HAND42/Polydog-Robotic_Project_2022-2023/session-reports/reports_younes-bazi/session4/session4.md

# SESSION 4 OUTCOME REPORT
## Date: 15/11/2022
## Main event of the session: Inverse Kinematics.
As i was searching for more informations about the stabilization of the robot, I found that the study of inverse Kinematics are essential for the balance of the Polydog, because Inverse kinematics is the use of kinematic equations to determine the motion of a robot to reach a desired position, it is used to compute an appropriate state in a robot's configuration space, given a target position in task space, in the other hand PID control applies responsive correction signals to a robot's actuators, allowing it to reach its target accurately. A reliable inverse kinematic solution is NECESSARY for programming a robot to perform tasks, this why I decided to do an inverse kinematics study of our robot before we go on with the PID tuning .  
First thing first , our robot has 4 legs and each one has 3 movable parts (3DOF) which makes it a total of 12 joint angles that we should determine. But in order to make things more easier, we are going to implement Kinematics of the PolyDog on Python. And to verify all the calculations happening here, it is helpful to have some kind of visual output ,so we are going to use Matplotlib.   
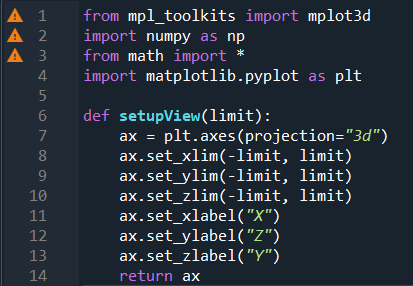
[picture p71: session-reports/reports_younes-bazi/session4/Capture d’écran 2022-11-18 231915.png]
  
We then start with solving the Leg's Inverse Kinematics and calculate (theta1,theta2,theta3) our output angles for a given Foot-Position (x,y,z) in Leg-Space. The Leg's origin (the shoulder) is at (0,0,0). l1,l2,l3 and l4 are the length of the Leg's Segments.  
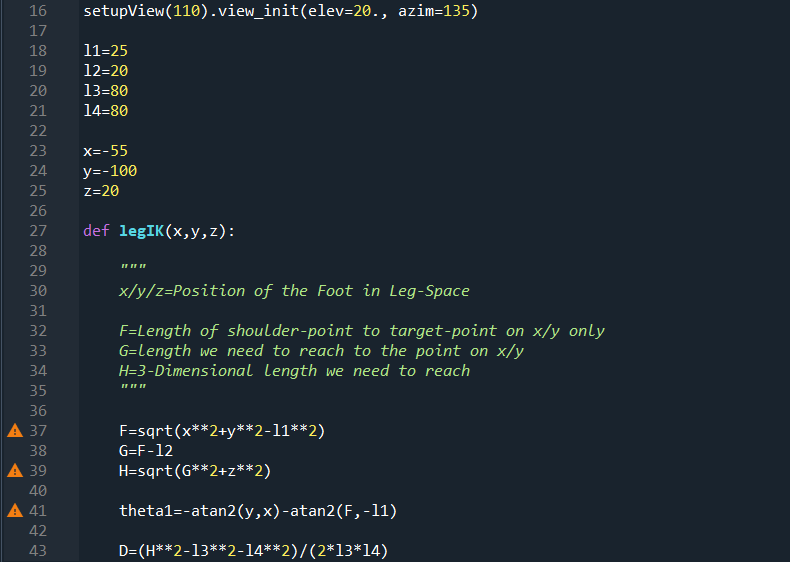
[picture p72: session-reports/reports_younes-bazi/session4/Capture d’écran 2022-11-18 232825.png]
  
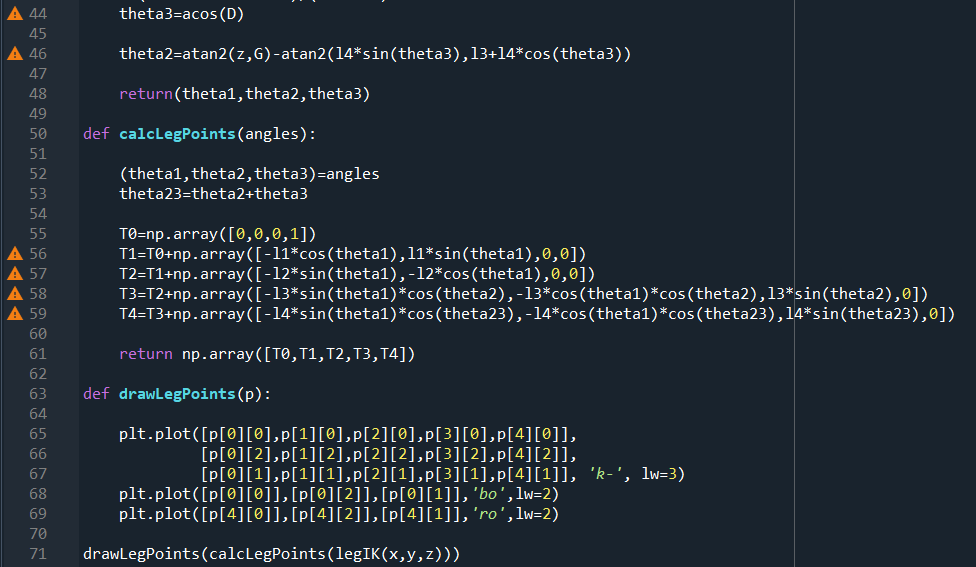
[picture p73: session-reports/reports_younes-bazi/session4/Capture d’écran 2022-11-18 232921.png]
  
Here is the result :  
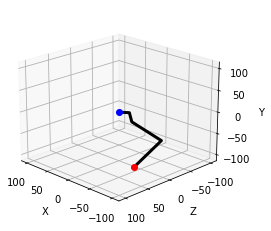
[picture p74: session-reports/reports_younes-bazi/session4/Figure 2022-11-18 233309.png]
  
And now the code works , we can test some different Target-Positions.  
  
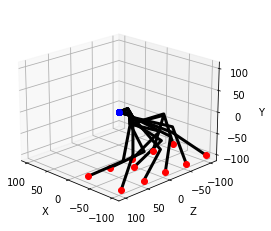
[picture p75: session-reports/reports_younes-bazi/session4/Figure 2022-11-18 234242.png]
  
To be able to calculate a Leg's Pose, we need to know where it starts when the Body has a specific Pose. The Pose is defined by omega,phi and psi (Remember, these are the Euler angles that the 10 DOF sensor will provide us with) and xm,ym and zm are the Center of the Body.  
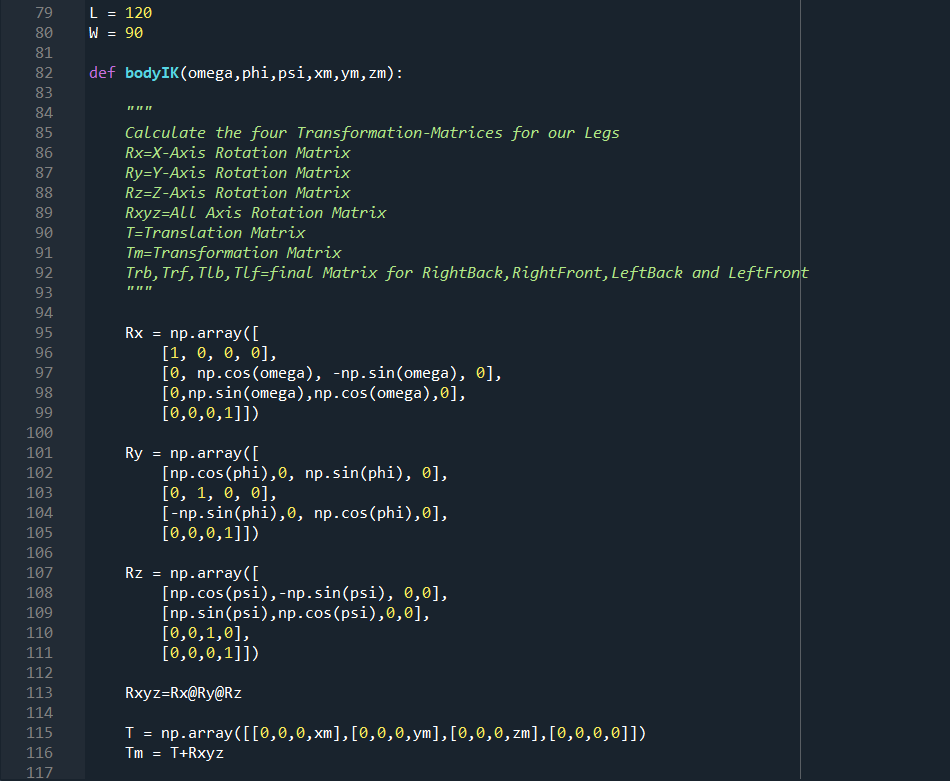
[picture p76: session-reports/reports_younes-bazi/session4/Capture d’écran 2022-11-18 235415.png]
  
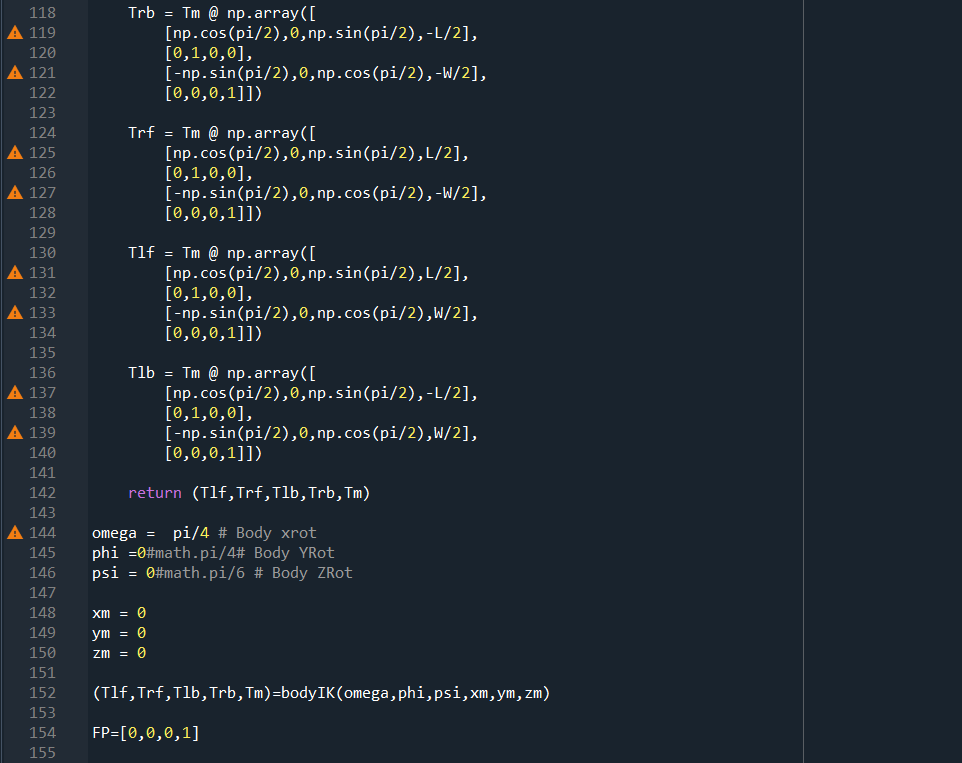
[picture p77: session-reports/reports_younes-bazi/session4/Capture d’écran 2022-11-18 235441.png]
  
  
Here is the result for the body Part :  
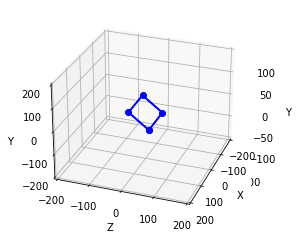
[picture p78: session-reports/reports_younes-bazi/session4/Figure 2022-11-18 235512.png]
  
Now we need to combine the Body's Kinematics with the four Legs. Input will be the Body-Pose (omega,phi,psi,xm,ym,zm) that will be given by the 10 DOF sensor and Positions for all four Legs in World-Space (Lp).  
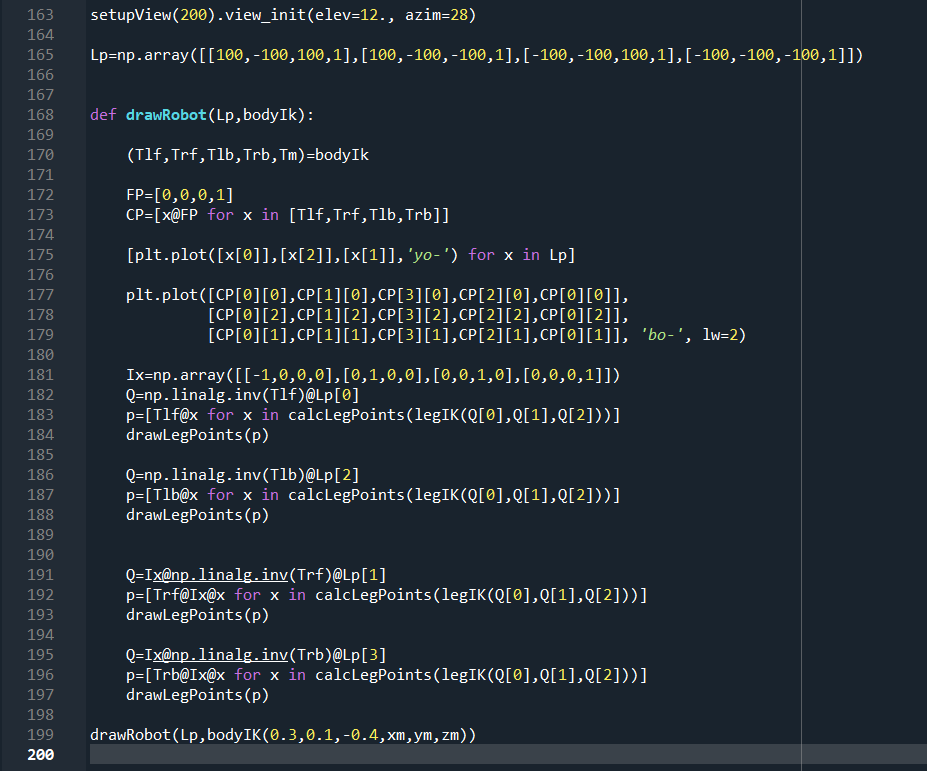
[picture p79: session-reports/reports_younes-bazi/session4/Capture d’écran 2022-11-19 000535.png]
  
  
We can now apply some random poses on the Robot's Body to verify the correctness of all Legs.  
  
  
Now the calculations work, i will try next week to implement kinemactis on the arduino board , and try to do some poses on the real Polydog to see if it really works in real life.
