HAND42/Polydog-Robotic_Project_2022-2023/session-reports/reports_hugo-durand/session16/Equation.docx

According to the Al Kashi's theorem

CH^2 =CD^2 +DH^2 -2×DH×CD×cos(Ω)

So Ω=cos^(-1) ((DE^2 +CD^2 -CE²)/(2×CD×DE))

γ=π-(π/2-θ)-Ω=(π/2+θ)-Ω

(Valid for both configurations)

α=π/2+γ

( γ is negative or positive)

AH=√(DA^2 +DH^2 -2×DA×DH×cos(α))

Փ=cos^(-1) ((-DH^2 +DA^2 +AH²)/(2×DA×AH))

EG=sin⁡(abs(β-Փ))×AH

{, AG=cos⁡(abs(β-Փ))×AH+HE, EG=sin(abs(β-Փ))×AH

Finally, the Cartesian coordinates of the foot are:

OE=(OA×sin(φ)+AG)*z+EG*y+OA×cos⁡(φ)*x

We define hip_angle = Ħ and knee_angle = ĸ

Knowing the position of the leg AE, we have:

HA=√(EG^2 +(AG-HE)²)

We can define ε=cos^(-1) (((AG-HE))/(AH))

Փ=cos^(-1) ((-DH^2 +DA^2 +AH²)/(2×DA×AH))

α= cos^(-1) ((DH^2 +DA^2 -AH²)/(2×DA×DH))

Ħ =π/2-Փ-ε or Ħ =π/2-Փ+ε

Depends on if the leg is in front or behind the hip

ĸ=θ-Ħ

ĸ=Ω-π/2-Ħ+γ or ĸ=Ω-π/2-Ħ -γ

ĸ=Ω+α-π-Ħ or ĸ=Ω-α-Ħ

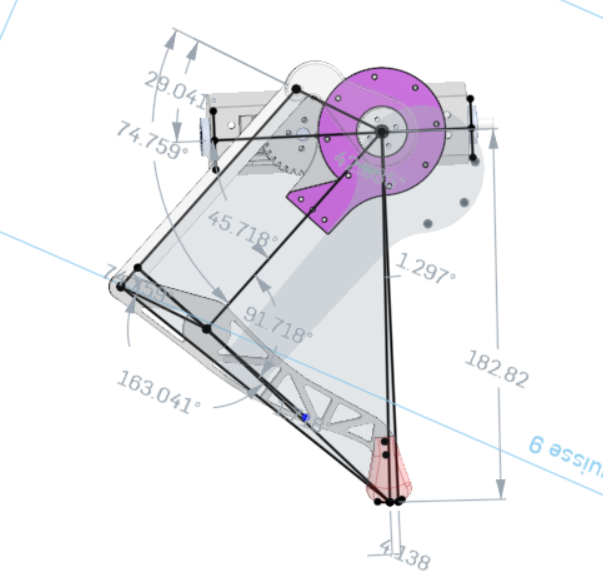
[picture p112: figure]
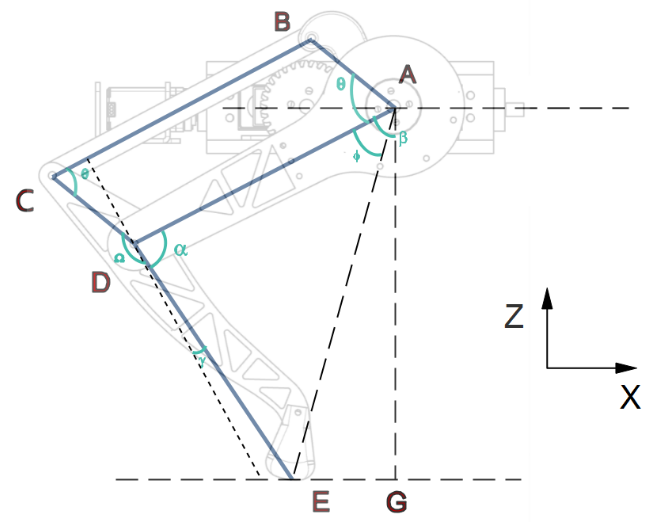
[picture p113: figure]
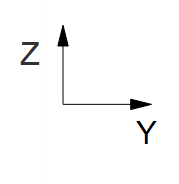
[picture p114: figure]
