HAND42/Polydog-Robotic_Project_2022-2023/CODE/NVIDIA/TD-9-11-22/younes-bazi-linux-project/Linux_project/younes-bazi-linux-project/td linux/Capture d’écran 2022-11-23 160426.png

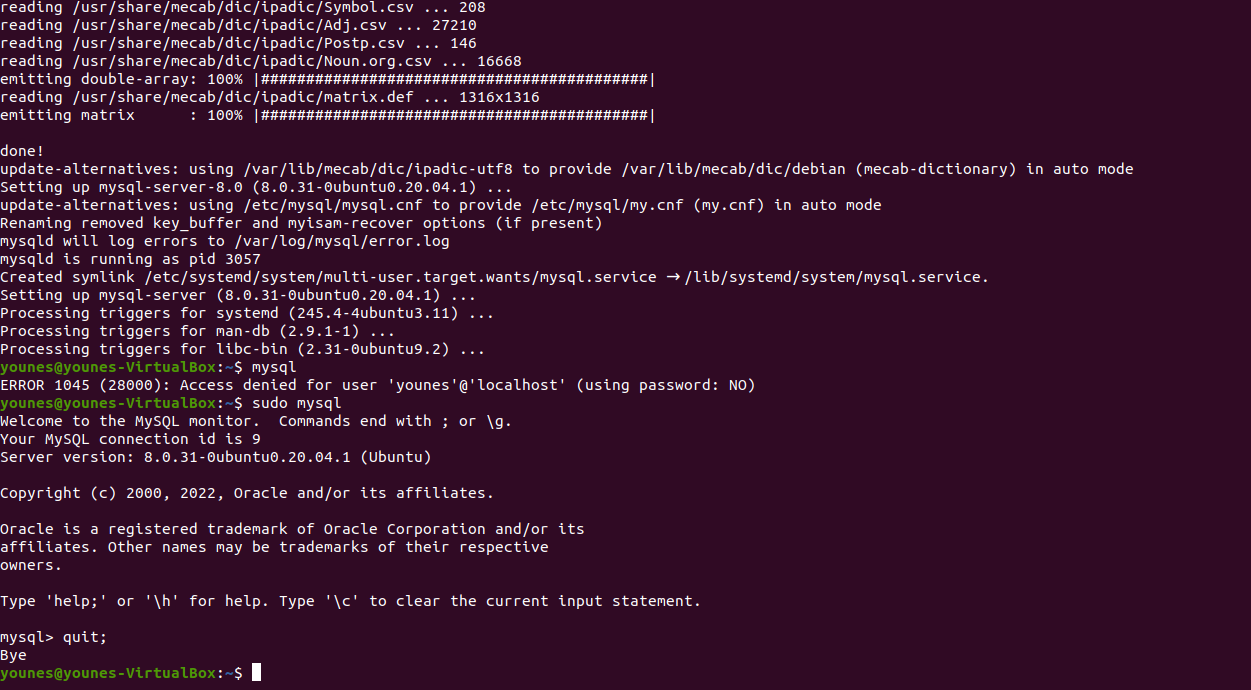
CODE/NVIDIA/TD-9-11-22/younes-bazi-linux-project/Linux_project/younes-bazi-linux-project/td linux/Capture d’écran 2022-11-23 160426.png
