HAND42/Polydog-Robotic_Project_2022-2023/Drone Interception/Unreal engine/simulation/Saved/AutoScreenshot.png

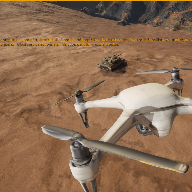
Drone Interception/Unreal engine/simulation/Saved/AutoScreenshot.png
