HAND42/Polydog-Robotic_Project_2022-2023/Multimedia/WhatsApp Image 2022-07-30 at 16.42.59.jpeg

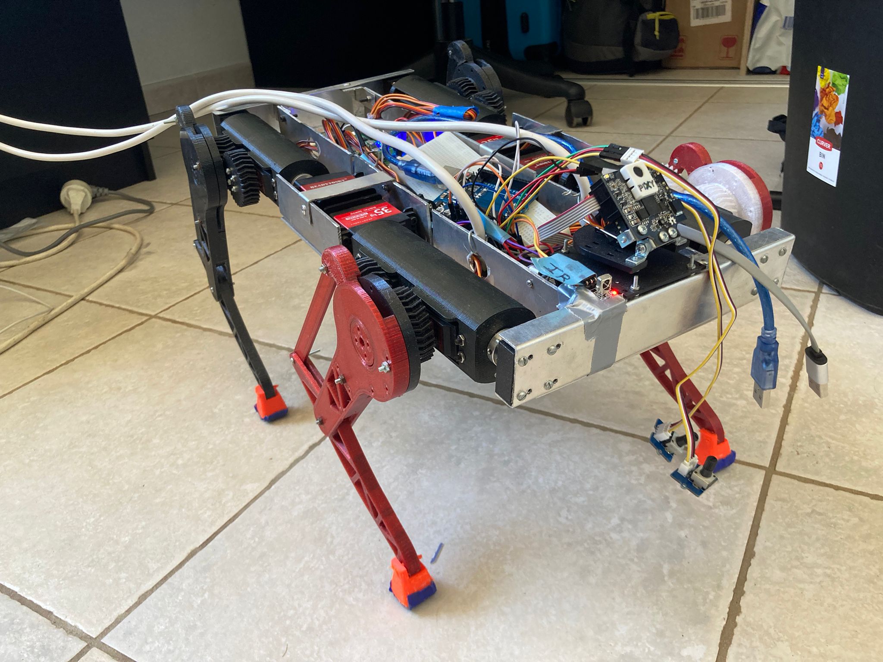
Multimedia/WhatsApp Image 2022-07-30 at 16.42.59.jpeg
