HAND42/Polydog-Robotic_Project_2022-2023/session-reports/reports_hugo-durand/session1/gear_pla.jpeg

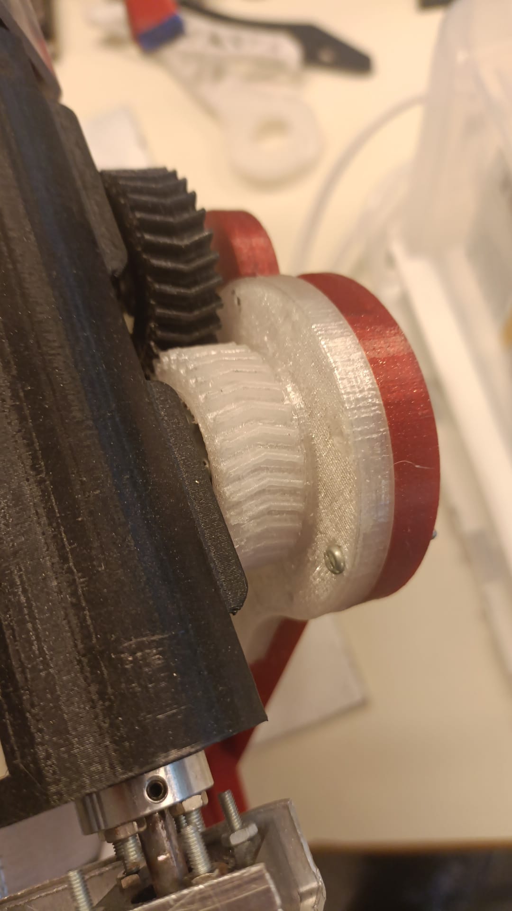
session-reports/reports_hugo-durand/session1/gear_pla.jpeg
