HAND42/Polydog-Robotic_Project_2022-2023/session-reports/reports_hugo-durand/session1/image_robot_session1.jpeg

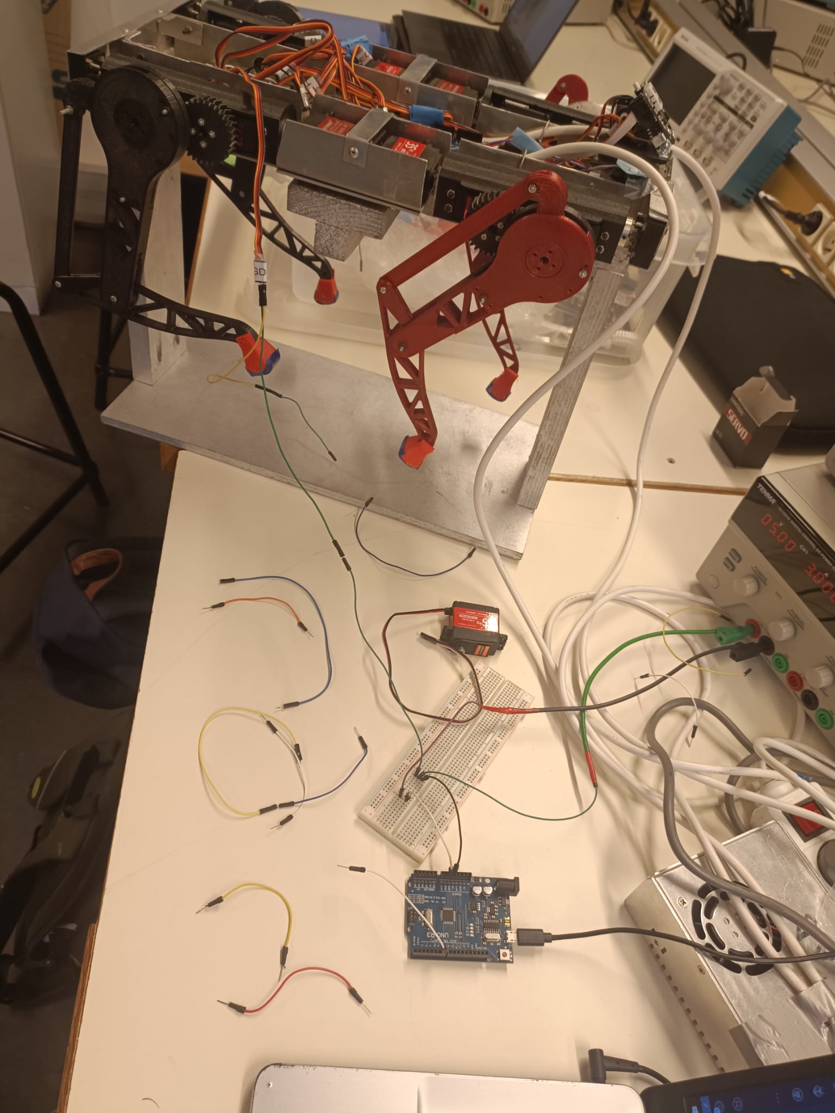
session-reports/reports_hugo-durand/session1/image_robot_session1.jpeg
