HAND42/Polydog-Robotic_Project_2022-2023/session-reports/reports_hugo-durand/session2/robots_standing_up_again.jpeg

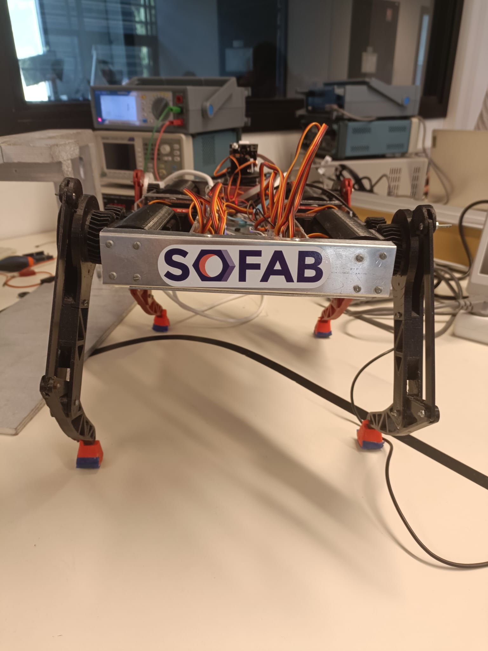
session-reports/reports_hugo-durand/session2/robots_standing_up_again.jpeg
