HAND42/Polydog-Robotic_Project_2022-2023/session-reports/reports_hugo-durand/session3/female_conector.jpeg

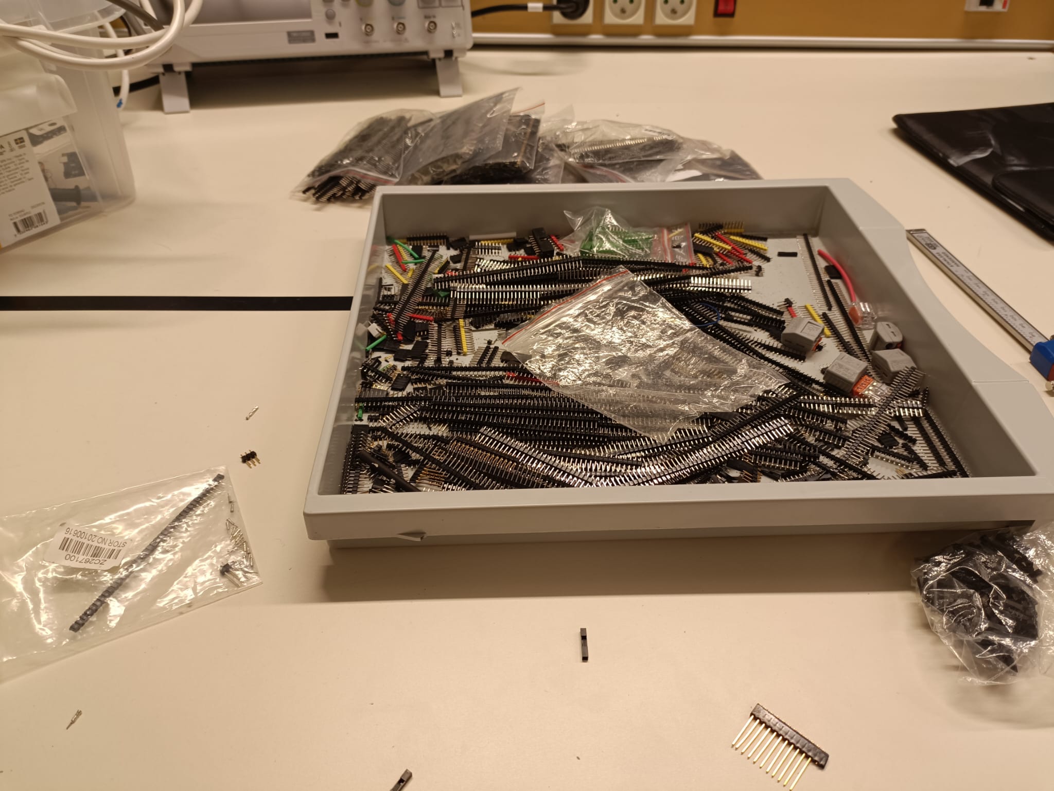
session-reports/reports_hugo-durand/session3/female_conector.jpeg
