HAND42/Polydog-Robotic_Project_2022-2023/session-reports/reports_hugo-durand/session4/errors.PNG

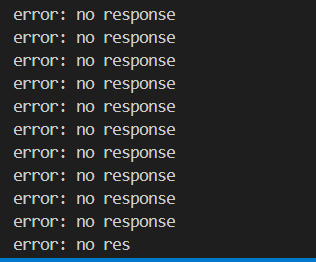
session-reports/reports_hugo-durand/session4/errors.PNG
