HAND42/Polydog-Robotic_Project_2022-2023/session-reports/reports_hugo-durand/session5/WhatsApp Image 2022-12-02 at 09.24.47.jpeg

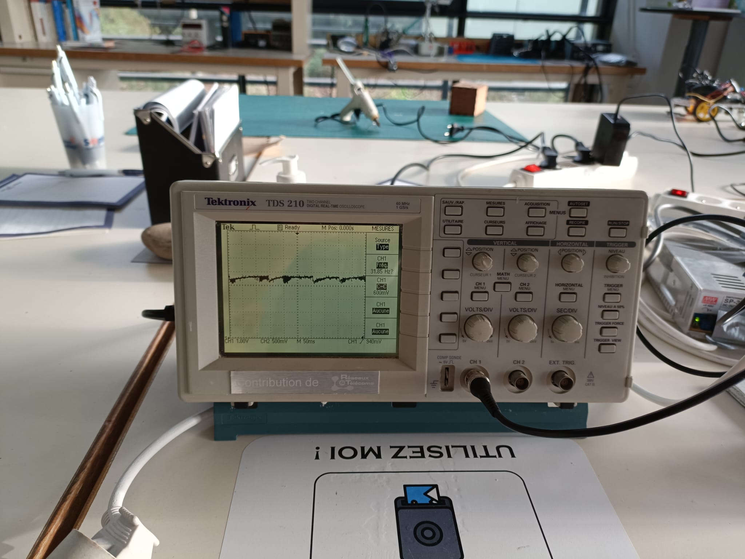
session-reports/reports_hugo-durand/session5/WhatsApp Image 2022-12-02 at 09.24.47.jpeg
