HAND42/Polydog-Robotic_Project_2022-2023/session-reports/reports_hugo-durand/session16/Equation_angle_of_the_foot.png

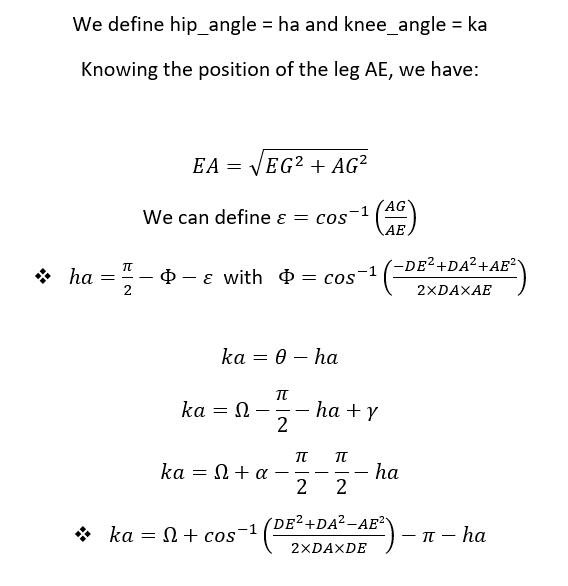
session-reports/reports_hugo-durand/session16/Equation_angle_of_the_foot.png
