HAND42/Polydog-Robotic_Project_2022-2023/session-reports/reports_younes-bazi/session5/Session05/20221126_153211.jpg

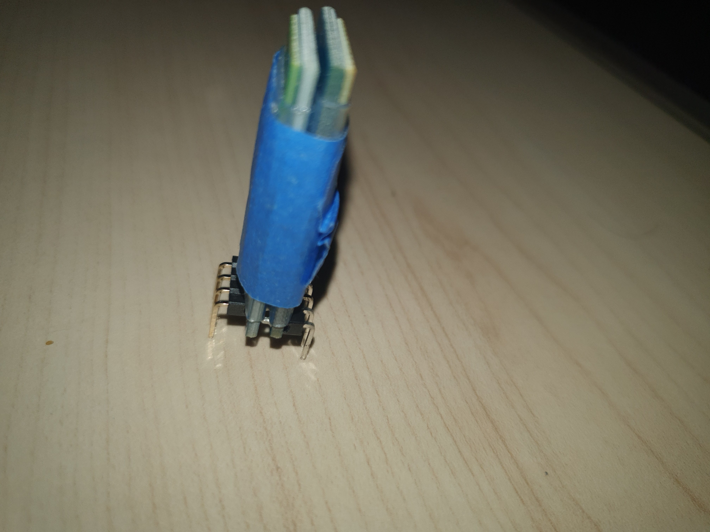
session-reports/reports_younes-bazi/session5/Session05/20221126_153211.jpg
