HAND42/Polydog-Robotic_Project_2022-2023/session-reports/reports_younes-bazi/session6/S6/20221209_115030.jpg

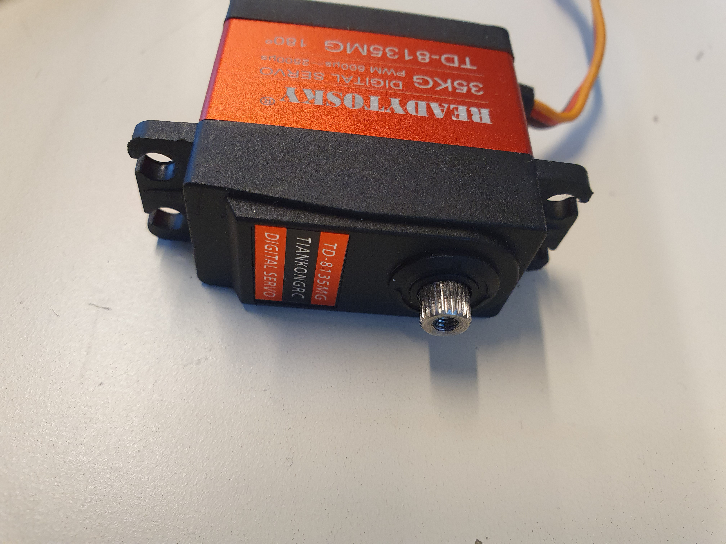
session-reports/reports_younes-bazi/session6/S6/20221209_115030.jpg
