HAND42/Polydog-Robotic_Project_2022-2023/material and engineer cost.xlsx

Material name | Type of material | Price (in €)
Arduino UNO | Electronic Component | 20 | Material | Price (in €)
Ssc-32 Servo controller | Electronic Component | 22.33 | Electronic Component | 212.45
Servo motors | Electronic Component | 106.08 | 3D Printing | 14.32
10 DOF Accelerometer | Electronic Component | 6.49 | Aluminium | 13.2
HC-O5 Bluetooth module | Electronic Component | 3.87 | Accessories | 14.8
Arduino Esplora Remote | Electronic Component | 53.68 | SOUS-TOTAL | 254.77
Printed parts (legs, boards and bearings support,..) | 3D printing | 14.32
Aluminum plate | Aluminium | 7.2 | Cost engineer | Hoorly rate (23.75 €/h)
Aluminium square | Aluminium | 3.6 | Sessions in robotics class | 172
Aluminium square for bearings | Aluminium | 2.4 | Sessions at home | 160
Servo horns (hip and knee) | Accesorries | 6.8 | SOUS-TOTAL | 7885
Squash balls | Accesorries | 8 | TOTAL | 8139.77
 |  |  | S
