HAND42/Polydog-Robotic_Project_2022-2023/Boitier_Arduino/Durand Hugo/Plastic_component.3mf

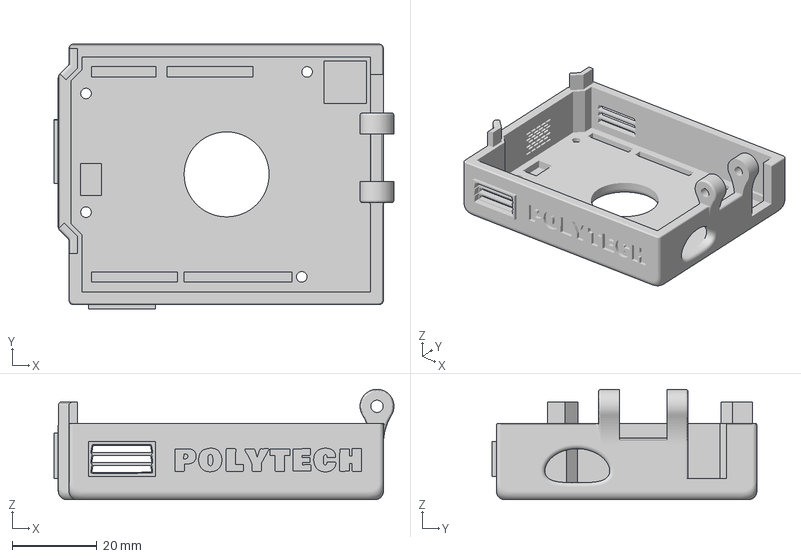
[picture p151: CAD file, 2023-01-20]
Boitier_Arduino/Durand Hugo/Plastic_component.3mf
80.1 x 62.3 x 26.0 mm
