HAND42/Polydog-Robotic_Project_2022-2023/new-3D-printed-part/boitier v2 - boitier.stl

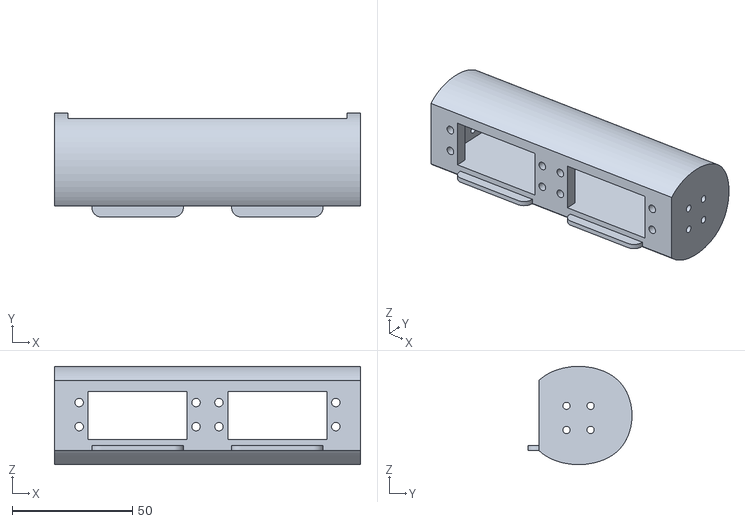
[picture p152: CAD file, 2022-10-14]
new-3D-printed-part/boitier v2 - boitier.stl
127.0 x 43.2 x 40.8
