HAND42/Polydog-Robotic_Project_2022-2023/polydog_ws_ROS/polydog_ws/polydog_ws/src/polydog_description/meshes/case_collision.obj

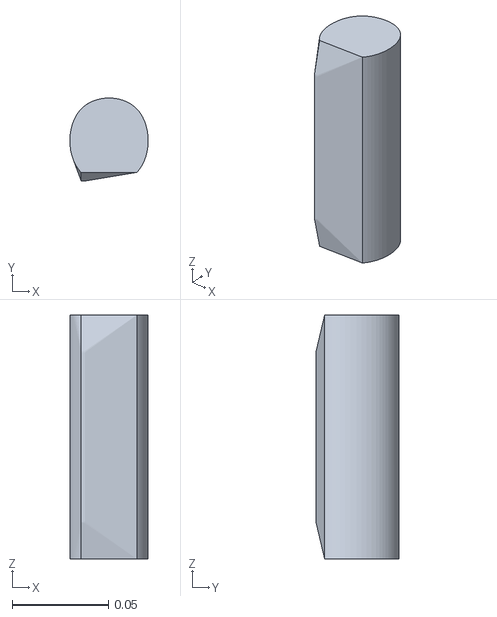
[picture p153: CAD file, 2025-01-26]
polydog_ws_ROS/polydog_ws/polydog_ws/src/polydog_description/meshes/case_collision.obj
0.0408 x 0.0432 x 0.127
