HAND42/Polydog-Robotic_Project_2022-2023/Boitier_Arduino/Durand Hugo/Plastic_link_component.3mf

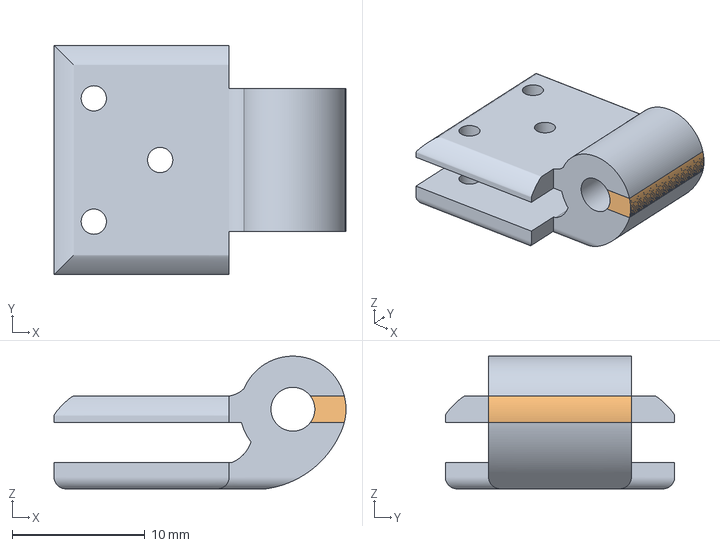
[picture p154: CAD file, 2023-01-20]
Boitier_Arduino/Durand Hugo/Plastic_link_component.3mf
22.0 x 17.3 x 10.00 mm
Corps1
Corps2
