HAND42/Polydog-Robotic_Project_2022-2023/polydog_ws_ROS/polydog_ws/polydog_ws/src/polydog_description/meshes/femur.obj

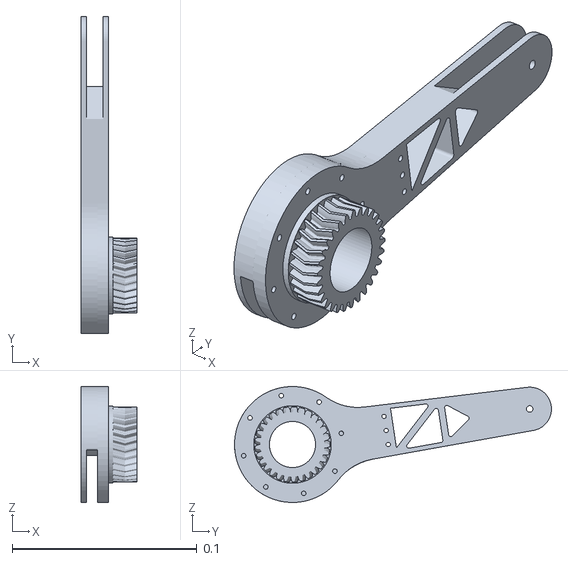
[picture p156: CAD file, 2025-01-26]
polydog_ws_ROS/polydog_ws/polydog_ws/src/polydog_description/meshes/femur.obj
0.0303 x 0.172 x 0.0629
