HAND42/Polydog-Robotic_Project_2022-2023/polydog_ws_ROS/polydog_ws/polydog_ws/src/polydog_description/meshes/body_collision.obj

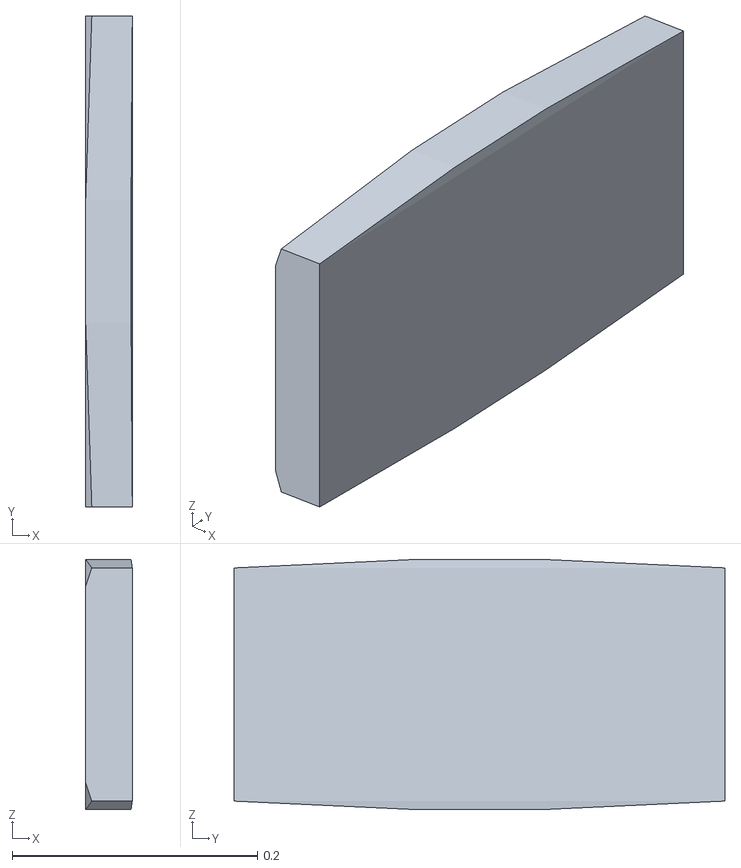
[picture p157: CAD file, 2025-01-26]
polydog_ws_ROS/polydog_ws/polydog_ws/src/polydog_description/meshes/body_collision.obj
0.038 x 0.4 x 0.204
