HAND42/Polydog-Robotic_Project_2022-2023/polydog_ws_ROS/polydog_ws/polydog_ws/src/polydog_description/meshes/tibia.obj

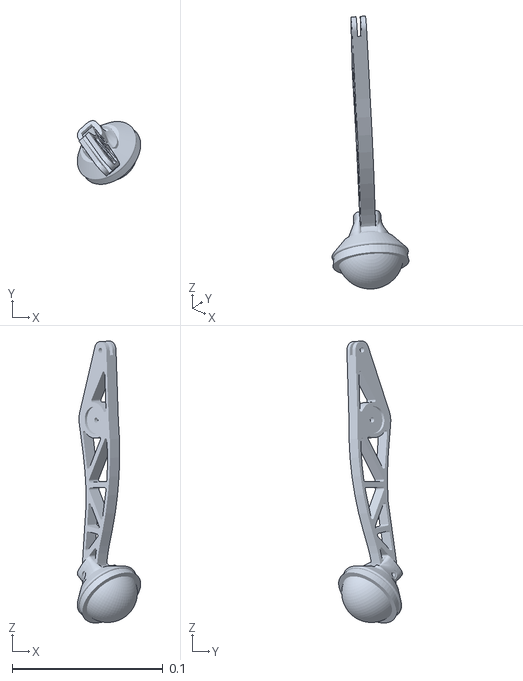
[picture p158: CAD file, 2025-01-26]
polydog_ws_ROS/polydog_ws/polydog_ws/src/polydog_description/meshes/tibia.obj
0.0421 x 0.0423 x 0.187
