HAND42/Polydog-Robotic_Project_2022-2023/(list of files, cad)

Other CAD files:
Boitier_Arduino/Durand Hugo/ArduinoUNO-Housing.f3d
Boitier_Arduino/Younes-Bazi/Boitier Arduino v1.f3d
