HAND42/Polydog-Robotic_Project_2022-2023/NVIDIA/TD-9-11-22/younes-bazi-linux-project/Linux_project/younes-bazi-linux-project/setup-dump-database-logs-cleanup.md

In order to modify the size of the logfile of the script we use this command :  
truncate -s 500 MB /var/log/yourlogfile  
if we assume that we delete the data from the file when it reaches 500 MB with this command :  
if [ "$logfile" -gt 500 MB ]   
then   
    truncate -s 0 $logfile  
    
fi  
Then we can choose a size limit that only dumps the logs when the file has done a number of repetitions we determined.
