HAND42/Polydog-Robotic_Project_2022-2023/NVIDIA/TD-9-11-22/younes-bazi-linux-project/Linux_project/younes-bazi-linux-project/setup-dump-database-service.md

we create the service "dump-database.service" using this command :  
sudo touch /etc/systemd/system/dump-database.service  
with this command :  
sudo systemctl daemon-reload  
we can reload the system , return all generators, reload all unit files, and recreate the entire dependency tree.
we Then start the service with this command :  
sudo systemctl start dump-database.service  
to see the status of the service we type this command :  
sudo systemctl status dump-database.service
