HAND42/Polydog-Robotic_Project_2022-2023/NVIDIA/TD-9-11-22/younes-bazi-linux-project/Linux_project/younes-bazi-linux-project/Setup-Mysql.md

 In order to insatll Mysql on our VM, we need to update first the packages with this command:  
sudo apt update  
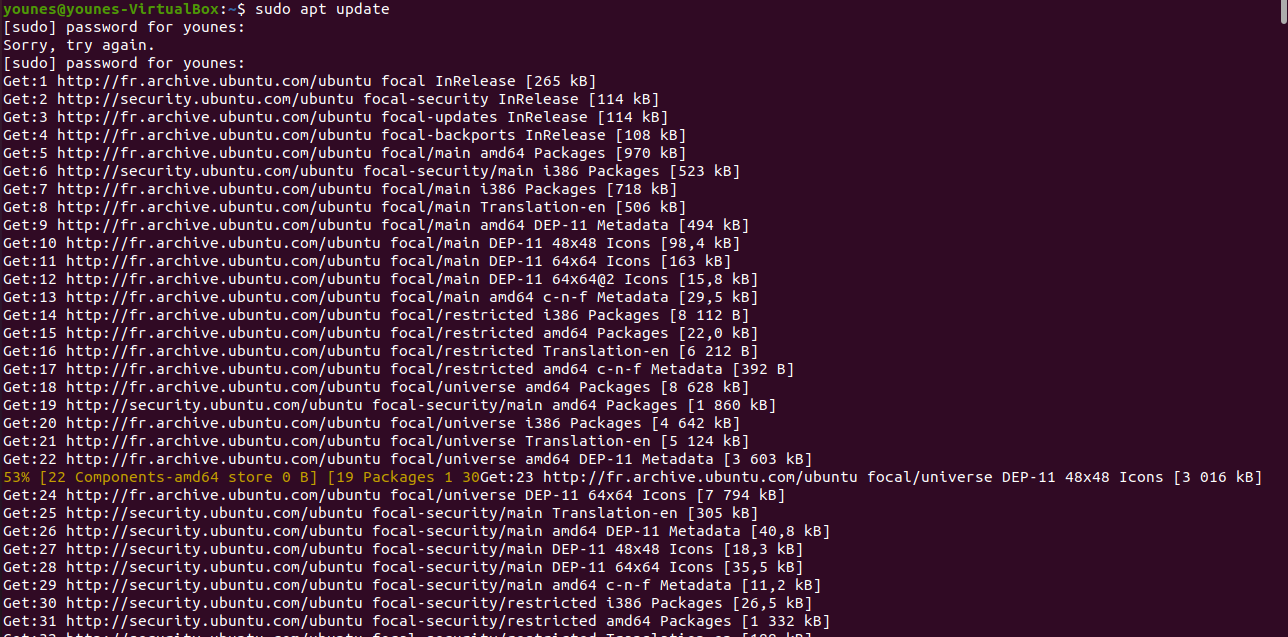
[picture p190: NVIDIA/TD-9-11-22/younes-bazi-linux-project/Linux_project/younes-bazi-linux-project/td linux/Capture d’écran 2022-11-23 160326.png]
  
Then we can start the installation of Mysql with this command :    
sudo apt install mysql-server    
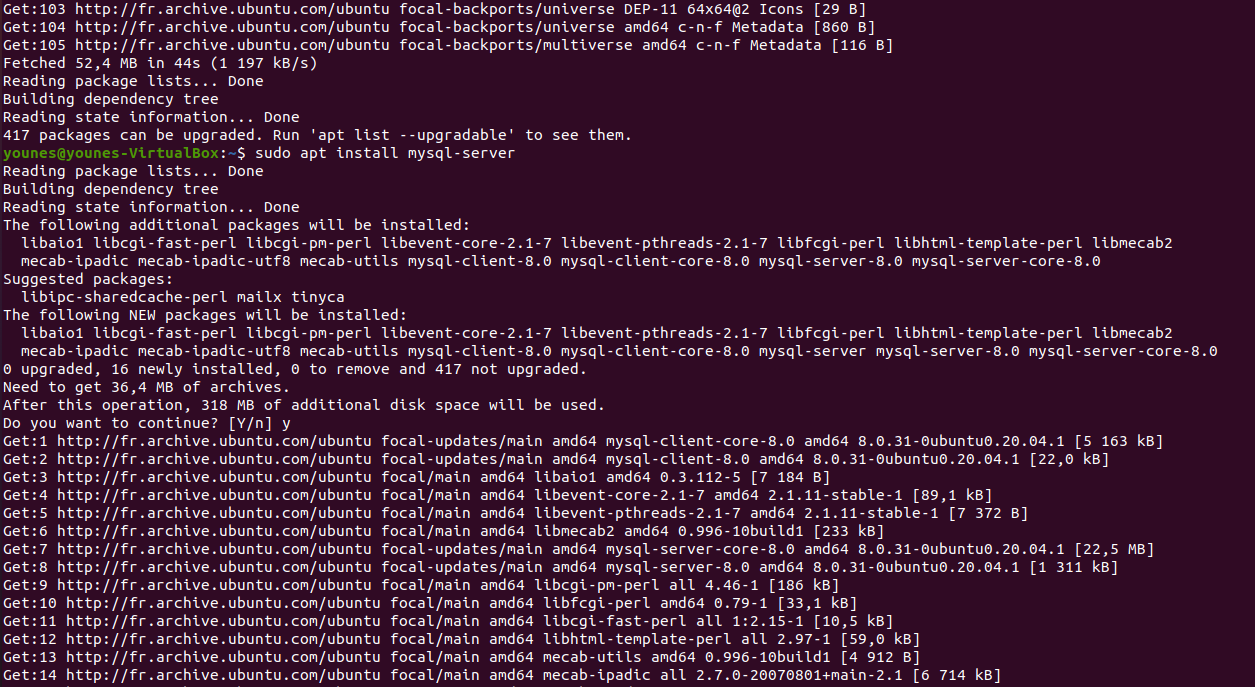
[picture p191: NVIDIA/TD-9-11-22/younes-bazi-linux-project/Linux_project/younes-bazi-linux-project/td linux/Capture d’écran 2022-11-23 160406.png]

To creat a database from the following backup file: https://www.mysqltutorial.org/wp-content/uploads/2018/03/mysqlsampledatabase.zip, we download it first, and then we unzip it using the following command :  
cd ~/Downloads  
unzip mysqlsampledatabase.zip   
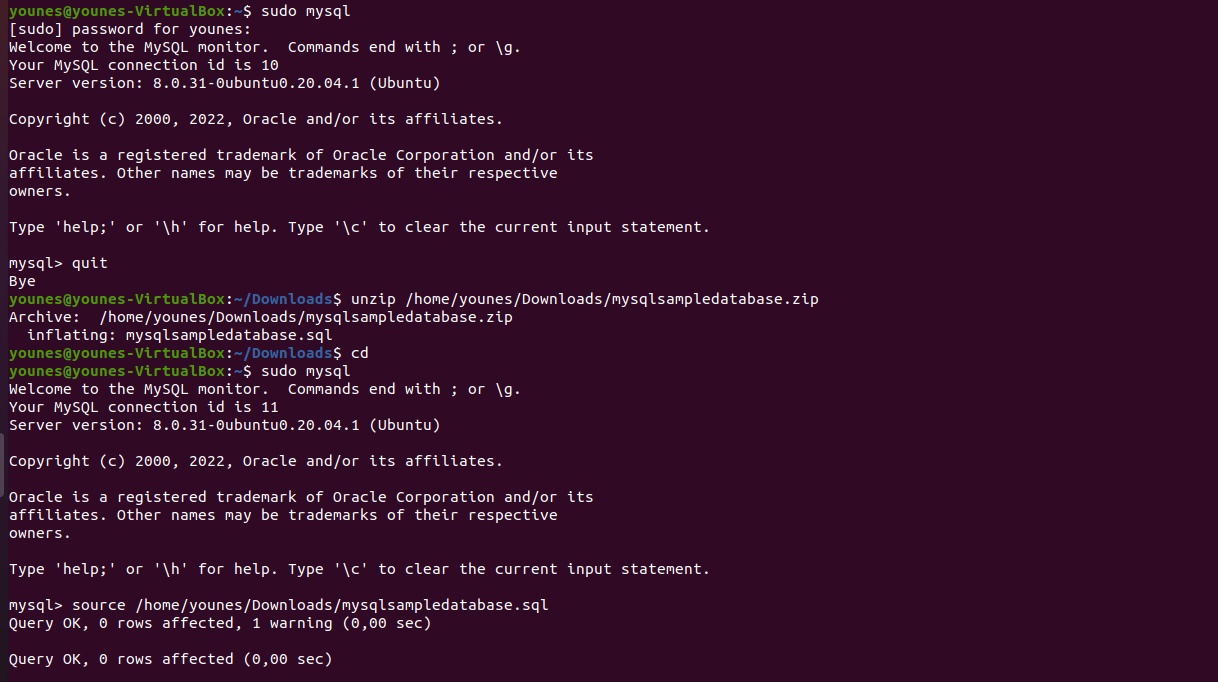
[picture p192: NVIDIA/TD-9-11-22/younes-bazi-linux-project/Linux_project/younes-bazi-linux-project/td linux/Capture d’écran 2022-11-23 160825.png]

and then we enter to mysql using :  
sudo mysql  
And then we declare the new database using this command :  
source /home/younes/Downloads/mysqlsampledatabase.sql  
And finally we can show the database by using this command :  
show databases;
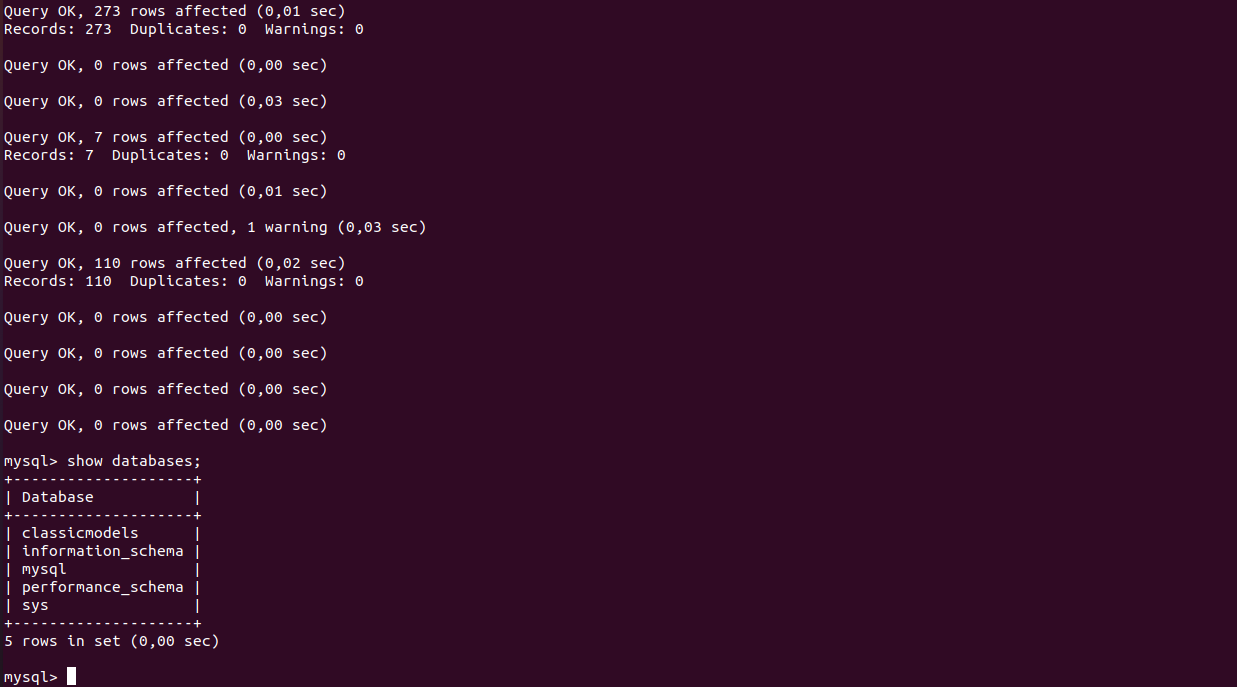
[picture p193: NVIDIA/TD-9-11-22/younes-bazi-linux-project/Linux_project/younes-bazi-linux-project/td linux/Capture d’écran 2022-11-23 160843.png]
