HAND42/Polydog-Robotic_Project_2022-2023/CODE/NVIDIA/Robotic_project/Getting_started-images/disk.jpeg

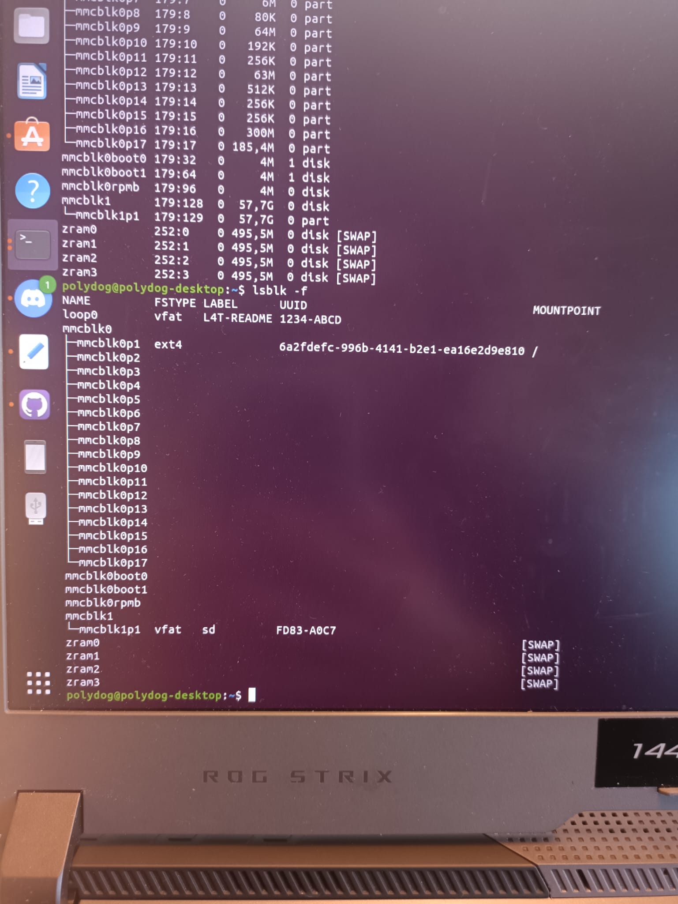
CODE/NVIDIA/Robotic_project/Getting_started-images/disk.jpeg
