HAND42/Polydog-Robotic_Project_2022-2023/session-reports/reports_hugo-durand/session1/movement_alimented_acpowersupply_test1.gif

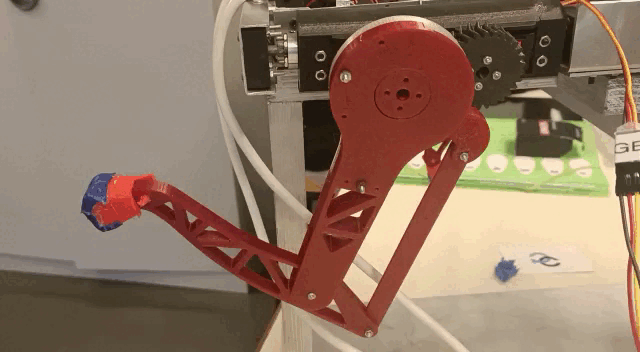
session-reports/reports_hugo-durand/session1/movement_alimented_acpowersupply_test1.gif
