HAND42/Polydog-Robotic_Project_2022-2023/session-reports/reports_younes-bazi/poly/polydog.urdf

<?xml version="1.0"?>
<robot name="Body">
    <link name="robot_base">
        <inertial>
            <origin rpy="-0.000000 -1.570796 0.000000" xyz="3.085511 -5.252829 0.187957" />
            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
            <mass value="2.4" />
        </inertial>
        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
    </link>
    <joint type="revolute" name="Shoulder4">
        <axis xyz="0 0 1" />
        <limit velocity="6.2831854820251" lower="-3.1415927410126" effort="2.5" upper="3.1415927410126" />
        <parent link="robot_base" />
        <child link="Case4" />
        <origin rpy="3.078568 1.588567 -0.083163" xyz="2.955599 -5.173379 0.196405" />
    </joint>
    <link name="Case4">
        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
    </link>
    <joint type="revolute" name="Hip4">
        <axis xyz="0 0 1" />
        <limit velocity="6.2831854820251" lower="-3.1415927410126" effort="2.5" upper="3.1415927410126" />
        <parent link="Case4" />
        <child link="Femur4" />
        <origin rpy="1.570796 -1.570796 0.000000" xyz="-0.000000 0.005000 0.021000" />
    </joint>
    <link name="Femur4">
        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
    </link>
    <joint type="revolute" name="Knee4">
        <axis xyz="0 0 1" />
        <limit velocity="6.2831854820251" lower="-3.1415927410126" effort="2.5" upper="3.1415927410126" />
        <parent link="Femur4" />
        <child link="Tibia4" />
        <origin rpy="-3.141593 3.141593 -3.141593" xyz="0.078146 -0.104211 0.032297" />
    </joint>
    <link name="Tibia4">
        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
    </link>
    <joint type="revolute" name="Shoulder1">
        <axis xyz="0 0 1" />
        <limit velocity="6.2831854820251" lower="-3.1415927410126" effort="2.5" upper="3.1415927410126" />
        <parent link="robot_base" />
        <child link="Case1" />
        <origin rpy="3.078568 1.588567 -0.083163" xyz="3.193513 -5.178169 0.192184" />
    </joint>
    <link name="Case1">
        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
    </link>
    <joint type="revolute" name="Hip1">
        <axis xyz="0 0 1" />
        <limit velocity="6.2831854820251" lower="-3.1415927410126" effort="2.5" upper="3.1415927410126" />
        <parent link="Case1" />
        <child link="Femur1" />
        <origin rpy="1.570796 -1.570796 0.000000" xyz="-0.000000 0.005000 -0.041000" />
    </joint>
    <link name="Femur1">
        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
    </link>
    <joint type="revolute" name="Knee1">
        <axis xyz="0 0 1" />
        <limit velocity="6.2831854820251" lower="-3.1415927410126" effort="2.5" upper="3.1415927410126" />
        <parent link="Femur1" />
        <child link="Tibia1" />
        <origin rpy="-3.141593 3.141593 -3.141593" xyz="0.078146 -0.104211 0.032297" />
    </joint>
    <link name="Tibia1">
        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
    </link>
    <joint type="revolute" name="Shoulder3">
        <axis xyz="0 0 1" />
        <limit velocity="6.2831854820251" lower="-3.1415927410126" effort="2.5" upper="3.1415927410126" />
        <parent link="robot_base" />
        <child link="Case3" />
        <origin rpy="3.078568 1.588567 -0.083163" xyz="2.950617 -5.321309 0.196275" />
    </joint>
    <link name="Case3">
        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
    </link>
    <joint type="revolute" name="Hip3">
        <axis xyz="0 0 1" />
        <limit velocity="6.2831854820251" lower="-3.1415927410126" effort="2.5" upper="3.1415927410126" />
        <parent link="Case3" />
        <child link="Femur3" />
        <origin rpy="1.570796 -1.570796 0.000000" xyz="-0.000000 0.005000 0.021000" />
    </joint>
    <link name="Femur3">
        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
    </link>
    <joint type="revolute" name="Knee3">
        <axis xyz="0 0 1" />
        <limit velocity="6.2831854820251" lower="-3.1415927410126" effort="2.5" upper="3.1415927410126" />
        <parent link="Femur3" />
        <child link="Tibia3" />
        <origin rpy="-3.141593 3.141593 -3.141593" xyz="0.076146 -0.104211 -0.023703" />
    </joint>
    <link name="Tibia3">
        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
    </link>
    <joint type="revolute" name="Shoulder2">
        <axis xyz="0 0 1" />
        <limit velocity="6.2831854820251" lower="-3.1415927410126" effort="2.5" upper="3.1415927410126" />
        <parent link="robot_base" />
        <child link="Case2" />
        <origin rpy="3.078568 1.588567 -0.083163" xyz="3.190531 -5.326139 0.192018" />
    </joint>
    <link name="Case2">
        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
    </link>
    <joint type="revolute" name="Hip2">
        <axis xyz="0 0 1" />
        <limit velocity="6.2831854820251" lower="-3.1415927410126" effort="2.5" upper="3.1415927410126" />
        <parent link="Case2" />
        <child link="Femur2" />
        <origin rpy="1.570796 -1.570796 0.000000" xyz="-0.000000 0.005000 -0.041000" />
    </joint>
    <link name="Femur2">
        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
    </link>
    <joint type="revolute" name="Knee2">
        <axis xyz="0 0 1" />
        <limit velocity="6.2831854820251" lower="-3.1415927410126" effort="2.5" upper="3.1415927410126" />
        <parent link="Femur2" />
        <child link="Tibia2" />
        <origin rpy="-3.141593 3.141593 -3.141593" xyz="0.076146 -0.104211 -0.023703" />
    </joint>
    <link name="Tibia2">
        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
    </link>
</robot>
