HAND42/Polydog-Robotic_Project_2022-2023/Code_plateformio/src/Leg/Leg.h

// Copyright (c) 2022-2022. ANJOU Raphaël & DURAND Hugo
//
// Licensed under the Apache License, Version 2.0 (the "License");
// you may not use this file except in compliance with the License.
// You may obtain a copy of the License at
//
// http://www.apache.org/licenses/LICENSE-2.0
//
// Unless required by applicable law or agreed to in writing, software
// distributed under the License is distributed on an "AS IS" BASIS,
// WITHOUT WARRANTIES OR CONDITIONS OF ANY KIND, either express or implied.
// See the License for the specific language governing permissions and
// limitations under the License.

/**
 * @file Leg.h
 *
 * @brief Leg object used to control one leg of the robot
 *
 * @author ANJOU Raphael
 * <p>
 * Contact: anjou.raphael\@gmail.com
 *
 */

#ifndef LEG_H
#define LEG_H

#include <Arduino.h>
#include "CustomServo/CustomServo.h"

/**
 * A {@code Leg} object allows you to control one of the robot leg.
 *
 * The leg that is controlled can be chosen when initializing with the parameter {@code leg_number}
 *
 * There are many constants and they are all specific to a certain leg.
 * Some are used to calculate correctly the angle to go to for the servos.
 * Some are used to assign which servos are used by the leg.
 *
 * @author ANJOU Raphael
 */
class Leg
{
public:
    /**
     * This method is the {@code Leg} initializer
     * @param leg_number The leg chosen, this value will affects which servos and constants are used
     */
    Leg(int leg_number);
    Leg();
    /**
     * This method will move the knee servo to the correct angle by considering the offsets constants
     * @param angle The desired angle to move the servo to
     */

    void move_knee(int angle);
    void move_knee_ms(int angle);

    /**
     * This method will move the hip servo to the correct angle by considering the offsets constants
     * @param angle The desired angle to move the servo to
     */

    void move_hip(int angle);
    void move_hip_ms(int angle);

    /**
     * This method will move the shoulder servo to the correct angle by considering the min and max constants
     * @param angle The desired angle to move the servo to
     */
    void move_shoulder(int angle);
    void move_shoulder_ms(int angle);

    /*
     *size of the square formed by the feet when the robot is in neutral position:
     * 26.5*28.5 (24.5)
     */

    // Constants for LEG A
    int OFFSET_KNEE_A = 0; // 10
    int OFFSET_HIP_A = -4;
    int ANGLE_MIN_SHOULDER_A = 190; // 160
    int ANGLE_MAX_SHOULDER_A = 10;  // -15
    CustomServo SERVO_SHOULDER_A = CustomServo(19);
    CustomServo SERVO_HIP_A = CustomServo(18);
    CustomServo SERVO_KNEE_A = CustomServo(17);

    // Constants for LEG B
    int OFFSET_KNEE_B = 175;
    int OFFSET_HIP_B = 190;
    int ANGLE_MIN_SHOULDER_B = 0;
    int ANGLE_MAX_SHOULDER_B = 180;
    CustomServo SERVO_SHOULDER_B = CustomServo(3);
    CustomServo SERVO_HIP_B = CustomServo(2);
    CustomServo SERVO_KNEE_B = CustomServo(1);

    // Constants for LEG C
    int OFFSET_KNEE_C = 193;
    int OFFSET_HIP_C = 160;
    int ANGLE_MIN_SHOULDER_C = 170;
    int ANGLE_MAX_SHOULDER_C = -10;
    CustomServo SERVO_SHOULDER_C = CustomServo(13);
    CustomServo SERVO_HIP_C = CustomServo(14);
    CustomServo SERVO_KNEE_C = CustomServo(15);

    // Constants for LEG D
    int OFFSET_KNEE_D = 3;
    int OFFSET_HIP_D = 0;
    int ANGLE_MIN_SHOULDER_D = 70;
    int ANGLE_MAX_SHOULDER_D = 250;
    CustomServo SERVO_SHOULDER_D = CustomServo(29);
    CustomServo SERVO_HIP_D = CustomServo(30);
    CustomServo SERVO_KNEE_D = CustomServo(31);

private:
    int _leg_number;
    int _knee_offset;
    int _hip_offset;
    int _ANGLE_MIN_SHOULDER;
    int _ANGLE_MAX_SHOULDER;
    CustomServo _knee_servo;
    CustomServo _hip_servo;
    CustomServo _shoulder_servo;
};
#endif
