HAND42/Polydog-Robotic_Project_2022-2023/Drone Interception/Unreal engine/simulation/Saved/Config/WindowsEditor/EditorPerProjectUserSettings.ini

;METADATA=(Diff=true, UseCommands=true)
[/Script/UnrealEd.EditorPerProjectUserSettings]
bDisplayDocumentationLink=False
bDisplayActionListItemRefIds=False
bAlwaysGatherBehaviorTreeDebuggerData=False
bDisplayBlackboardKeysInAlphabeticalOrder=False
bUseSimplygonSwarm=False
SimplygonServerIP=127.0.0.1
bEnableSwarmDebugging=False
SimplygonSwarmDelay=5000
SwarmNumOfConcurrentJobs=16
SwarmMaxUploadChunkSizeInMB=100
SwarmIntermediateFolder=C:/Users/hp/Documents/Unreal Projects/simulation/Intermediate/Simplygon/
bShowCompilerLogOnCompileError=False
DataSourceFolder=(Path="")
bAnimationReimportWarnings=False
bConfirmEditorClose=False
bSCSEditorShowFloor=False
bAlwaysBuildUAT=True
SCSViewportCameraSpeed=4
bShowSelectionSubcomponents=True
AssetViewerProfileName=
PreviewFeatureLevel=4
PreviewPlatformName=None
PreviewShaderFormatName=None
PreviewShaderPlatformName=None
bPreviewFeatureLevelActive=False
bPreviewFeatureLevelWasDefault=True
PreviewDeviceProfileName=None

[/Script/UnrealEd.EditorStyleSettings]
ApplicationScale=1.000000
bColorVisionDeficiencyCorrection=False
bColorVisionDeficiencyCorrectionPreviewWithDeficiency=False
SelectionColor=(R=0.828000,G=0.364000,B=0.003000,A=1.000000)
AdditionalSelectionColors[0]=(R=0.019382,G=0.496933,B=1.000000,A=1.000000)
AdditionalSelectionColors[1]=(R=0.356400,G=0.040915,B=0.520996,A=1.000000)
AdditionalSelectionColors[2]=(R=1.000000,G=0.168269,B=0.332452,A=1.000000)
AdditionalSelectionColors[3]=(R=1.000000,G=0.051269,B=0.051269,A=1.000000)
AdditionalSelectionColors[4]=(R=1.000000,G=0.715693,B=0.010330,A=1.000000)
AdditionalSelectionColors[5]=(R=0.258183,G=0.539479,B=0.068478,A=1.000000)
ViewportToolOverlayColor=(R=1.000000,G=1.000000,B=1.000000,A=1.000000)
bEnableEditorWindowBackgroundColor=False
EditorWindowBackgroundColor=(R=1.000000,G=1.000000,B=1.000000,A=1.000000)
MenuSearchFieldVisibilityThreshold=10
bUseGrid=True
RegularColor=(R=0.024000,G=0.024000,B=0.024000,A=1.000000)
RuleColor=(R=0.010000,G=0.010000,B=0.010000,A=1.000000)
CenterColor=(R=0.005000,G=0.005000,B=0.005000,A=1.000000)
GridSnapSize=16
GraphBackgroundBrush=(TintColor=(SpecifiedColor=(R=1.000000,G=1.000000,B=1.000000,A=1.000000),ColorUseRule=UseColor_Specified),DrawAs=Image,Tiling=NoTile,Mirroring=NoMirror,ImageType=NoImage,ImageSize=(X=32.000000,Y=32.000000),Margin=(Left=0.000000,Top=0.000000,Right=0.000000,Bottom=0.000000),ResourceObject=None,OutlineSettings=(CornerRadii=(X=0.000000,Y=0.000000,Z=0.000000,W=0.000000),Color=(SpecifiedColor=(R=0.000000,G=0.000000,B=0.000000,A=0.000000),ColorUseRule=UseColor_Specified),Width=0.000000,RoundingType=HalfHeightRadius,bUseBrushTransparency=False),UVRegion=(Min=(X=0.000000,Y=0.000000),Max=(X=0.000000,Y=0.000000),bIsValid=False),bIsDynamicallyLoaded=False,ResourceName="")
bShowNativeComponentNames=True
AssetEditorOpenLocation=Default
bEnableColorizedEditorTabs=True
CurrentAppliedTheme=134380265FBB4A9CA00A1DC9770217B8

[/Script/UnrealEd.LevelEditorPlaySettings]
LaptopScreenResolutions=(Description="Apple MacBook Air 11",Width=1366,Height=768,AspectRatio="16:9",bCanSwapAspectRatio=True,ProfileName="")
LaptopScreenResolutions=(Description="Apple MacBook Air 13\"",Width=1440,Height=900,AspectRatio="16:10",bCanSwapAspectRatio=True,ProfileName="")
LaptopScreenResolutions=(Description="Apple MacBook Pro 13\"",Width=1280,Height=800,AspectRatio="16:10",bCanSwapAspectRatio=True,ProfileName="")
LaptopScreenResolutions=(Description="Apple MacBook Pro 13\" (Retina)",Width=2560,Height=1600,AspectRatio="16:10",bCanSwapAspectRatio=True,ProfileName="")
LaptopScreenResolutions=(Description="Apple MacBook Pro 15\"",Width=1440,Height=900,AspectRatio="16:10",bCanSwapAspectRatio=True,ProfileName="")
LaptopScreenResolutions=(Description="Apple MacBook Pro 15\" (Retina)",Width=2880,Height=1800,AspectRatio="16:10",bCanSwapAspectRatio=True,ProfileName="")
LaptopScreenResolutions=(Description="Generic 14-15.6\" Notebook",Width=1366,Height=768,AspectRatio="16:9",bCanSwapAspectRatio=True,ProfileName="")
MonitorScreenResolutions=(Description="19\" monitor",Width=1440,Height=900,AspectRatio="16:10",bCanSwapAspectRatio=True,ProfileName="")
MonitorScreenResolutions=(Description="20\" monitor",Width=1600,Height=900,AspectRatio="16:9",bCanSwapAspectRatio=True,ProfileName="")
MonitorScreenResolutions=(Description="22\" monitor",Width=1680,Height=1050,AspectRatio="16:10",bCanSwapAspectRatio=True,ProfileName="")
MonitorScreenResolutions=(Description="21.5-24\" monitor",Width=1920,Height=1080,AspectRatio="16:9",bCanSwapAspectRatio=True,ProfileName="")
MonitorScreenResolutions=(Description="27\" monitor",Width=2560,Height=1440,AspectRatio="16:9",bCanSwapAspectRatio=True,ProfileName="")
TabletScreenResolutions=(Description="iPad Pro 12.9-inch (3rd gen.)",Width=1024,Height=1366,AspectRatio="~3:4",bCanSwapAspectRatio=True,ProfileName="iPadPro3_129")
TabletScreenResolutions=(Description="iPad Pro 12.9-inch (2nd gen.)",Width=1024,Height=1366,AspectRatio="~3:4",bCanSwapAspectRatio=True,ProfileName="iPadPro2_129")
TabletScreenResolutions=(Description="iPad Pro 11-inch",Width=834,Height=1194,AspectRatio="5:7",bCanSwapAspectRatio=True,ProfileName="iPadPro11")
TabletScreenResolutions=(Description="iPad Pro 10.5-inch",Width=834,Height=1112,AspectRatio="3:4",bCanSwapAspectRatio=True,ProfileName="iPadPro105")
TabletScreenResolutions=(Description="iPad Pro 12.9-inch",Width=1024,Height=1366,AspectRatio="3:4",bCanSwapAspectRatio=True,ProfileName="iPadPro129")
TabletScreenResolutions=(Description="iPad Pro 9.7-inch",Width=768,Height=1024,AspectRatio="3:4",bCanSwapAspectRatio=True,ProfileName="iPadPro97")
TabletScreenResolutions=(Description="iPad (6th gen.)",Width=768,Height=1024,AspectRatio="3:4",bCanSwapAspectRatio=True,ProfileName="iPad6")
TabletScreenResolutions=(Description="iPad (5th gen.)",Width=768,Height=1024,AspectRatio="3:4",bCanSwapAspectRatio=True,ProfileName="iPad5")
TabletScreenResolutions=(Description="iPad Air 3",Width=768,Height=1024,AspectRatio="3:4",bCanSwapAspectRatio=True,ProfileName="iPadAir3")
TabletScreenResolutions=(Description="iPad Air 2",Width=768,Height=1024,AspectRatio="3:4",bCanSwapAspectRatio=True,ProfileName="iPadAir2")
TabletScreenResolutions=(Description="iPad Mini 5",Width=768,Height=1024,AspectRatio="3:4",bCanSwapAspectRatio=True,ProfileName="iPadMini5")
TabletScreenResolutions=(Description="iPad Mini 4",Width=768,Height=1024,AspectRatio="3:4",bCanSwapAspectRatio=True,ProfileName="iPadMini4")
TabletScreenResolutions=(Description="LG G Pad X 8.0",Width=768,Height=1366,AspectRatio="9:16",bCanSwapAspectRatio=True,ProfileName="")
TabletScreenResolutions=(Description="Asus Zenpad 3s 10",Width=768,Height=1366,AspectRatio="9:16",bCanSwapAspectRatio=True,ProfileName="")
TabletScreenResolutions=(Description="Huawei MediaPad M3",Width=768,Height=1366,AspectRatio="9:16",bCanSwapAspectRatio=True,ProfileName="")
TabletScreenResolutions=(Description="Microsoft Surface RT",Width=768,Height=1366,AspectRatio="9:16",bCanSwapAspectRatio=True,ProfileName="")
TabletScreenResolutions=(Description="Microsoft Surface Pro",Width=1080,Height=1920,AspectRatio="9:16",bCanSwapAspectRatio=True,ProfileName="")
TelevisionScreenResolutions=(Description="720p (HDTV, Blu-ray)",Width=1280,Height=720,AspectRatio="16:9",bCanSwapAspectRatio=True,ProfileName="")
TelevisionScreenResolutions=(Description="1080i, 1080p (HDTV, Blu-ray)",Width=1920,Height=1080,AspectRatio="16:9",bCanSwapAspectRatio=True,ProfileName="")
TelevisionScreenResolutions=(Description="4K Ultra HD",Width=3840,Height=2160,AspectRatio="16:9",bCanSwapAspectRatio=True,ProfileName="")
TelevisionScreenResolutions=(Description="4K Digital Cinema",Width=4096,Height=2160,AspectRatio="1.90:1",bCanSwapAspectRatio=True,ProfileName="")
GameGetsMouseControl=False
UseMouseForTouch=False
MouseControlLabelPosition=LabelAnchorMode_TopLeft
ViewportGetsHMDControl=False
bShouldMinimizeEditorOnNonVRPIE=False
bEmulateStereo=False
SoloAudioInFirstPIEClient=False
EnablePIEEnterAndExitSounds=False
PlayInEditorSoundQualityLevel=0
bUseNonRealtimeAudioDevice=False
bPreferToStreamLevelsInPIE=False
bPromoteOutputLogWarningsDuringPIE=False
NewWindowPosition=(X=-1,Y=-1)
PIEAlwaysOnTop=False
DisableStandaloneSound=False
AdditionalLaunchParameters=
BuildGameBeforeLaunch=PlayOnBuild_Default
LaunchConfiguration=LaunchConfig_Default
PackFilesForLaunch=NoPak
bAutoCompileBlueprintsOnLaunch=True
bLaunchSeparateServer=False
PlayNetMode=PIE_Standalone
RunUnderOneProcess=True
PlayNumberOfClients=1
PrimaryPIEClientIndex=0
ServerPort=17777
ClientWindowWidth=640
RouteGamepadToSecondWindow=False
CreateAudioDeviceForEveryPlayer=False
ClientWindowHeight=480
ServerMapNameOverride=
AdditionalServerGameOptions=
bShowServerDebugDrawingByDefault=True
ServerDebugDrawingColorTintStrength=0.000000
ServerDebugDrawingColorTint=(R=0.000000,G=0.000000,B=0.000000,A=1.000000)
bHMDForPrimaryProcessOnly=True
AdditionalServerLaunchParameters=
ServerFixedFPS=0
NetworkEmulationSettings=(bIsNetworkEmulationEnabled=False,EmulationTarget=Server,CurrentProfile="Custom",OutPackets=(MinLatency=0,MaxLatency=0,PacketLossPercentage=0),InPackets=(MinLatency=0,MaxLatency=0,PacketLossPercentage=0))
LastSize=(X=0,Y=0)
LastExecutedLaunchDevice=Windows@YOUNES-BAZI
LastExecutedLaunchName=YOUNES-BAZI
LastExecutedPIEPreviewDevice=
DeviceToEmulate=
PIESafeZoneOverride=(Left=0.000000,Top=0.000000,Right=0.000000,Bottom=0.000000)

[/Script/UnrealEd.LevelEditorViewportSettings]
FlightCameraControlExperimentalNavigation=False
MinimumOrthographicZoom=250.000000
bAllowArcballRotate=False
bAllowScreenRotate=False
bShowActorEditorContext=True
bAllowEditWidgetAxisDisplay=True
bUseLegacyCameraMovementNotifications=False
SnapToSurface=(bEnabled=False,SnapOffsetExtent=0.000000,bSnapRotation=True)
bEnableLayerSnap=False
ActiveSnapLayerIndex=0
PreserveNonUniformScale=True
PreviewMeshes=/Engine/EditorMeshes/ColorCalibrator/SM_ColorCalibrator.SM_ColorCalibrator
BillboardScale=1.000000
TransformWidgetSizeAdjustment=0
bSaveEngineStats=False
MeasuringToolUnits=MeasureUnits_Centimeters
SelectedSplinePointSizeAdjustment=0.000000
SplineLineThicknessAdjustment=0.000000
SplineTangentHandleSizeAdjustment=0.000000
SplineTangentScale=0.500000
LastInViewportMenuLocation=(X=0.000000,Y=0.000000)
MaterialForDroppedTextures=None
MaterialParamsForDroppedTextures=()
EditorViews=(("/Game/Simulation.Simulation", (LevelViewportsInfo=((CamPosition=(X=542.473882,Y=1.910855,Z=318.369810)),(CamPosition=(X=542.473882,Y=1.910855,Z=318.369810)),(CamPosition=(X=542.473882,Y=1.910855,Z=318.369810)),(CamPosition=(X=-51687.918258,Y=9853.160882,Z=-3849.697896),CamRotation=(Pitch=-31.799900,Yaw=1027.591278,Roll=0.000000)),(CamUpdated=True),(CamUpdated=True),(CamUpdated=True),(CamPosition=(X=542.473882,Y=1.910855,Z=318.369810),CamUpdated=True)))))
PropertyColorationColorForMatchingObjects=(B=0,G=0,R=255,A=255)
PerInstanceSettings=(ConfigName="FourPanes2x2.Viewport 1.Viewport0",ConfigSettings=(ViewportType=LVT_OrthoYZ,PerspViewModeIndex=VMI_Lit,OrthoViewModeIndex=VMI_BrushWireframe,EditorShowFlagsString="PostProcessing=0,Bloom=1,LocalExposure=1,Tonemapper=1,AntiAliasing=1,TemporalAA=1,AmbientCubemap=1,EyeAdaptation=1,VisualizeHDR=0,VisualizeSkyLightIlluminance=0,VisualizeLocalExposure=0,LensFlares=1,LensDistortion=1,GlobalIllumination=1,Vignette=1,Grain=1,AmbientOcclusion=1,Decals=1,CameraImperfections=1,OnScreenDebug=1,OverrideDiffuseAndSpecular=0,LightingOnlyOverride=0,ReflectionOverride=0,VisualizeBuffer=0,VisualizeNanite=0,VisualizeLumen=0,VisualizeSubstrate=0,VisualizeGroom=0,VisualizeVirtualShadowMap=0,DirectLighting=1,DirectionalLights=1,PointLights=1,SpotLights=1,RectLights=1,ColorGrading=1,VectorFields=0,DepthOfField=1,GBufferHints=0,MotionBlur=0,CompositeEditorPrimitives=1,OpaqueCompositeEditorPrimitives=0,TestImage=0,VisualizeDOF=0,VertexColors=0,PhysicalMaterialMasks=0,Refraction=1,CameraInterpolation=1,SceneColorFringe=1,ToneCurve=1,SeparateTranslucency=1,ScreenPercentage=0,VisualizeMotionBlur=0,VisualizeMotionVectors=0,VisualizeReprojection=0,VisualizeTemporalUpscaler=0,VisualizeTSR=0,MegaLights=1,ReflectionEnvironment=1,VisualizeOutOfBoundsPixels=0,Diffuse=1,Specular=1,SelectionOutline=1,ScreenSpaceReflections=1,LumenReflections=1,ContactShadows=1,RayTracedDistanceFieldShadows=1,CapsuleShadows=1,SubsurfaceScattering=1,VisualizeSSS=0,VolumetricLightmap=1,IndirectLightingCache=1,DebugAI=0,VisLog=1,Navigation=0,GameplayDebug=1,TexturedLightProfiles=1,LightFunctions=1,InstancedStaticMeshes=1,InstancedFoliage=1,HISMCOcclusionBounds=0,HISMCClusterTree=0,VisualizeInstanceUpdates=0,InstancedGrass=1,DynamicShadows=1,Particles=1,Niagara=1,HeterogeneousVolumes=1,SkeletalMeshes=1,BuilderBrush=1,Translucency=1,BillboardSprites=1,LOD=1,LightComplexity=0,ShaderComplexity=0,StationaryLightOverlap=0,LightMapDensity=0,StreamingBounds=0,Constraints=0,MassProperties=0,CameraFrustums=0,AudioRadius=1,ForceFeedbackRadius=1,BSPSplit=0,Brushes=1,Lighting=1,DeferredLighting=1,Editor=1,BSPTriangles=0,LargeVertices=0,Grid=1,Snap=0,MeshEdges=0,Cover=0,Splines=1,Selection=1,VisualizeLevelInstanceEditing=1,ModeWidgets=1,Bounds=0,HitProxies=0,LightInfluences=0,Pivot=1,ShadowFrustums=0,Wireframe=1,Materials=1,StaticMeshes=1,Landscape=1,LightRadius=1,Fog=1,Volumes=1,Game=0,BSP=1,Collision=0,CollisionVisibility=0,CollisionPawn=0,LightShafts=1,PostProcessMaterial=1,Atmosphere=1,Cloud=1,CameraAspectRatioBars=0,CameraSafeFrames=0,TextRender=1,Rendering=1,HMDDistortion=0,StereoRendering=0,DistanceCulledPrimitives=1,VisualizeLightCulling=0,PrecomputedVisibility=1,SkyLighting=1,PreviewShadowsIndicator=1,PrecomputedVisibilityCells=0,VisualizeVolumetricLightmap=0,VolumeLightingSamples=0,Paper2DSprites=1,VisualizeDistanceFieldAO=0,VisualizeMeshDistanceFields=0,PhysicsField=0,VisualizeGlobalDistanceField=0,VisualizeLightingOnProbes=0,ScreenSpaceAO=1,DistanceFieldAO=1,LumenGlobalIllumination=1,VolumetricFog=1,VisualizeSSR=0,VisualizeShadingModels=0,VisualizeSenses=1,LODColoration=0,HLODColoration=0,QuadOverdraw=0,ShaderComplexityWithQuadOverdraw=0,PrimitiveDistanceAccuracy=0,MeshUVDensityAccuracy=0,MaterialTextureScaleAccuracy=0,OutputMaterialTextureScales=0,RequiredTextureResolution=0,VirtualTexturePendingMips=0,WidgetComponents=1,Bones=0,ServerDrawDebug=0,MediaPlanes=1,VREditing=0,OcclusionMeshes=0,VisualizeInstanceOcclusionQueries=0,DisableOcclusionQueries=0,PathTracing=0,RayTracingDebug=0,VisualizeSkyAtmosphere=0,VisualizeLightFunctionAtlas=0,VisualizeCalibrationColor=0,VisualizeCalibrationGrayscale=0,VisualizeCalibrationCustom=0,VisualizePostProcessStack=0,VirtualTexturePrimitives=0,VisualizeVolumetricCloudConservativeDensity=0,VisualizeVolumetricCloudEmptySpaceSkipping=0,VirtualShadowMapPersistentData=1,DebugDrawDistantVirtualSMLights=0,VirtualTextureResidency=1,InputDebugVisualizer=1,LumenScreenTraces=1,LumenDetailTraces=1,LumenGlobalTraces=1,LumenFarFieldTraces=1,LumenSecondaryBounces=1,LumenShortRangeAmbientOcclusion=1,NaniteMeshes=1,NaniteStreamingGeometry=1,VisualizeGPUSkinCache=0,VisualizeLWCComplexity=0,ShaderPrint=1,SceneCaptureCopySceneDepth=1,Cameras=1,Hair=1",GameShowFlagsString="PostProcessing=0,Bloom=1,LocalExposure=1,Tonemapper=1,AntiAliasing=1,TemporalAA=1,AmbientCubemap=1,EyeAdaptation=1,VisualizeHDR=0,VisualizeSkyLightIlluminance=0,VisualizeLocalExposure=0,LensFlares=1,LensDistortion=1,GlobalIllumination=1,Vignette=1,Grain=1,AmbientOcclusion=1,Decals=1,CameraImperfections=1,OnScreenDebug=1,OverrideDiffuseAndSpecular=0,LightingOnlyOverride=0,ReflectionOverride=0,VisualizeBuffer=0,VisualizeNanite=0,VisualizeLumen=0,VisualizeSubstrate=0,VisualizeGroom=0,VisualizeVirtualShadowMap=0,DirectLighting=1,DirectionalLights=1,PointLights=1,SpotLights=1,RectLights=1,ColorGrading=1,VectorFields=0,DepthOfField=1,GBufferHints=0,MotionBlur=1,CompositeEditorPrimitives=0,OpaqueCompositeEditorPrimitives=0,TestImage=0,VisualizeDOF=0,VertexColors=0,PhysicalMaterialMasks=0,Refraction=1,CameraInterpolation=1,SceneColorFringe=1,ToneCurve=1,SeparateTranslucency=1,ScreenPercentage=1,VisualizeMotionBlur=0,VisualizeMotionVectors=0,VisualizeReprojection=0,VisualizeTemporalUpscaler=0,VisualizeTSR=0,MegaLights=1,ReflectionEnvironment=1,VisualizeOutOfBoundsPixels=0,Diffuse=1,Specular=1,SelectionOutline=0,ScreenSpaceReflections=1,LumenReflections=1,ContactShadows=1,RayTracedDistanceFieldShadows=1,CapsuleShadows=1,SubsurfaceScattering=1,VisualizeSSS=0,VolumetricLightmap=1,IndirectLightingCache=1,DebugAI=0,VisLog=1,Navigation=0,GameplayDebug=1,TexturedLightProfiles=1,LightFunctions=1,InstancedStaticMeshes=1,InstancedFoliage=1,HISMCOcclusionBounds=0,HISMCClusterTree=0,VisualizeInstanceUpdates=0,InstancedGrass=1,DynamicShadows=1,Particles=1,Niagara=1,HeterogeneousVolumes=1,SkeletalMeshes=1,BuilderBrush=1,Translucency=1,BillboardSprites=1,LOD=1,LightComplexity=0,ShaderComplexity=0,StationaryLightOverlap=0,LightMapDensity=0,StreamingBounds=0,Constraints=0,MassProperties=0,CameraFrustums=0,AudioRadius=0,ForceFeedbackRadius=1,BSPSplit=0,Brushes=1,Lighting=1,DeferredLighting=1,Editor=0,BSPTriangles=0,LargeVertices=0,Grid=0,Snap=0,MeshEdges=0,Cover=0,Splines=0,Selection=0,VisualizeLevelInstanceEditing=1,ModeWidgets=0,Bounds=0,HitProxies=0,LightInfluences=0,Pivot=0,ShadowFrustums=0,Wireframe=1,Materials=1,StaticMeshes=1,Landscape=1,LightRadius=0,Fog=1,Volumes=0,Game=1,BSP=1,Collision=0,CollisionVisibility=0,CollisionPawn=0,LightShafts=1,PostProcessMaterial=1,Atmosphere=1,Cloud=1,CameraAspectRatioBars=0,CameraSafeFrames=0,TextRender=1,Rendering=1,HMDDistortion=0,StereoRendering=0,DistanceCulledPrimitives=0,VisualizeLightCulling=0,PrecomputedVisibility=1,SkyLighting=1,PreviewShadowsIndicator=1,PrecomputedVisibilityCells=0,VisualizeVolumetricLightmap=0,VolumeLightingSamples=0,Paper2DSprites=1,VisualizeDistanceFieldAO=0,VisualizeMeshDistanceFields=0,PhysicsField=0,VisualizeGlobalDistanceField=0,VisualizeLightingOnProbes=0,ScreenSpaceAO=1,DistanceFieldAO=1,LumenGlobalIllumination=1,VolumetricFog=1,VisualizeSSR=0,VisualizeShadingModels=0,VisualizeSenses=1,LODColoration=0,HLODColoration=0,QuadOverdraw=0,ShaderComplexityWithQuadOverdraw=0,PrimitiveDistanceAccuracy=0,MeshUVDensityAccuracy=0,MaterialTextureScaleAccuracy=0,OutputMaterialTextureScales=0,RequiredTextureResolution=0,VirtualTexturePendingMips=0,WidgetComponents=1,Bones=0,ServerDrawDebug=0,MediaPlanes=1,VREditing=0,OcclusionMeshes=0,VisualizeInstanceOcclusionQueries=0,DisableOcclusionQueries=0,PathTracing=0,RayTracingDebug=0,VisualizeSkyAtmosphere=0,VisualizeLightFunctionAtlas=0,VisualizeCalibrationColor=0,VisualizeCalibrationGrayscale=0,VisualizeCalibrationCustom=0,VisualizePostProcessStack=0,VirtualTexturePrimitives=0,VisualizeVolumetricCloudConservativeDensity=0,VisualizeVolumetricCloudEmptySpaceSkipping=0,VirtualShadowMapPersistentData=1,DebugDrawDistantVirtualSMLights=0,VirtualTextureResidency=1,InputDebugVisualizer=1,LumenScreenTraces=1,LumenDetailTraces=1,LumenGlobalTraces=1,LumenFarFieldTraces=1,LumenSecondaryBounces=1,LumenShortRangeAmbientOcclusion=1,NaniteMeshes=1,NaniteStreamingGeometry=1,VisualizeGPUSkinCache=0,VisualizeLWCComplexity=0,ShaderPrint=1,SceneCaptureCopySceneDepth=1,Cameras=1,Hair=1",BufferVisualizationMode="",NaniteVisualizationMode="",LumenVisualizationMode="",SubstrateVisualizationMode="",GroomVisualizationMode="",VirtualShadowMapVisualizationMode="",RayTracingDebugVisualizationMode="",GPUSkinCacheVisualizationMode="",ExposureSettings=(FixedEV100=1.000000,bFixed=False),FOVAngle=90.000000,FarViewPlane=0.000000,bIsRealtime=False,bShowOnScreenStats=True,EnabledStats=,bShowFullToolbar=True,bAllowCinematicControl=True))
PerInstanceSettings=(ConfigName="FourPanes2x2.Viewport 1.Viewport1",ConfigSettings=(ViewportType=LVT_Perspective,PerspViewModeIndex=VMI_Lit,OrthoViewModeIndex=VMI_BrushWireframe,EditorShowFlagsString="PostProcessing=1,Bloom=1,LocalExposure=1,Tonemapper=1,AntiAliasing=1,TemporalAA=1,AmbientCubemap=1,EyeAdaptation=1,VisualizeHDR=0,VisualizeSkyLightIlluminance=0,VisualizeLocalExposure=0,LensFlares=1,LensDistortion=1,GlobalIllumination=1,Vignette=1,Grain=1,AmbientOcclusion=1,Decals=1,CameraImperfections=1,OnScreenDebug=1,OverrideDiffuseAndSpecular=0,LightingOnlyOverride=0,ReflectionOverride=0,VisualizeBuffer=0,VisualizeNanite=0,VisualizeLumen=0,VisualizeSubstrate=0,VisualizeGroom=0,VisualizeVirtualShadowMap=0,DirectLighting=1,DirectionalLights=1,PointLights=1,SpotLights=1,RectLights=1,ColorGrading=1,VectorFields=0,DepthOfField=1,GBufferHints=0,MotionBlur=0,CompositeEditorPrimitives=1,OpaqueCompositeEditorPrimitives=0,TestImage=0,VisualizeDOF=0,VertexColors=0,PhysicalMaterialMasks=0,Refraction=1,CameraInterpolation=1,SceneColorFringe=1,ToneCurve=1,SeparateTranslucency=1,ScreenPercentage=0,VisualizeMotionBlur=0,VisualizeMotionVectors=0,VisualizeReprojection=0,VisualizeTemporalUpscaler=0,VisualizeTSR=0,MegaLights=1,ReflectionEnvironment=1,VisualizeOutOfBoundsPixels=0,Diffuse=1,Specular=1,SelectionOutline=1,ScreenSpaceReflections=1,LumenReflections=1,ContactShadows=1,RayTracedDistanceFieldShadows=1,CapsuleShadows=1,SubsurfaceScattering=1,VisualizeSSS=0,VolumetricLightmap=1,IndirectLightingCache=1,DebugAI=0,VisLog=1,Navigation=0,GameplayDebug=1,TexturedLightProfiles=1,LightFunctions=1,InstancedStaticMeshes=1,InstancedFoliage=1,HISMCOcclusionBounds=0,HISMCClusterTree=0,VisualizeInstanceUpdates=0,InstancedGrass=1,DynamicShadows=1,Particles=1,Niagara=1,HeterogeneousVolumes=1,SkeletalMeshes=1,BuilderBrush=1,Translucency=1,BillboardSprites=1,LOD=1,LightComplexity=0,ShaderComplexity=0,StationaryLightOverlap=0,LightMapDensity=0,StreamingBounds=0,Constraints=0,MassProperties=0,CameraFrustums=0,AudioRadius=1,ForceFeedbackRadius=1,BSPSplit=0,Brushes=0,Lighting=1,DeferredLighting=1,Editor=1,BSPTriangles=1,LargeVertices=0,Grid=1,Snap=0,MeshEdges=0,Cover=0,Splines=1,Selection=1,VisualizeLevelInstanceEditing=1,ModeWidgets=1,Bounds=0,HitProxies=0,LightInfluences=0,Pivot=1,ShadowFrustums=0,Wireframe=0,Materials=1,StaticMeshes=1,Landscape=1,LightRadius=1,Fog=1,Volumes=1,Game=0,BSP=1,Collision=0,CollisionVisibility=0,CollisionPawn=0,LightShafts=1,PostProcessMaterial=1,Atmosphere=1,Cloud=1,CameraAspectRatioBars=0,CameraSafeFrames=0,TextRender=1,Rendering=1,HMDDistortion=0,StereoRendering=0,DistanceCulledPrimitives=1,VisualizeLightCulling=0,PrecomputedVisibility=1,SkyLighting=1,PreviewShadowsIndicator=1,PrecomputedVisibilityCells=0,VisualizeVolumetricLightmap=0,VolumeLightingSamples=0,Paper2DSprites=1,VisualizeDistanceFieldAO=0,VisualizeMeshDistanceFields=0,PhysicsField=0,VisualizeGlobalDistanceField=0,VisualizeLightingOnProbes=0,ScreenSpaceAO=1,DistanceFieldAO=1,LumenGlobalIllumination=1,VolumetricFog=1,VisualizeSSR=0,VisualizeShadingModels=0,VisualizeSenses=1,LODColoration=0,HLODColoration=0,QuadOverdraw=0,ShaderComplexityWithQuadOverdraw=0,PrimitiveDistanceAccuracy=0,MeshUVDensityAccuracy=0,MaterialTextureScaleAccuracy=0,OutputMaterialTextureScales=0,RequiredTextureResolution=0,VirtualTexturePendingMips=0,WidgetComponents=1,Bones=0,ServerDrawDebug=0,MediaPlanes=1,VREditing=0,OcclusionMeshes=0,VisualizeInstanceOcclusionQueries=0,DisableOcclusionQueries=0,PathTracing=0,RayTracingDebug=0,VisualizeSkyAtmosphere=0,VisualizeLightFunctionAtlas=0,VisualizeCalibrationColor=0,VisualizeCalibrationGrayscale=0,VisualizeCalibrationCustom=0,VisualizePostProcessStack=0,VirtualTexturePrimitives=0,VisualizeVolumetricCloudConservativeDensity=0,VisualizeVolumetricCloudEmptySpaceSkipping=0,VirtualShadowMapPersistentData=1,DebugDrawDistantVirtualSMLights=0,VirtualTextureResidency=1,InputDebugVisualizer=1,LumenScreenTraces=1,LumenDetailTraces=1,LumenGlobalTraces=1,LumenFarFieldTraces=1,LumenSecondaryBounces=1,LumenShortRangeAmbientOcclusion=1,NaniteMeshes=1,NaniteStreamingGeometry=1,VisualizeGPUSkinCache=0,VisualizeLWCComplexity=0,ShaderPrint=1,SceneCaptureCopySceneDepth=1,Cameras=1,Hair=1",GameShowFlagsString="PostProcessing=1,Bloom=1,LocalExposure=1,Tonemapper=1,AntiAliasing=1,TemporalAA=1,AmbientCubemap=1,EyeAdaptation=1,VisualizeHDR=0,VisualizeSkyLightIlluminance=0,VisualizeLocalExposure=0,LensFlares=1,LensDistortion=1,GlobalIllumination=1,Vignette=1,Grain=1,AmbientOcclusion=1,Decals=1,CameraImperfections=1,OnScreenDebug=1,OverrideDiffuseAndSpecular=0,LightingOnlyOverride=0,ReflectionOverride=0,VisualizeBuffer=0,VisualizeNanite=0,VisualizeLumen=0,VisualizeSubstrate=0,VisualizeGroom=0,VisualizeVirtualShadowMap=0,DirectLighting=1,DirectionalLights=1,PointLights=1,SpotLights=1,RectLights=1,ColorGrading=1,VectorFields=0,DepthOfField=1,GBufferHints=0,MotionBlur=1,CompositeEditorPrimitives=0,OpaqueCompositeEditorPrimitives=0,TestImage=0,VisualizeDOF=0,VertexColors=0,PhysicalMaterialMasks=0,Refraction=1,CameraInterpolation=1,SceneColorFringe=1,ToneCurve=1,SeparateTranslucency=1,ScreenPercentage=1,VisualizeMotionBlur=0,VisualizeMotionVectors=0,VisualizeReprojection=0,VisualizeTemporalUpscaler=0,VisualizeTSR=0,MegaLights=1,ReflectionEnvironment=1,VisualizeOutOfBoundsPixels=0,Diffuse=1,Specular=1,SelectionOutline=0,ScreenSpaceReflections=1,LumenReflections=1,ContactShadows=1,RayTracedDistanceFieldShadows=1,CapsuleShadows=1,SubsurfaceScattering=1,VisualizeSSS=0,VolumetricLightmap=1,IndirectLightingCache=1,DebugAI=0,VisLog=1,Navigation=0,GameplayDebug=1,TexturedLightProfiles=1,LightFunctions=1,InstancedStaticMeshes=1,InstancedFoliage=1,HISMCOcclusionBounds=0,HISMCClusterTree=0,VisualizeInstanceUpdates=0,InstancedGrass=1,DynamicShadows=1,Particles=1,Niagara=1,HeterogeneousVolumes=1,SkeletalMeshes=1,BuilderBrush=1,Translucency=1,BillboardSprites=1,LOD=1,LightComplexity=0,ShaderComplexity=0,StationaryLightOverlap=0,LightMapDensity=0,StreamingBounds=0,Constraints=0,MassProperties=0,CameraFrustums=0,AudioRadius=0,ForceFeedbackRadius=1,BSPSplit=0,Brushes=0,Lighting=1,DeferredLighting=1,Editor=0,BSPTriangles=1,LargeVertices=0,Grid=0,Snap=0,MeshEdges=0,Cover=0,Splines=0,Selection=0,VisualizeLevelInstanceEditing=1,ModeWidgets=0,Bounds=0,HitProxies=0,LightInfluences=0,Pivot=0,ShadowFrustums=0,Wireframe=0,Materials=1,StaticMeshes=1,Landscape=1,LightRadius=0,Fog=1,Volumes=0,Game=1,BSP=1,Collision=0,CollisionVisibility=0,CollisionPawn=0,LightShafts=1,PostProcessMaterial=1,Atmosphere=1,Cloud=1,CameraAspectRatioBars=0,CameraSafeFrames=0,TextRender=1,Rendering=1,HMDDistortion=0,StereoRendering=0,DistanceCulledPrimitives=0,VisualizeLightCulling=0,PrecomputedVisibility=1,SkyLighting=1,PreviewShadowsIndicator=1,PrecomputedVisibilityCells=0,VisualizeVolumetricLightmap=0,VolumeLightingSamples=0,Paper2DSprites=1,VisualizeDistanceFieldAO=0,VisualizeMeshDistanceFields=0,PhysicsField=0,VisualizeGlobalDistanceField=0,VisualizeLightingOnProbes=0,ScreenSpaceAO=1,DistanceFieldAO=1,LumenGlobalIllumination=1,VolumetricFog=1,VisualizeSSR=0,VisualizeShadingModels=0,VisualizeSenses=1,LODColoration=0,HLODColoration=0,QuadOverdraw=0,ShaderComplexityWithQuadOverdraw=0,PrimitiveDistanceAccuracy=0,MeshUVDensityAccuracy=0,MaterialTextureScaleAccuracy=0,OutputMaterialTextureScales=0,RequiredTextureResolution=0,VirtualTexturePendingMips=0,WidgetComponents=1,Bones=0,ServerDrawDebug=0,MediaPlanes=1,VREditing=0,OcclusionMeshes=0,VisualizeInstanceOcclusionQueries=0,DisableOcclusionQueries=0,PathTracing=0,RayTracingDebug=0,VisualizeSkyAtmosphere=0,VisualizeLightFunctionAtlas=0,VisualizeCalibrationColor=0,VisualizeCalibrationGrayscale=0,VisualizeCalibrationCustom=0,VisualizePostProcessStack=0,VirtualTexturePrimitives=0,VisualizeVolumetricCloudConservativeDensity=0,VisualizeVolumetricCloudEmptySpaceSkipping=0,VirtualShadowMapPersistentData=1,DebugDrawDistantVirtualSMLights=0,VirtualTextureResidency=1,InputDebugVisualizer=1,LumenScreenTraces=1,LumenDetailTraces=1,LumenGlobalTraces=1,LumenFarFieldTraces=1,LumenSecondaryBounces=1,LumenShortRangeAmbientOcclusion=1,NaniteMeshes=1,NaniteStreamingGeometry=1,VisualizeGPUSkinCache=0,VisualizeLWCComplexity=0,ShaderPrint=1,SceneCaptureCopySceneDepth=1,Cameras=1,Hair=1",BufferVisualizationMode="",NaniteVisualizationMode="",LumenVisualizationMode="",SubstrateVisualizationMode="",GroomVisualizationMode="",VirtualShadowMapVisualizationMode="",RayTracingDebugVisualizationMode="",GPUSkinCacheVisualizationMode="",ExposureSettings=(FixedEV100=1.000000,bFixed=False),FOVAngle=90.000000,FarViewPlane=0.000000,bIsRealtime=True,bShowOnScreenStats=False,EnabledStats=,bShowFullToolbar=True,bAllowCinematicControl=True))
PerInstanceSettings=(ConfigName="FourPanes2x2.Viewport 1.Viewport2",ConfigSettings=(ViewportType=LVT_OrthoXZ,PerspViewModeIndex=VMI_Lit,OrthoViewModeIndex=VMI_BrushWireframe,EditorShowFlagsString="PostProcessing=0,Bloom=1,LocalExposure=1,Tonemapper=1,AntiAliasing=1,TemporalAA=1,AmbientCubemap=1,EyeAdaptation=1,VisualizeHDR=0,VisualizeSkyLightIlluminance=0,VisualizeLocalExposure=0,LensFlares=1,LensDistortion=1,GlobalIllumination=1,Vignette=1,Grain=1,AmbientOcclusion=1,Decals=1,CameraImperfections=1,OnScreenDebug=1,OverrideDiffuseAndSpecular=0,LightingOnlyOverride=0,ReflectionOverride=0,VisualizeBuffer=0,VisualizeNanite=0,VisualizeLumen=0,VisualizeSubstrate=0,VisualizeGroom=0,VisualizeVirtualShadowMap=0,DirectLighting=1,DirectionalLights=1,PointLights=1,SpotLights=1,RectLights=1,ColorGrading=1,VectorFields=0,DepthOfField=1,GBufferHints=0,MotionBlur=0,CompositeEditorPrimitives=1,OpaqueCompositeEditorPrimitives=0,TestImage=0,VisualizeDOF=0,VertexColors=0,PhysicalMaterialMasks=0,Refraction=1,CameraInterpolation=1,SceneColorFringe=1,ToneCurve=1,SeparateTranslucency=1,ScreenPercentage=0,VisualizeMotionBlur=0,VisualizeMotionVectors=0,VisualizeReprojection=0,VisualizeTemporalUpscaler=0,VisualizeTSR=0,MegaLights=1,ReflectionEnvironment=1,VisualizeOutOfBoundsPixels=0,Diffuse=1,Specular=1,SelectionOutline=1,ScreenSpaceReflections=1,LumenReflections=1,ContactShadows=1,RayTracedDistanceFieldShadows=1,CapsuleShadows=1,SubsurfaceScattering=1,VisualizeSSS=0,VolumetricLightmap=1,IndirectLightingCache=1,DebugAI=0,VisLog=1,Navigation=0,GameplayDebug=1,TexturedLightProfiles=1,LightFunctions=1,InstancedStaticMeshes=1,InstancedFoliage=1,HISMCOcclusionBounds=0,HISMCClusterTree=0,VisualizeInstanceUpdates=0,InstancedGrass=1,DynamicShadows=1,Particles=1,Niagara=1,HeterogeneousVolumes=1,SkeletalMeshes=1,BuilderBrush=1,Translucency=1,BillboardSprites=1,LOD=1,LightComplexity=0,ShaderComplexity=0,StationaryLightOverlap=0,LightMapDensity=0,StreamingBounds=0,Constraints=0,MassProperties=0,CameraFrustums=0,AudioRadius=1,ForceFeedbackRadius=1,BSPSplit=0,Brushes=1,Lighting=1,DeferredLighting=1,Editor=1,BSPTriangles=0,LargeVertices=0,Grid=1,Snap=0,MeshEdges=0,Cover=0,Splines=1,Selection=1,VisualizeLevelInstanceEditing=1,ModeWidgets=1,Bounds=0,HitProxies=0,LightInfluences=0,Pivot=1,ShadowFrustums=0,Wireframe=1,Materials=1,StaticMeshes=1,Landscape=1,LightRadius=1,Fog=1,Volumes=1,Game=0,BSP=1,Collision=0,CollisionVisibility=0,CollisionPawn=0,LightShafts=1,PostProcessMaterial=1,Atmosphere=1,Cloud=1,CameraAspectRatioBars=0,CameraSafeFrames=0,TextRender=1,Rendering=1,HMDDistortion=0,StereoRendering=0,DistanceCulledPrimitives=1,VisualizeLightCulling=0,PrecomputedVisibility=1,SkyLighting=1,PreviewShadowsIndicator=1,PrecomputedVisibilityCells=0,VisualizeVolumetricLightmap=0,VolumeLightingSamples=0,Paper2DSprites=1,VisualizeDistanceFieldAO=0,VisualizeMeshDistanceFields=0,PhysicsField=0,VisualizeGlobalDistanceField=0,VisualizeLightingOnProbes=0,ScreenSpaceAO=1,DistanceFieldAO=1,LumenGlobalIllumination=1,VolumetricFog=1,VisualizeSSR=0,VisualizeShadingModels=0,VisualizeSenses=1,LODColoration=0,HLODColoration=0,QuadOverdraw=0,ShaderComplexityWithQuadOverdraw=0,PrimitiveDistanceAccuracy=0,MeshUVDensityAccuracy=0,MaterialTextureScaleAccuracy=0,OutputMaterialTextureScales=0,RequiredTextureResolution=0,VirtualTexturePendingMips=0,WidgetComponents=1,Bones=0,ServerDrawDebug=0,MediaPlanes=1,VREditing=0,OcclusionMeshes=0,VisualizeInstanceOcclusionQueries=0,DisableOcclusionQueries=0,PathTracing=0,RayTracingDebug=0,VisualizeSkyAtmosphere=0,VisualizeLightFunctionAtlas=0,VisualizeCalibrationColor=0,VisualizeCalibrationGrayscale=0,VisualizeCalibrationCustom=0,VisualizePostProcessStack=0,VirtualTexturePrimitives=0,VisualizeVolumetricCloudConservativeDensity=0,VisualizeVolumetricCloudEmptySpaceSkipping=0,VirtualShadowMapPersistentData=1,DebugDrawDistantVirtualSMLights=0,VirtualTextureResidency=1,InputDebugVisualizer=1,LumenScreenTraces=1,LumenDetailTraces=1,LumenGlobalTraces=1,LumenFarFieldTraces=1,LumenSecondaryBounces=1,LumenShortRangeAmbientOcclusion=1,NaniteMeshes=1,NaniteStreamingGeometry=1,VisualizeGPUSkinCache=0,VisualizeLWCComplexity=0,ShaderPrint=1,SceneCaptureCopySceneDepth=1,Cameras=1,Hair=1",GameShowFlagsString="PostProcessing=0,Bloom=1,LocalExposure=1,Tonemapper=1,AntiAliasing=1,TemporalAA=1,AmbientCubemap=1,EyeAdaptation=1,VisualizeHDR=0,VisualizeSkyLightIlluminance=0,VisualizeLocalExposure=0,LensFlares=1,LensDistortion=1,GlobalIllumination=1,Vignette=1,Grain=1,AmbientOcclusion=1,Decals=1,CameraImperfections=1,OnScreenDebug=1,OverrideDiffuseAndSpecular=0,LightingOnlyOverride=0,ReflectionOverride=0,VisualizeBuffer=0,VisualizeNanite=0,VisualizeLumen=0,VisualizeSubstrate=0,VisualizeGroom=0,VisualizeVirtualShadowMap=0,DirectLighting=1,DirectionalLights=1,PointLights=1,SpotLights=1,RectLights=1,ColorGrading=1,VectorFields=0,DepthOfField=1,GBufferHints=0,MotionBlur=1,CompositeEditorPrimitives=0,OpaqueCompositeEditorPrimitives=0,TestImage=0,VisualizeDOF=0,VertexColors=0,PhysicalMaterialMasks=0,Refraction=1,CameraInterpolation=1,SceneColorFringe=1,ToneCurve=1,SeparateTranslucency=1,ScreenPercentage=1,VisualizeMotionBlur=0,VisualizeMotionVectors=0,VisualizeReprojection=0,VisualizeTemporalUpscaler=0,VisualizeTSR=0,MegaLights=1,ReflectionEnvironment=1,VisualizeOutOfBoundsPixels=0,Diffuse=1,Specular=1,SelectionOutline=0,ScreenSpaceReflections=1,LumenReflections=1,ContactShadows=1,RayTracedDistanceFieldShadows=1,CapsuleShadows=1,SubsurfaceScattering=1,VisualizeSSS=0,VolumetricLightmap=1,IndirectLightingCache=1,DebugAI=0,VisLog=1,Navigation=0,GameplayDebug=1,TexturedLightProfiles=1,LightFunctions=1,InstancedStaticMeshes=1,InstancedFoliage=1,HISMCOcclusionBounds=0,HISMCClusterTree=0,VisualizeInstanceUpdates=0,InstancedGrass=1,DynamicShadows=1,Particles=1,Niagara=1,HeterogeneousVolumes=1,SkeletalMeshes=1,BuilderBrush=1,Translucency=1,BillboardSprites=1,LOD=1,LightComplexity=0,ShaderComplexity=0,StationaryLightOverlap=0,LightMapDensity=0,StreamingBounds=0,Constraints=0,MassProperties=0,CameraFrustums=0,AudioRadius=0,ForceFeedbackRadius=1,BSPSplit=0,Brushes=1,Lighting=1,DeferredLighting=1,Editor=0,BSPTriangles=0,LargeVertices=0,Grid=0,Snap=0,MeshEdges=0,Cover=0,Splines=0,Selection=0,VisualizeLevelInstanceEditing=1,ModeWidgets=0,Bounds=0,HitProxies=0,LightInfluences=0,Pivot=0,ShadowFrustums=0,Wireframe=1,Materials=1,StaticMeshes=1,Landscape=1,LightRadius=0,Fog=1,Volumes=0,Game=1,BSP=1,Collision=0,CollisionVisibility=0,CollisionPawn=0,LightShafts=1,PostProcessMaterial=1,Atmosphere=1,Cloud=1,CameraAspectRatioBars=0,CameraSafeFrames=0,TextRender=1,Rendering=1,HMDDistortion=0,StereoRendering=0,DistanceCulledPrimitives=0,VisualizeLightCulling=0,PrecomputedVisibility=1,SkyLighting=1,PreviewShadowsIndicator=1,PrecomputedVisibilityCells=0,VisualizeVolumetricLightmap=0,VolumeLightingSamples=0,Paper2DSprites=1,VisualizeDistanceFieldAO=0,VisualizeMeshDistanceFields=0,PhysicsField=0,VisualizeGlobalDistanceField=0,VisualizeLightingOnProbes=0,ScreenSpaceAO=1,DistanceFieldAO=1,LumenGlobalIllumination=1,VolumetricFog=1,VisualizeSSR=0,VisualizeShadingModels=0,VisualizeSenses=1,LODColoration=0,HLODColoration=0,QuadOverdraw=0,ShaderComplexityWithQuadOverdraw=0,PrimitiveDistanceAccuracy=0,MeshUVDensityAccuracy=0,MaterialTextureScaleAccuracy=0,OutputMaterialTextureScales=0,RequiredTextureResolution=0,VirtualTexturePendingMips=0,WidgetComponents=1,Bones=0,ServerDrawDebug=0,MediaPlanes=1,VREditing=0,OcclusionMeshes=0,VisualizeInstanceOcclusionQueries=0,DisableOcclusionQueries=0,PathTracing=0,RayTracingDebug=0,VisualizeSkyAtmosphere=0,VisualizeLightFunctionAtlas=0,VisualizeCalibrationColor=0,VisualizeCalibrationGrayscale=0,VisualizeCalibrationCustom=0,VisualizePostProcessStack=0,VirtualTexturePrimitives=0,VisualizeVolumetricCloudConservativeDensity=0,VisualizeVolumetricCloudEmptySpaceSkipping=0,VirtualShadowMapPersistentData=1,DebugDrawDistantVirtualSMLights=0,VirtualTextureResidency=1,InputDebugVisualizer=1,LumenScreenTraces=1,LumenDetailTraces=1,LumenGlobalTraces=1,LumenFarFieldTraces=1,LumenSecondaryBounces=1,LumenShortRangeAmbientOcclusion=1,NaniteMeshes=1,NaniteStreamingGeometry=1,VisualizeGPUSkinCache=0,VisualizeLWCComplexity=0,ShaderPrint=1,SceneCaptureCopySceneDepth=1,Cameras=1,Hair=1",BufferVisualizationMode="",NaniteVisualizationMode="",LumenVisualizationMode="",SubstrateVisualizationMode="",GroomVisualizationMode="",VirtualShadowMapVisualizationMode="",RayTracingDebugVisualizationMode="",GPUSkinCacheVisualizationMode="",ExposureSettings=(FixedEV100=1.000000,bFixed=False),FOVAngle=90.000000,FarViewPlane=0.000000,bIsRealtime=False,bShowOnScreenStats=True,EnabledStats=,bShowFullToolbar=True,bAllowCinematicControl=True))
PerInstanceSettings=(ConfigName="FourPanes2x2.Viewport 1.Viewport3",ConfigSettings=(ViewportType=LVT_OrthoXY,PerspViewModeIndex=VMI_Lit,OrthoViewModeIndex=VMI_BrushWireframe,EditorShowFlagsString="PostProcessing=0,Bloom=1,LocalExposure=1,Tonemapper=1,AntiAliasing=1,TemporalAA=1,AmbientCubemap=1,EyeAdaptation=1,VisualizeHDR=0,VisualizeSkyLightIlluminance=0,VisualizeLocalExposure=0,LensFlares=1,LensDistortion=1,GlobalIllumination=1,Vignette=1,Grain=1,AmbientOcclusion=1,Decals=1,CameraImperfections=1,OnScreenDebug=1,OverrideDiffuseAndSpecular=0,LightingOnlyOverride=0,ReflectionOverride=0,VisualizeBuffer=0,VisualizeNanite=0,VisualizeLumen=0,VisualizeSubstrate=0,VisualizeGroom=0,VisualizeVirtualShadowMap=0,DirectLighting=1,DirectionalLights=1,PointLights=1,SpotLights=1,RectLights=1,ColorGrading=1,VectorFields=0,DepthOfField=1,GBufferHints=0,MotionBlur=0,CompositeEditorPrimitives=1,OpaqueCompositeEditorPrimitives=0,TestImage=0,VisualizeDOF=0,VertexColors=0,PhysicalMaterialMasks=0,Refraction=1,CameraInterpolation=1,SceneColorFringe=1,ToneCurve=1,SeparateTranslucency=1,ScreenPercentage=0,VisualizeMotionBlur=0,VisualizeMotionVectors=0,VisualizeReprojection=0,VisualizeTemporalUpscaler=0,VisualizeTSR=0,MegaLights=1,ReflectionEnvironment=1,VisualizeOutOfBoundsPixels=0,Diffuse=1,Specular=1,SelectionOutline=1,ScreenSpaceReflections=1,LumenReflections=1,ContactShadows=1,RayTracedDistanceFieldShadows=1,CapsuleShadows=1,SubsurfaceScattering=1,VisualizeSSS=0,VolumetricLightmap=1,IndirectLightingCache=1,DebugAI=0,VisLog=1,Navigation=0,GameplayDebug=1,TexturedLightProfiles=1,LightFunctions=1,InstancedStaticMeshes=1,InstancedFoliage=1,HISMCOcclusionBounds=0,HISMCClusterTree=0,VisualizeInstanceUpdates=0,InstancedGrass=1,DynamicShadows=1,Particles=1,Niagara=1,HeterogeneousVolumes=1,SkeletalMeshes=1,BuilderBrush=1,Translucency=1,BillboardSprites=1,LOD=1,LightComplexity=0,ShaderComplexity=0,StationaryLightOverlap=0,LightMapDensity=0,StreamingBounds=0,Constraints=0,MassProperties=0,CameraFrustums=0,AudioRadius=1,ForceFeedbackRadius=1,BSPSplit=0,Brushes=1,Lighting=1,DeferredLighting=1,Editor=1,BSPTriangles=0,LargeVertices=0,Grid=1,Snap=0,MeshEdges=0,Cover=0,Splines=1,Selection=1,VisualizeLevelInstanceEditing=1,ModeWidgets=1,Bounds=0,HitProxies=0,LightInfluences=0,Pivot=1,ShadowFrustums=0,Wireframe=1,Materials=1,StaticMeshes=1,Landscape=1,LightRadius=1,Fog=1,Volumes=1,Game=0,BSP=1,Collision=0,CollisionVisibility=0,CollisionPawn=0,LightShafts=1,PostProcessMaterial=1,Atmosphere=1,Cloud=1,CameraAspectRatioBars=0,CameraSafeFrames=0,TextRender=1,Rendering=1,HMDDistortion=0,StereoRendering=0,DistanceCulledPrimitives=1,VisualizeLightCulling=0,PrecomputedVisibility=1,SkyLighting=1,PreviewShadowsIndicator=1,PrecomputedVisibilityCells=0,VisualizeVolumetricLightmap=0,VolumeLightingSamples=0,Paper2DSprites=1,VisualizeDistanceFieldAO=0,VisualizeMeshDistanceFields=0,PhysicsField=0,VisualizeGlobalDistanceField=0,VisualizeLightingOnProbes=0,ScreenSpaceAO=1,DistanceFieldAO=1,LumenGlobalIllumination=1,VolumetricFog=1,VisualizeSSR=0,VisualizeShadingModels=0,VisualizeSenses=1,LODColoration=0,HLODColoration=0,QuadOverdraw=0,ShaderComplexityWithQuadOverdraw=0,PrimitiveDistanceAccuracy=0,MeshUVDensityAccuracy=0,MaterialTextureScaleAccuracy=0,OutputMaterialTextureScales=0,RequiredTextureResolution=0,VirtualTexturePendingMips=0,WidgetComponents=1,Bones=0,ServerDrawDebug=0,MediaPlanes=1,VREditing=0,OcclusionMeshes=0,VisualizeInstanceOcclusionQueries=0,DisableOcclusionQueries=0,PathTracing=0,RayTracingDebug=0,VisualizeSkyAtmosphere=0,VisualizeLightFunctionAtlas=0,VisualizeCalibrationColor=0,VisualizeCalibrationGrayscale=0,VisualizeCalibrationCustom=0,VisualizePostProcessStack=0,VirtualTexturePrimitives=0,VisualizeVolumetricCloudConservativeDensity=0,VisualizeVolumetricCloudEmptySpaceSkipping=0,VirtualShadowMapPersistentData=1,DebugDrawDistantVirtualSMLights=0,VirtualTextureResidency=1,InputDebugVisualizer=1,LumenScreenTraces=1,LumenDetailTraces=1,LumenGlobalTraces=1,LumenFarFieldTraces=1,LumenSecondaryBounces=1,LumenShortRangeAmbientOcclusion=1,NaniteMeshes=1,NaniteStreamingGeometry=1,VisualizeGPUSkinCache=0,VisualizeLWCComplexity=0,ShaderPrint=1,SceneCaptureCopySceneDepth=1,Cameras=1,Hair=1",GameShowFlagsString="PostProcessing=0,Bloom=1,LocalExposure=1,Tonemapper=1,AntiAliasing=1,TemporalAA=1,AmbientCubemap=1,EyeAdaptation=1,VisualizeHDR=0,VisualizeSkyLightIlluminance=0,VisualizeLocalExposure=0,LensFlares=1,LensDistortion=1,GlobalIllumination=1,Vignette=1,Grain=1,AmbientOcclusion=1,Decals=1,CameraImperfections=1,OnScreenDebug=1,OverrideDiffuseAndSpecular=0,LightingOnlyOverride=0,ReflectionOverride=0,VisualizeBuffer=0,VisualizeNanite=0,VisualizeLumen=0,VisualizeSubstrate=0,VisualizeGroom=0,VisualizeVirtualShadowMap=0,DirectLighting=1,DirectionalLights=1,PointLights=1,SpotLights=1,RectLights=1,ColorGrading=1,VectorFields=0,DepthOfField=1,GBufferHints=0,MotionBlur=1,CompositeEditorPrimitives=0,OpaqueCompositeEditorPrimitives=0,TestImage=0,VisualizeDOF=0,VertexColors=0,PhysicalMaterialMasks=0,Refraction=1,CameraInterpolation=1,SceneColorFringe=1,ToneCurve=1,SeparateTranslucency=1,ScreenPercentage=1,VisualizeMotionBlur=0,VisualizeMotionVectors=0,VisualizeReprojection=0,VisualizeTemporalUpscaler=0,VisualizeTSR=0,MegaLights=1,ReflectionEnvironment=1,VisualizeOutOfBoundsPixels=0,Diffuse=1,Specular=1,SelectionOutline=0,ScreenSpaceReflections=1,LumenReflections=1,ContactShadows=1,RayTracedDistanceFieldShadows=1,CapsuleShadows=1,SubsurfaceScattering=1,VisualizeSSS=0,VolumetricLightmap=1,IndirectLightingCache=1,DebugAI=0,VisLog=1,Navigation=0,GameplayDebug=1,TexturedLightProfiles=1,LightFunctions=1,InstancedStaticMeshes=1,InstancedFoliage=1,HISMCOcclusionBounds=0,HISMCClusterTree=0,VisualizeInstanceUpdates=0,InstancedGrass=1,DynamicShadows=1,Particles=1,Niagara=1,HeterogeneousVolumes=1,SkeletalMeshes=1,BuilderBrush=1,Translucency=1,BillboardSprites=1,LOD=1,LightComplexity=0,ShaderComplexity=0,StationaryLightOverlap=0,LightMapDensity=0,StreamingBounds=0,Constraints=0,MassProperties=0,CameraFrustums=0,AudioRadius=0,ForceFeedbackRadius=1,BSPSplit=0,Brushes=1,Lighting=1,DeferredLighting=1,Editor=0,BSPTriangles=0,LargeVertices=0,Grid=0,Snap=0,MeshEdges=0,Cover=0,Splines=0,Selection=0,VisualizeLevelInstanceEditing=1,ModeWidgets=0,Bounds=0,HitProxies=0,LightInfluences=0,Pivot=0,ShadowFrustums=0,Wireframe=1,Materials=1,StaticMeshes=1,Landscape=1,LightRadius=0,Fog=1,Volumes=0,Game=1,BSP=1,Collision=0,CollisionVisibility=0,CollisionPawn=0,LightShafts=1,PostProcessMaterial=1,Atmosphere=1,Cloud=1,CameraAspectRatioBars=0,CameraSafeFrames=0,TextRender=1,Rendering=1,HMDDistortion=0,StereoRendering=0,DistanceCulledPrimitives=0,VisualizeLightCulling=0,PrecomputedVisibility=1,SkyLighting=1,PreviewShadowsIndicator=1,PrecomputedVisibilityCells=0,VisualizeVolumetricLightmap=0,VolumeLightingSamples=0,Paper2DSprites=1,VisualizeDistanceFieldAO=0,VisualizeMeshDistanceFields=0,PhysicsField=0,VisualizeGlobalDistanceField=0,VisualizeLightingOnProbes=0,ScreenSpaceAO=1,DistanceFieldAO=1,LumenGlobalIllumination=1,VolumetricFog=1,VisualizeSSR=0,VisualizeShadingModels=0,VisualizeSenses=1,LODColoration=0,HLODColoration=0,QuadOverdraw=0,ShaderComplexityWithQuadOverdraw=0,PrimitiveDistanceAccuracy=0,MeshUVDensityAccuracy=0,MaterialTextureScaleAccuracy=0,OutputMaterialTextureScales=0,RequiredTextureResolution=0,VirtualTexturePendingMips=0,WidgetComponents=1,Bones=0,ServerDrawDebug=0,MediaPlanes=1,VREditing=0,OcclusionMeshes=0,VisualizeInstanceOcclusionQueries=0,DisableOcclusionQueries=0,PathTracing=0,RayTracingDebug=0,VisualizeSkyAtmosphere=0,VisualizeLightFunctionAtlas=0,VisualizeCalibrationColor=0,VisualizeCalibrationGrayscale=0,VisualizeCalibrationCustom=0,VisualizePostProcessStack=0,VirtualTexturePrimitives=0,VisualizeVolumetricCloudConservativeDensity=0,VisualizeVolumetricCloudEmptySpaceSkipping=0,VirtualShadowMapPersistentData=1,DebugDrawDistantVirtualSMLights=0,VirtualTextureResidency=1,InputDebugVisualizer=1,LumenScreenTraces=1,LumenDetailTraces=1,LumenGlobalTraces=1,LumenFarFieldTraces=1,LumenSecondaryBounces=1,LumenShortRangeAmbientOcclusion=1,NaniteMeshes=1,NaniteStreamingGeometry=1,VisualizeGPUSkinCache=0,VisualizeLWCComplexity=0,ShaderPrint=1,SceneCaptureCopySceneDepth=1,Cameras=1,Hair=1",BufferVisualizationMode="",NaniteVisualizationMode="",LumenVisualizationMode="",SubstrateVisualizationMode="",GroomVisualizationMode="",VirtualShadowMapVisualizationMode="",RayTracingDebugVisualizationMode="",GPUSkinCacheVisualizationMode="",ExposureSettings=(FixedEV100=1.000000,bFixed=False),FOVAngle=90.000000,FarViewPlane=0.000000,bIsRealtime=False,bShowOnScreenStats=True,EnabledStats=,bShowFullToolbar=True,bAllowCinematicControl=True))

[MRU]
MRUItem0=/Game/Simulation

[EditorStartup]
LastLevel=/Engine/Maps/Templates/OpenWorld

[AssetEditorSubsystem]
CleanShutdown=True
DebuggerAttached=False

[ContentBrowser]
ContentBrowserDrawer.SelectedPaths=/Game/Fab/White_Drone
ContentBrowserDrawer.PluginFilters=
ContentBrowserDrawer.SourcesExpanded=True
ContentBrowserDrawer.IsLocked=False
ContentBrowserDrawer.FavoritesAreaExpanded=False
ContentBrowserDrawer.PathAreaExpanded=True
ContentBrowserDrawer.CollectionAreaExpanded=False
ContentBrowserDrawer.FavoritesSearchAreaExpanded=False
ContentBrowserDrawer.PathSearchAreaExpanded=False
ContentBrowserDrawer.CollectionSearchAreaExpanded=False
ContentBrowserDrawer.VerticalSplitter.FixedSlotSize0=150
ContentBrowserDrawer.VerticalSplitter.SlotSize1=0.75
ContentBrowserDrawer.FavoriteSplitter.SlotSize0=0.200000003
ContentBrowserDrawer.FavoriteSplitter.SlotSize1=0.800000012
ContentBrowserDrawer.FavoriteSplitter.SlotSize2=0.400000006
ContentBrowserDrawer.Favorites.SelectedPaths=
FavoritePaths=
ContentBrowserDrawer.SelectedCollections=
ContentBrowserDrawer.ExpandedCollections=
ContentBrowserDrawer.ThumbnailSize=2
ContentBrowserDrawer.CurrentViewType=1
ContentBrowserDrawer.ZoomScale=0
ContentBrowserDrawer.JumpMRU=/All/Game/Fab/White_Drone
ContentBrowserDrawer.JumpMRU=/All/Game
ContentBrowserDrawer.JumpMRU=/All/Game/MilitaryDrone
ContentBrowserDrawer.JumpMRU=/All
ContentBrowserDrawer.JumpMRU=/All/Game/VigilanteContent/Vehicles/West_Tank_M1A1Abrams
ContentBrowserDrawer.JumpMRU=/All/Game/VigilanteContent/Vehicles
ContentBrowserDrawer.JumpMRU=/All/Game/VigilanteContent
ContentBrowserDrawer.JumpMRU=/All/Game/MWLandscapeAutoMaterial/Maps
ContentBrowserDrawer.JumpMRU=/All/Game/MWLandscapeAutoMaterial
AssetDialog.ThumbnailSize=2
AssetDialog.CurrentViewType=1
AssetDialog.ZoomScale=0

[PlacementMode]
RecentlyPlaced=/Game/Fab/White_Drone/white_drone_texture_0.white_drone_texture_0;
RecentlyPlaced=/Game/Fab/White_Drone/white_drone.white_drone;
RecentlyPlaced=/Engine/Transient.ImgMediaSource_0;
RecentlyPlaced=/Game/VigilanteContent/Vehicles/West_Tank_M1A1Abrams/ABP_West_Tank_M1A1Abrams.ABP_West_Tank_M1A1Abrams;
RecentlyPlaced=/Game/MWLandscapeAutoMaterial/Maps/LandscapeAutoMaterial_Desert_Example.LandscapeAutoMaterial_Desert_Example;
RecentlyPlaced=/Game/MWLandscapeAutoMaterial/Maps/LandscapeAutoMaterial_Island_Example.LandscapeAutoMaterial_Island_Example;

[DetailCategories]
LevelInstance.LevelInstanceEdit=True
LevelInstance.TransformCommon=True
LevelInstance.Level=True
LevelInstance.Rendering=True
LevelInstance.Physics=True
LevelInstance.Tags=True
LevelInstance.Activation=True
LevelInstance.Cooking=True
LevelInstance.Replication=True
LevelInstance.Collision=True
LevelInstance.HLOD=True
LevelInstance.Networking=True
LevelInstance.Input=True
LevelInstance.Actor=True
WorldDataLayers.Networking=True
WorldPartitionMiniMap.WorldPartitionMiniMap=True

[SlateAdditionalLayoutConfig]
Viewport 1.LayoutType=FourPanes2x2
FourPanes2x2.Viewport 1.Percentages0=X=0.500 Y=0.500
FourPanes2x2.Viewport 1.Percentages1=X=0.500 Y=0.500
FourPanes2x2.Viewport 1.Percentages2=X=0.500 Y=0.500
FourPanes2x2.Viewport 1.Percentages3=X=0.500 Y=0.500
FourPanes2x2.Viewport 1.Viewport0.TypeWithinLayout=Default
FourPanes2x2.Viewport 1.Viewport1.TypeWithinLayout=Default
FourPanes2x2.Viewport 1.Viewport2.TypeWithinLayout=Default
FourPanes2x2.Viewport 1.Viewport3.TypeWithinLayout=Default
FourPanes2x2.Viewport 1.bIsMaximized=True
FourPanes2x2.Viewport 1.MaximizedViewport=FourPanes2x2.Viewport 1.Viewport1

[/Script/Fab.FabLocalAssets]
PathsListingID=(("/Game/Fab/White_Drone", "5b7e653f-07fe-4131-9d5d-8fe15b1fd0fc"))

[DetailPropertyExpansion]
StaticMeshActor="\"Object.StaticMeshActor.StaticMeshComponent.Object.Collision.BodyInstance\" "

[/Script/Engine.WorldPartitionEditorPerProjectUserSettings]
bHideEditorDataLayers=False
bHideRuntimeDataLayers=False
bHideDataLayerActors=True
bHideUnloadedActors=False
bShowOnlySelectedActors=False
bHighlightSelectedDataLayers=True
bHideLevelInstanceContent=True
bDisableLoadingOfLastLoadedRegions=False
bBugItGoLoadRegion=False
bShowCellCoords=False
MinimapUnloadedOpacity=0.660000
PerWorldEditorSettings=(("/Game/Simulation.Simulation", (LoadedEditorRegions=((Min=(X=-102480.867188,Y=-102536.195312,Z=-2097152.000000),Max=(X=102491.187500,Y=102276.851562,Z=2097152.000000),IsValid=True),(Min=(X=-102480.867188,Y=-102536.195312,Z=-2097152.000000),Max=(X=102491.187500,Y=102276.851562,Z=2097152.000000),IsValid=True)))))

[RootWindow]
ScreenPosition=X=320.000 Y=149.600
WindowSize=X=1281.600 Y=721.600
InitiallyMaximized=True

[Directories2]
UNR=../../../../../../Users/hp/Documents/Unreal Projects/simulation/Content
BRUSH=../../../../../../Users/hp/Documents/Unreal Projects/simulation/Content/
FBX=../../../../../../Users/hp/Documents/Unreal Projects/simulation/Content/
FBXAnim=../../../../../../Users/hp/Documents/Unreal Projects/simulation/Content/
GenericImport=../../../../../../Users/hp/Documents/Unreal Projects/simulation/Content/
GenericExport=../../../../../../Users/hp/Documents/Unreal Projects/simulation/Content/
GenericOpen=../../../../../../Users/hp/Documents/Unreal Projects/simulation/Content/
GenericSave=../../../../../../Users/hp/Documents/Unreal Projects/simulation/Content/
MeshImportExport=../../../../../../Users/hp/Documents/Unreal Projects/simulation/Content/
WorldRoot=../../../../../../Users/hp/Documents/Unreal Projects/simulation/Content/
Level=../../../../../../Users/hp/Documents/Unreal Projects/simulation/Content/
Project=C:/Program Files/Epic Games/UE_5.5/

[ModuleFileTracking]
StorageServerClient.TimeStamp=2025.01.26-16.39.39
StorageServerClient.LastCompileMethod=Unknown
CookOnTheFly.TimeStamp=2025.01.26-16.39.19
CookOnTheFly.LastCompileMethod=Unknown
StreamingFile.TimeStamp=2025.01.26-16.39.39
StreamingFile.LastCompileMethod=Unknown
NetworkFile.TimeStamp=2025.01.26-16.39.33
NetworkFile.LastCompileMethod=Unknown
PakFile.TimeStamp=2025.01.26-16.39.33
PakFile.LastCompileMethod=Unknown
RSA.TimeStamp=2025.01.26-16.39.36
RSA.LastCompileMethod=Unknown
SandboxFile.TimeStamp=2025.01.26-16.39.36
SandboxFile.LastCompileMethod=Unknown
CoreUObject.TimeStamp=2025.01.26-16.39.21
CoreUObject.LastCompileMethod=Unknown
Engine.TimeStamp=2025.01.26-16.39.27
Engine.LastCompileMethod=Unknown
UniversalObjectLocator.TimeStamp=2025.01.26-16.39.41
UniversalObjectLocator.LastCompileMethod=Unknown
Renderer.TimeStamp=2025.01.26-16.39.36
Renderer.LastCompileMethod=Unknown
AnimGraphRuntime.TimeStamp=2025.01.26-16.39.16
AnimGraphRuntime.LastCompileMethod=Unknown
SlateRHIRenderer.TimeStamp=2025.01.26-16.39.38
SlateRHIRenderer.LastCompileMethod=Unknown
Landscape.TimeStamp=2025.01.26-16.39.30
Landscape.LastCompileMethod=Unknown
RHICore.TimeStamp=2025.01.26-16.39.36
RHICore.LastCompileMethod=Unknown
RenderCore.TimeStamp=2025.01.26-16.39.35
RenderCore.LastCompileMethod=Unknown
TextureCompressor.TimeStamp=2025.01.26-16.39.39
TextureCompressor.LastCompileMethod=Unknown
OpenColorIOWrapper.TimeStamp=2025.01.26-16.39.33
OpenColorIOWrapper.LastCompileMethod=Unknown
Virtualization.TimeStamp=2025.01.26-16.39.43
Virtualization.LastCompileMethod=Unknown
MessageLog.TimeStamp=2025.01.26-16.39.32
MessageLog.LastCompileMethod=Unknown
AudioEditor.TimeStamp=2025.01.26-16.39.17
AudioEditor.LastCompileMethod=Unknown
PropertyEditor.TimeStamp=2025.01.26-16.39.34
PropertyEditor.LastCompileMethod=Unknown
AnimationModifiers.TimeStamp=2025.01.26-16.39.16
AnimationModifiers.LastCompileMethod=Unknown
IoStoreOnDemand.TimeStamp=2025.01.26-16.39.28
IoStoreOnDemand.LastCompileMethod=Unknown
OpusAudioDecoder.TimeStamp=2025.01.26-16.39.33
OpusAudioDecoder.LastCompileMethod=Unknown
VorbisAudioDecoder.TimeStamp=2025.01.26-16.39.43
VorbisAudioDecoder.LastCompileMethod=Unknown
AdpcmAudioDecoder.TimeStamp=2025.01.26-16.39.15
AdpcmAudioDecoder.LastCompileMethod=Unknown
BinkAudioDecoder.TimeStamp=2025.01.26-16.39.17
BinkAudioDecoder.LastCompileMethod=Unknown
RadAudioDecoder.TimeStamp=2025.01.26-16.39.34
RadAudioDecoder.LastCompileMethod=Unknown
FastBuildController.TimeStamp=2025.01.26-16.53.30
FastBuildController.LastCompileMethod=Unknown
UbaController.TimeStamp=2025.01.26-16.56.56
UbaController.LastCompileMethod=Unknown
XGEController.TimeStamp=2025.01.26-16.57.20
XGEController.LastCompileMethod=Unknown
PerforceSourceControl.TimeStamp=2025.01.26-16.47.55
PerforceSourceControl.LastCompileMethod=Unknown
SourceControl.TimeStamp=2025.01.26-16.39.38
SourceControl.LastCompileMethod=Unknown
PlasticSourceControl.TimeStamp=2025.01.26-16.47.55
PlasticSourceControl.LastCompileMethod=Unknown
PlatformCrypto.TimeStamp=2025.01.26-16.51.55
PlatformCrypto.LastCompileMethod=Unknown
PlatformCryptoTypes.TimeStamp=2025.01.26-16.51.55
PlatformCryptoTypes.LastCompileMethod=Unknown
PlatformCryptoOpenSSL.TimeStamp=2025.01.26-16.51.55
PlatformCryptoOpenSSL.LastCompileMethod=Unknown
PythonScriptPluginPreload.TimeStamp=2025.01.26-16.51.55
PythonScriptPluginPreload.LastCompileMethod=Unknown
DesktopPlatform.TimeStamp=2025.01.26-16.39.22
DesktopPlatform.LastCompileMethod=Unknown
ChaosCloth.TimeStamp=2025.01.26-16.47.47
ChaosCloth.LastCompileMethod=Unknown
PixWinPlugin.TimeStamp=2025.01.26-16.47.55
PixWinPlugin.LastCompileMethod=Unknown
RenderDocPlugin.TimeStamp=2025.01.26-16.47.55
RenderDocPlugin.LastCompileMethod=Unknown
EditorTelemetry.TimeStamp=2025.01.26-16.50.39
EditorTelemetry.LastCompileMethod=Unknown
EditorPerformance.TimeStamp=2025.01.26-16.50.39
EditorPerformance.LastCompileMethod=Unknown
NFORDenoise.TimeStamp=2025.01.26-16.51.24
NFORDenoise.LastCompileMethod=Unknown
AnalyticsLog.TimeStamp=2025.01.26-16.52.01
AnalyticsLog.LastCompileMethod=Unknown
AnalyticsHorde.TimeStamp=2025.01.26-16.52.01
AnalyticsHorde.LastCompileMethod=Unknown
StudioTelemetry.TimeStamp=2025.01.26-16.52.01
StudioTelemetry.LastCompileMethod=Unknown
Analytics.TimeStamp=2025.01.26-16.39.15
Analytics.LastCompileMethod=Unknown
TelemetryUtils.TimeStamp=2025.01.26-16.39.39
TelemetryUtils.LastCompileMethod=Unknown
EOSShared.TimeStamp=2025.01.26-16.54.17
EOSShared.LastCompileMethod=Unknown
OnlineServicesInterface.TimeStamp=2025.01.26-16.54.18
OnlineServicesInterface.LastCompileMethod=Unknown
OnlineServicesCommon.TimeStamp=2025.01.26-16.54.18
OnlineServicesCommon.LastCompileMethod=Unknown
OnlineServicesCommonEngineUtils.TimeStamp=2025.01.26-16.54.18
OnlineServicesCommonEngineUtils.LastCompileMethod=Unknown
OnlineSubsystem.TimeStamp=2025.01.26-16.54.19
OnlineSubsystem.LastCompileMethod=Unknown
HTTP.TimeStamp=2025.01.26-16.39.28
HTTP.LastCompileMethod=Unknown
SSL.TimeStamp=2025.01.26-16.39.39
SSL.LastCompileMethod=Unknown
XMPP.TimeStamp=2025.01.26-16.39.44
XMPP.LastCompileMethod=Unknown
WebSockets.TimeStamp=2025.01.26-16.39.43
WebSockets.LastCompileMethod=Unknown
OnlineSubsystemNULL.TimeStamp=2025.01.26-16.54.21
OnlineSubsystemNULL.LastCompileMethod=Unknown
Sockets.TimeStamp=2025.01.26-16.39.38
Sockets.LastCompileMethod=Unknown
OnlineSubsystemUtils.TimeStamp=2025.01.26-16.54.21
OnlineSubsystemUtils.LastCompileMethod=Unknown
OnlineBlueprintSupport.TimeStamp=2025.01.26-16.54.21
OnlineBlueprintSupport.LastCompileMethod=Unknown
LauncherChunkInstaller.TimeStamp=2025.01.26-16.54.30
LauncherChunkInstaller.LastCompileMethod=Unknown
NNEDenoiserShaders.TimeStamp=2025.01.26-16.54.12
NNEDenoiserShaders.LastCompileMethod=Unknown
ComputeFramework.TimeStamp=2025.01.26-16.54.33
ComputeFramework.LastCompileMethod=Unknown
ChunkDownloader.TimeStamp=2025.01.26-16.54.32
ChunkDownloader.LastCompileMethod=Unknown
ExampleDeviceProfileSelector.TimeStamp=2025.01.26-16.54.35
ExampleDeviceProfileSelector.LastCompileMethod=Unknown
HairStrandsCore.TimeStamp=2025.01.26-16.55.00
HairStrandsCore.LastCompileMethod=Unknown
WindowsDeviceProfileSelector.TimeStamp=2025.01.26-16.56.55
WindowsDeviceProfileSelector.LastCompileMethod=Unknown
AISupportModule.TimeStamp=2025.01.26-16.47.35
AISupportModule.LastCompileMethod=Unknown
ACLPlugin.TimeStamp=2025.01.26-16.47.35
ACLPlugin.LastCompileMethod=Unknown
OptimusSettings.TimeStamp=2025.01.26-16.47.40
OptimusSettings.LastCompileMethod=Unknown
DatasmithContent.TimeStamp=2025.01.26-16.48.24
DatasmithContent.LastCompileMethod=Unknown
GLTFExporter.TimeStamp=2025.01.26-16.48.39
GLTFExporter.LastCompileMethod=Unknown
VariantManagerContent.TimeStamp=2025.01.26-16.48.43
VariantManagerContent.LastCompileMethod=Unknown
NiagaraShader.TimeStamp=2025.01.26-16.53.32
NiagaraShader.LastCompileMethod=Unknown
NiagaraVertexFactories.TimeStamp=2025.01.26-16.53.32
NiagaraVertexFactories.LastCompileMethod=Unknown
ExrReaderGpu.TimeStamp=2025.01.26-16.53.57
ExrReaderGpu.LastCompileMethod=Unknown
WmfMedia.TimeStamp=2025.01.26-16.54.06
WmfMedia.LastCompileMethod=Unknown
Media.TimeStamp=2025.01.26-16.39.31
Media.LastCompileMethod=Unknown
HoldoutComposite.TimeStamp=2025.01.26-16.50.37
HoldoutComposite.LastCompileMethod=Unknown
D3D12RHI.TimeStamp=2025.01.26-16.39.21
D3D12RHI.LastCompileMethod=Unknown
WindowsPlatformFeatures.TimeStamp=2025.01.26-16.39.43
WindowsPlatformFeatures.LastCompileMethod=Unknown
GameplayMediaEncoder.TimeStamp=2025.01.26-16.39.27
GameplayMediaEncoder.LastCompileMethod=Unknown
AVEncoder.TimeStamp=2025.01.26-16.39.17
AVEncoder.LastCompileMethod=Unknown
Chaos.TimeStamp=2025.01.26-16.39.18
Chaos.LastCompileMethod=Unknown
GeometryCore.TimeStamp=2025.01.26-16.39.27
GeometryCore.LastCompileMethod=Unknown
ChaosSolverEngine.TimeStamp=2025.01.26-16.39.18
ChaosSolverEngine.LastCompileMethod=Unknown
ChaosVDRuntime.TimeStamp=2025.01.26-16.39.18
ChaosVDRuntime.LastCompileMethod=Unknown
DirectoryWatcher.TimeStamp=2025.01.26-16.39.23
DirectoryWatcher.LastCompileMethod=Unknown
Settings.TimeStamp=2025.01.26-16.39.37
Settings.LastCompileMethod=Unknown
InputCore.TimeStamp=2025.01.26-16.39.28
InputCore.LastCompileMethod=Unknown
TargetPlatform.TimeStamp=2025.01.26-16.39.39
TargetPlatform.LastCompileMethod=Unknown
TurnkeySupport.TimeStamp=2025.01.26-16.39.40
TurnkeySupport.LastCompileMethod=Unknown
TextureFormat.TimeStamp=2025.01.26-16.39.39
TextureFormat.LastCompileMethod=Unknown
TextureFormatASTC.TimeStamp=2025.01.26-16.39.39
TextureFormatASTC.LastCompileMethod=Unknown
TextureFormatDXT.TimeStamp=2025.01.26-16.39.39
TextureFormatDXT.LastCompileMethod=Unknown
TextureFormatETC2.TimeStamp=2025.01.26-16.39.39
TextureFormatETC2.LastCompileMethod=Unknown
TextureFormatIntelISPCTexComp.TimeStamp=2025.01.26-16.39.39
TextureFormatIntelISPCTexComp.LastCompileMethod=Unknown
TextureFormatUncompressed.TimeStamp=2025.01.26-16.39.39
TextureFormatUncompressed.LastCompileMethod=Unknown
TextureFormatOodle.TimeStamp=2025.01.26-16.47.55
TextureFormatOodle.LastCompileMethod=Unknown
ImageWrapper.TimeStamp=2025.01.26-16.39.28
ImageWrapper.LastCompileMethod=Unknown
AndroidTargetPlatform.TimeStamp=2025.01.26-16.38.39
AndroidTargetPlatform.LastCompileMethod=Unknown
AndroidTargetPlatformSettings.TimeStamp=2025.01.26-16.38.39
AndroidTargetPlatformSettings.LastCompileMethod=Unknown
AndroidTargetPlatformControls.TimeStamp=2025.01.26-16.38.39
AndroidTargetPlatformControls.LastCompileMethod=Unknown
IOSTargetPlatform.TimeStamp=2025.01.26-16.38.52
IOSTargetPlatform.LastCompileMethod=Unknown
IOSTargetPlatformSettings.TimeStamp=2025.01.26-16.38.52
IOSTargetPlatformSettings.LastCompileMethod=Unknown
IOSTargetPlatformControls.TimeStamp=2025.01.26-16.38.52
IOSTargetPlatformControls.LastCompileMethod=Unknown
LinuxTargetPlatform.TimeStamp=2025.01.26-16.38.52
LinuxTargetPlatform.LastCompileMethod=Unknown
LinuxTargetPlatformSettings.TimeStamp=2025.01.26-16.38.52
LinuxTargetPlatformSettings.LastCompileMethod=Unknown
LinuxTargetPlatformControls.TimeStamp=2025.01.26-16.38.52
LinuxTargetPlatformControls.LastCompileMethod=Unknown
LinuxArm64TargetPlatform.TimeStamp=2025.01.26-16.38.52
LinuxArm64TargetPlatform.LastCompileMethod=Unknown
LinuxArm64TargetPlatformSettings.TimeStamp=2025.01.26-16.38.52
LinuxArm64TargetPlatformSettings.LastCompileMethod=Unknown
LinuxArm64TargetPlatformControls.TimeStamp=2025.01.26-16.38.52
LinuxArm64TargetPlatformControls.LastCompileMethod=Unknown
MacTargetPlatform.TimeStamp=2025.01.26-16.39.31
MacTargetPlatform.LastCompileMethod=Unknown
MacTargetPlatformSettings.TimeStamp=2025.01.26-16.39.31
MacTargetPlatformSettings.LastCompileMethod=Unknown
MacTargetPlatformControls.TimeStamp=2025.01.26-16.39.31
MacTargetPlatformControls.LastCompileMethod=Unknown
TVOSTargetPlatform.TimeStamp=2025.01.26-16.38.52
TVOSTargetPlatform.LastCompileMethod=Unknown
TVOSTargetPlatformSettings.TimeStamp=2025.01.26-16.38.52
TVOSTargetPlatformSettings.LastCompileMethod=Unknown
TVOSTargetPlatformControls.TimeStamp=2025.01.26-16.38.52
TVOSTargetPlatformControls.LastCompileMethod=Unknown
WindowsTargetPlatform.TimeStamp=2025.01.26-16.39.43
WindowsTargetPlatform.LastCompileMethod=Unknown
WindowsTargetPlatformSettings.TimeStamp=2025.01.26-16.39.43
WindowsTargetPlatformSettings.LastCompileMethod=Unknown
WindowsTargetPlatformControls.TimeStamp=2025.01.26-16.39.43
WindowsTargetPlatformControls.LastCompileMethod=Unknown
AudioFormatOPUS.TimeStamp=2025.01.26-16.39.17
AudioFormatOPUS.LastCompileMethod=Unknown
AudioFormatOGG.TimeStamp=2025.01.26-16.39.17
AudioFormatOGG.LastCompileMethod=Unknown
AudioFormatADPCM.TimeStamp=2025.01.26-16.39.17
AudioFormatADPCM.LastCompileMethod=Unknown
AudioFormatBINK.TimeStamp=2025.01.26-16.39.17
AudioFormatBINK.LastCompileMethod=Unknown
AudioFormatRAD.TimeStamp=2025.01.26-16.39.17
AudioFormatRAD.LastCompileMethod=Unknown
ShaderFormatVectorVM.TimeStamp=2025.01.26-16.39.37
ShaderFormatVectorVM.LastCompileMethod=Unknown
ShaderFormatD3D.TimeStamp=2025.01.26-16.39.37
ShaderFormatD3D.LastCompileMethod=Unknown
ShaderFormatOpenGL.TimeStamp=2025.01.26-16.39.37
ShaderFormatOpenGL.LastCompileMethod=Unknown
VulkanShaderFormat.TimeStamp=2025.01.26-16.39.43
VulkanShaderFormat.LastCompileMethod=Unknown
MetalShaderFormat.TimeStamp=2025.01.26-16.39.32
MetalShaderFormat.LastCompileMethod=Unknown
DerivedDataCache.TimeStamp=2025.01.26-16.39.22
DerivedDataCache.LastCompileMethod=Unknown
ShaderPreprocessor.TimeStamp=2025.01.26-16.39.37
ShaderPreprocessor.LastCompileMethod=Unknown
NullInstallBundleManager.TimeStamp=2025.01.26-16.39.33
NullInstallBundleManager.LastCompileMethod=Unknown
AssetRegistry.TimeStamp=2025.01.26-16.39.16
AssetRegistry.LastCompileMethod=Unknown
TargetDeviceServices.TimeStamp=2025.01.26-16.39.39
TargetDeviceServices.LastCompileMethod=Unknown
MeshUtilities.TimeStamp=2025.01.26-16.39.32
MeshUtilities.LastCompileMethod=Unknown
MaterialBaking.TimeStamp=2025.01.26-16.39.31
MaterialBaking.LastCompileMethod=Unknown
MeshMergeUtilities.TimeStamp=2025.01.26-16.39.32
MeshMergeUtilities.LastCompileMethod=Unknown
MeshReductionInterface.TimeStamp=2025.01.26-16.39.32
MeshReductionInterface.LastCompileMethod=Unknown
QuadricMeshReduction.TimeStamp=2025.01.26-16.39.34
QuadricMeshReduction.LastCompileMethod=Unknown
ProxyLODMeshReduction.TimeStamp=2025.01.26-16.47.59
ProxyLODMeshReduction.LastCompileMethod=Unknown
SkeletalMeshReduction.TimeStamp=2025.01.26-16.51.57
SkeletalMeshReduction.LastCompileMethod=Unknown
MeshBoneReduction.TimeStamp=2025.01.26-16.39.31
MeshBoneReduction.LastCompileMethod=Unknown
StaticMeshDescription.TimeStamp=2025.01.26-16.39.39
StaticMeshDescription.LastCompileMethod=Unknown
GeometryProcessingInterfaces.TimeStamp=2025.01.26-16.39.27
GeometryProcessingInterfaces.LastCompileMethod=Unknown
NaniteBuilder.TimeStamp=2025.01.26-16.39.33
NaniteBuilder.LastCompileMethod=Unknown
MeshBuilder.TimeStamp=2025.01.26-16.39.31
MeshBuilder.LastCompileMethod=Unknown
KismetCompiler.TimeStamp=2025.01.26-16.39.29
KismetCompiler.LastCompileMethod=Unknown
MovieSceneTools.TimeStamp=2025.01.26-16.39.32
MovieSceneTools.LastCompileMethod=Unknown
Sequencer.TimeStamp=2025.01.26-16.39.36
Sequencer.LastCompileMethod=Unknown
CurveEditor.TimeStamp=2025.01.26-16.39.21
CurveEditor.LastCompileMethod=Unknown
AssetDefinition.TimeStamp=2025.01.26-16.39.16
AssetDefinition.LastCompileMethod=Unknown
Core.TimeStamp=2025.01.26-16.39.20
Core.LastCompileMethod=Unknown
Networking.TimeStamp=2025.01.26-16.39.33
Networking.LastCompileMethod=Unknown
LiveCoding.TimeStamp=2025.01.26-16.39.30
LiveCoding.LastCompileMethod=Unknown
HeadMountedDisplay.TimeStamp=2025.01.26-16.39.27
HeadMountedDisplay.LastCompileMethod=Unknown
SourceCodeAccess.TimeStamp=2025.01.26-16.39.38
SourceCodeAccess.LastCompileMethod=Unknown
Messaging.TimeStamp=2025.01.26-16.39.32
Messaging.LastCompileMethod=Unknown
MRMesh.TimeStamp=2025.01.26-16.39.32
MRMesh.LastCompileMethod=Unknown
UnrealEd.TimeStamp=2025.01.26-16.39.43
UnrealEd.LastCompileMethod=Unknown
LandscapeEditorUtilities.TimeStamp=2025.01.26-16.39.30
LandscapeEditorUtilities.LastCompileMethod=Unknown
SubobjectDataInterface.TimeStamp=2025.01.26-16.39.39
SubobjectDataInterface.LastCompileMethod=Unknown
SlateCore.TimeStamp=2025.01.26-16.39.38
SlateCore.LastCompileMethod=Unknown
Slate.TimeStamp=2025.01.26-16.39.37
Slate.LastCompileMethod=Unknown
SlateReflector.TimeStamp=2025.01.26-16.39.38
SlateReflector.LastCompileMethod=Unknown
EditorStyle.TimeStamp=2025.01.26-16.39.23
EditorStyle.LastCompileMethod=Unknown
UMG.TimeStamp=2025.01.26-16.39.40
UMG.LastCompileMethod=Unknown
UMGEditor.TimeStamp=2025.01.26-16.39.41
UMGEditor.LastCompileMethod=Unknown
AssetTools.TimeStamp=2025.01.26-16.39.17
AssetTools.LastCompileMethod=Unknown
ScriptableEditorWidgets.TimeStamp=2025.01.26-16.39.36
ScriptableEditorWidgets.LastCompileMethod=Unknown
CollisionAnalyzer.TimeStamp=2025.01.26-16.39.19
CollisionAnalyzer.LastCompileMethod=Unknown
WorkspaceMenuStructure.TimeStamp=2025.01.26-16.39.43
WorkspaceMenuStructure.LastCompileMethod=Unknown
FunctionalTesting.TimeStamp=2025.01.26-16.39.27
FunctionalTesting.LastCompileMethod=Unknown
BehaviorTreeEditor.TimeStamp=2025.01.26-16.39.17
BehaviorTreeEditor.LastCompileMethod=Unknown
GameplayTasksEditor.TimeStamp=2025.01.26-16.39.27
GameplayTasksEditor.LastCompileMethod=Unknown
StringTableEditor.TimeStamp=2025.01.26-16.39.39
StringTableEditor.LastCompileMethod=Unknown
VREditor.TimeStamp=2025.01.26-16.39.43
VREditor.LastCompileMethod=Unknown
Overlay.TimeStamp=2025.01.26-16.39.33
Overlay.LastCompileMethod=Unknown
OverlayEditor.TimeStamp=2025.01.26-16.39.33
OverlayEditor.LastCompileMethod=Unknown
MediaAssets.TimeStamp=2025.01.26-16.39.31
MediaAssets.LastCompileMethod=Unknown
ClothingSystemRuntimeNv.TimeStamp=2025.01.26-16.39.19
ClothingSystemRuntimeNv.LastCompileMethod=Unknown
ClothingSystemEditor.TimeStamp=2025.01.26-16.39.19
ClothingSystemEditor.LastCompileMethod=Unknown
AnimationDataController.TimeStamp=2025.01.26-16.39.16
AnimationDataController.LastCompileMethod=Unknown
TimeManagement.TimeStamp=2025.01.26-16.39.39
TimeManagement.LastCompileMethod=Unknown
AnimGraph.TimeStamp=2025.01.26-16.39.16
AnimGraph.LastCompileMethod=Unknown
WorldPartitionEditor.TimeStamp=2025.01.26-16.39.44
WorldPartitionEditor.LastCompileMethod=Unknown
PacketHandler.TimeStamp=2025.01.26-16.39.33
PacketHandler.LastCompileMethod=Unknown
NetworkReplayStreaming.TimeStamp=2025.01.26-16.39.33
NetworkReplayStreaming.LastCompileMethod=Unknown
MassEntity.TimeStamp=2025.01.26-16.39.31
MassEntity.LastCompileMethod=Unknown
MassEntityTestSuite.TimeStamp=2025.01.26-16.39.31
MassEntityTestSuite.LastCompileMethod=Unknown
AndroidFileServer.TimeStamp=2025.01.26-16.54.32
AndroidFileServer.LastCompileMethod=Unknown
WebMMoviePlayer.TimeStamp=2025.01.26-16.56.55
WebMMoviePlayer.LastCompileMethod=Unknown
WindowsMoviePlayer.TimeStamp=2025.01.26-16.56.55
WindowsMoviePlayer.LastCompileMethod=Unknown
EnhancedInput.TimeStamp=2025.01.26-16.48.11
EnhancedInput.LastCompileMethod=Unknown
InputBlueprintNodes.TimeStamp=2025.01.26-16.48.11
InputBlueprintNodes.LastCompileMethod=Unknown
BlueprintGraph.TimeStamp=2025.01.26-16.39.17
BlueprintGraph.LastCompileMethod=Unknown
AnimationSharing.TimeStamp=2025.01.26-16.47.50
AnimationSharing.LastCompileMethod=Unknown
PropertyAccessNode.TimeStamp=2025.01.26-16.47.55
PropertyAccessNode.LastCompileMethod=Unknown
AssetManagerEditor.TimeStamp=2025.01.26-16.47.56
AssetManagerEditor.LastCompileMethod=Unknown
TreeMap.TimeStamp=2025.01.26-16.39.40
TreeMap.LastCompileMethod=Unknown
ContentBrowser.TimeStamp=2025.01.26-16.39.19
ContentBrowser.LastCompileMethod=Unknown
ContentBrowserData.TimeStamp=2025.01.26-16.39.19
ContentBrowserData.LastCompileMethod=Unknown
ToolMenus.TimeStamp=2025.01.26-16.39.39
ToolMenus.LastCompileMethod=Unknown
LevelEditor.TimeStamp=2025.01.26-16.39.30
LevelEditor.LastCompileMethod=Unknown
MainFrame.TimeStamp=2025.01.26-16.39.31
MainFrame.LastCompileMethod=Unknown
HotReload.TimeStamp=2025.01.26-16.39.28
HotReload.LastCompileMethod=Unknown
CommonMenuExtensions.TimeStamp=2025.01.26-16.39.19
CommonMenuExtensions.LastCompileMethod=Unknown
PixelInspectorModule.TimeStamp=2025.01.26-16.39.34
PixelInspectorModule.LastCompileMethod=Unknown
DataValidation.TimeStamp=2025.01.26-16.47.57
DataValidation.LastCompileMethod=Unknown
FacialAnimation.TimeStamp=2025.01.26-16.47.57
FacialAnimation.LastCompileMethod=Unknown
FacialAnimationEditor.TimeStamp=2025.01.26-16.47.57
FacialAnimationEditor.LastCompileMethod=Unknown
GameplayTagsEditor.TimeStamp=2025.01.26-16.47.57
GameplayTagsEditor.LastCompileMethod=Unknown
ChaosCaching.TimeStamp=2025.01.26-16.49.28
ChaosCaching.LastCompileMethod=Unknown
ChaosCachingEditor.TimeStamp=2025.01.26-16.49.28
ChaosCachingEditor.LastCompileMethod=Unknown
TakeRecorder.TimeStamp=2025.01.26-16.57.13
TakeRecorder.LastCompileMethod=Unknown
FullBodyIK.TimeStamp=2025.01.26-16.50.39
FullBodyIK.LastCompileMethod=Unknown
PBIK.TimeStamp=2025.01.26-16.50.39
PBIK.LastCompileMethod=Unknown
PythonScriptPlugin.TimeStamp=2025.01.26-16.51.55
PythonScriptPlugin.LastCompileMethod=Unknown
ActorSequence.TimeStamp=2025.01.26-16.54.08
ActorSequence.LastCompileMethod=Unknown
InterchangeNodes.TimeStamp=2025.01.26-16.53.49
InterchangeNodes.LastCompileMethod=Unknown
InterchangeFactoryNodes.TimeStamp=2025.01.26-16.53.49
InterchangeFactoryNodes.LastCompileMethod=Unknown
InterchangeImport.TimeStamp=2025.01.26-16.53.49
InterchangeImport.LastCompileMethod=Unknown
InterchangePipelines.TimeStamp=2025.01.26-16.53.49
InterchangePipelines.LastCompileMethod=Unknown
NNERuntimeORT.TimeStamp=2025.01.26-16.54.17
NNERuntimeORT.LastCompileMethod=Unknown
NNEEditor.TimeStamp=2025.01.26-16.39.33
NNEEditor.LastCompileMethod=Unknown
AudioSynesthesiaCore.TimeStamp=2025.01.26-16.54.32
AudioSynesthesiaCore.LastCompileMethod=Unknown
SignalProcessing.TimeStamp=2025.01.26-16.39.37
SignalProcessing.LastCompileMethod=Unknown
AudioSynesthesia.TimeStamp=2025.01.26-16.54.32
AudioSynesthesia.LastCompileMethod=Unknown
AudioAnalyzer.TimeStamp=2025.01.26-16.39.17
AudioAnalyzer.LastCompileMethod=Unknown
CableComponent.TimeStamp=2025.01.26-16.54.32
CableComponent.LastCompileMethod=Unknown
CustomMeshComponent.TimeStamp=2025.01.26-16.54.33
CustomMeshComponent.LastCompileMethod=Unknown
LocationServicesBPLibrary.TimeStamp=2025.01.26-16.55.34
LocationServicesBPLibrary.LastCompileMethod=Unknown
MetasoundGraphCore.TimeStamp=2025.01.26-16.55.37
MetasoundGraphCore.LastCompileMethod=Unknown
MetasoundGenerator.TimeStamp=2025.01.26-16.55.37
MetasoundGenerator.LastCompileMethod=Unknown
MetasoundFrontend.TimeStamp=2025.01.26-16.55.36
MetasoundFrontend.LastCompileMethod=Unknown
MetasoundStandardNodes.TimeStamp=2025.01.26-16.55.37
MetasoundStandardNodes.LastCompileMethod=Unknown
MetasoundEngine.TimeStamp=2025.01.26-16.55.36
MetasoundEngine.LastCompileMethod=Unknown
WaveTable.TimeStamp=2025.01.26-16.56.55
WaveTable.LastCompileMethod=Unknown
MetasoundEngineTest.TimeStamp=2025.01.26-16.55.36
MetasoundEngineTest.LastCompileMethod=Unknown
MetasoundEditor.TimeStamp=2025.01.26-16.55.36
MetasoundEditor.LastCompileMethod=Unknown
AudioWidgets.TimeStamp=2025.01.26-16.54.32
AudioWidgets.LastCompileMethod=Unknown
AdvancedWidgets.TimeStamp=2025.01.26-16.39.15
AdvancedWidgets.LastCompileMethod=Unknown
MsQuicRuntime.TimeStamp=2025.01.26-16.55.41
MsQuicRuntime.LastCompileMethod=Unknown
PropertyAccessEditor.TimeStamp=2025.01.26-16.56.28
PropertyAccessEditor.LastCompileMethod=Unknown
ProceduralMeshComponent.TimeStamp=2025.01.26-16.56.28
ProceduralMeshComponent.LastCompileMethod=Unknown
RigVM.TimeStamp=2025.01.26-16.56.30
RigVM.LastCompileMethod=Unknown
RigVMDeveloper.TimeStamp=2025.01.26-16.56.30
RigVMDeveloper.LastCompileMethod=Unknown
SignificanceManager.TimeStamp=2025.01.26-16.56.31
SignificanceManager.LastCompileMethod=Unknown
ResonanceAudio.TimeStamp=2025.01.26-16.56.29
ResonanceAudio.LastCompileMethod=Unknown
SoundFields.TimeStamp=2025.01.26-16.56.32
SoundFields.LastCompileMethod=Unknown
StateTreeModule.TimeStamp=2025.01.26-16.56.32
StateTreeModule.LastCompileMethod=Unknown
TraceServices.TimeStamp=2025.01.26-16.39.40
TraceServices.LastCompileMethod=Unknown
TraceAnalysis.TimeStamp=2025.01.26-16.39.39
TraceAnalysis.LastCompileMethod=Unknown
StateTreeTestSuite.TimeStamp=2025.01.26-16.56.32
StateTreeTestSuite.LastCompileMethod=Unknown
Synthesis.TimeStamp=2025.01.26-16.56.34
Synthesis.LastCompileMethod=Unknown
Paper2D.TimeStamp=2025.01.26-16.47.35
Paper2D.LastCompileMethod=Unknown
EnvironmentQueryEditor.TimeStamp=2025.01.26-16.47.35
EnvironmentQueryEditor.LastCompileMethod=Unknown
AnimationData.TimeStamp=2025.01.26-16.47.35
AnimationData.LastCompileMethod=Unknown
IKRig.TimeStamp=2025.01.26-16.47.41
IKRig.LastCompileMethod=Unknown
IKRigDeveloper.TimeStamp=2025.01.26-16.47.41
IKRigDeveloper.LastCompileMethod=Unknown
ControlRig.TimeStamp=2025.01.26-16.47.36
ControlRig.LastCompileMethod=Unknown
Constraints.TimeStamp=2025.01.26-16.39.19
Constraints.LastCompileMethod=Unknown
ControlRigDeveloper.TimeStamp=2025.01.26-16.47.36
ControlRigDeveloper.LastCompileMethod=Unknown
OptimusCore.TimeStamp=2025.01.26-16.47.40
OptimusCore.LastCompileMethod=Unknown
OptimusDeveloper.TimeStamp=2025.01.26-16.47.40
OptimusDeveloper.LastCompileMethod=Unknown
RigLogicLib.TimeStamp=2025.01.26-16.47.45
RigLogicLib.LastCompileMethod=Unknown
RigLogicLibTest.TimeStamp=2025.01.26-16.47.45
RigLogicLibTest.LastCompileMethod=Unknown
RigLogicDeveloper.TimeStamp=2025.01.26-16.47.45
RigLogicDeveloper.LastCompileMethod=Unknown
EngineCameras.TimeStamp=2025.01.26-16.47.47
EngineCameras.LastCompileMethod=Unknown
GameplayCameras.TimeStamp=2025.01.26-16.47.47
GameplayCameras.LastCompileMethod=Unknown
NiagaraCore.TimeStamp=2025.01.26-16.53.30
NiagaraCore.LastCompileMethod=Unknown
Niagara.TimeStamp=2025.01.26-16.53.30
Niagara.LastCompileMethod=Unknown
NiagaraEditor.TimeStamp=2025.01.26-16.53.32
NiagaraEditor.LastCompileMethod=Unknown
LevelSequence.TimeStamp=2025.01.26-16.39.30
LevelSequence.LastCompileMethod=Unknown
NiagaraAnimNotifies.TimeStamp=2025.01.26-16.53.30
NiagaraAnimNotifies.LastCompileMethod=Unknown
NiagaraSimCaching.TimeStamp=2025.01.26-16.53.49
NiagaraSimCaching.LastCompileMethod=Unknown
NiagaraSimCachingEditor.TimeStamp=2025.01.26-16.53.49
NiagaraSimCachingEditor.LastCompileMethod=Unknown
ImgMediaEngine.TimeStamp=2025.01.26-16.53.57
ImgMediaEngine.LastCompileMethod=Unknown
TcpMessaging.TimeStamp=2025.01.26-16.54.08
TcpMessaging.LastCompileMethod=Unknown
UdpMessaging.TimeStamp=2025.01.26-16.54.08
UdpMessaging.LastCompileMethod=Unknown
SQLiteCore.TimeStamp=2025.01.26-16.54.34
SQLiteCore.LastCompileMethod=Unknown
Concert.TimeStamp=2025.01.26-16.47.52
Concert.LastCompileMethod=Unknown
ConcertClient.TimeStamp=2025.01.26-16.47.52
ConcertClient.LastCompileMethod=Unknown
ConcertTransport.TimeStamp=2025.01.26-16.47.52
ConcertTransport.LastCompileMethod=Unknown
ConcertServer.TimeStamp=2025.01.26-16.47.52
ConcertServer.LastCompileMethod=Unknown
ConcertSyncCore.TimeStamp=2025.01.26-16.47.53
ConcertSyncCore.LastCompileMethod=Unknown
ChaosClothEditor.TimeStamp=2025.01.26-16.47.47
ChaosClothEditor.LastCompileMethod=Unknown
ChaosVD.TimeStamp=2025.01.26-16.47.49
ChaosVD.LastCompileMethod=Unknown
ChaosVDBlueprint.TimeStamp=2025.01.26-16.47.49
ChaosVDBlueprint.LastCompileMethod=Unknown
InputEditor.TimeStamp=2025.01.26-16.48.11
InputEditor.LastCompileMethod=Unknown
MeshPaintEditorMode.TimeStamp=2025.01.26-16.54.08
MeshPaintEditorMode.LastCompileMethod=Unknown
MeshPaintingToolset.TimeStamp=2025.01.26-16.54.08
MeshPaintingToolset.LastCompileMethod=Unknown
RenderGraphInsights.TimeStamp=2025.01.26-16.54.30
RenderGraphInsights.LastCompileMethod=Unknown
TraceUtilities.TimeStamp=2025.01.26-16.56.56
TraceUtilities.LastCompileMethod=Unknown
EditorTraceUtilities.TimeStamp=2025.01.26-16.56.56
EditorTraceUtilities.LastCompileMethod=Unknown
TraceTools.TimeStamp=2025.01.26-16.39.40
TraceTools.LastCompileMethod=Unknown
WorldMetricsCore.TimeStamp=2025.01.26-16.57.20
WorldMetricsCore.LastCompileMethod=Unknown
WorldMetricsTest.TimeStamp=2025.01.26-16.57.20
WorldMetricsTest.LastCompileMethod=Unknown
CsvMetrics.TimeStamp=2025.01.26-16.57.20
CsvMetrics.LastCompileMethod=Unknown
AnimationSharingEd.TimeStamp=2025.01.26-16.47.50
AnimationSharingEd.LastCompileMethod=Unknown
CLionSourceCodeAccess.TimeStamp=2025.01.26-16.47.51
CLionSourceCodeAccess.LastCompileMethod=Unknown
DumpGPUServices.TimeStamp=2025.01.26-16.47.54
DumpGPUServices.LastCompileMethod=Unknown
GitSourceControl.TimeStamp=2025.01.26-16.47.54
GitSourceControl.LastCompileMethod=Unknown
N10XSourceCodeAccess.TimeStamp=2025.01.26-16.47.54
N10XSourceCodeAccess.LastCompileMethod=Unknown
PluginUtils.TimeStamp=2025.01.26-16.47.55
PluginUtils.LastCompileMethod=Unknown
RiderSourceCodeAccess.TimeStamp=2025.01.26-16.47.55
RiderSourceCodeAccess.LastCompileMethod=Unknown
SubversionSourceControl.TimeStamp=2025.01.26-16.47.55
SubversionSourceControl.LastCompileMethod=Unknown
UObjectPlugin.TimeStamp=2025.01.26-16.47.55
UObjectPlugin.LastCompileMethod=Unknown
VisualStudioCodeSourceCodeAccess.TimeStamp=2025.01.26-16.47.55
VisualStudioCodeSourceCodeAccess.LastCompileMethod=Unknown
VisualStudioSourceCodeAccess.TimeStamp=2025.01.26-16.47.55
VisualStudioSourceCodeAccess.LastCompileMethod=Unknown
BlueprintHeaderView.TimeStamp=2025.01.26-16.47.56
BlueprintHeaderView.LastCompileMethod=Unknown
ChangelistReview.TimeStamp=2025.01.26-16.47.57
ChangelistReview.LastCompileMethod=Unknown
ColorGradingEditor.TimeStamp=2025.01.26-16.47.57
ColorGradingEditor.LastCompileMethod=Unknown
CurveEditorTools.TimeStamp=2025.01.26-16.47.57
CurveEditorTools.LastCompileMethod=Unknown
CryptoKeys.TimeStamp=2025.01.26-16.47.57
CryptoKeys.LastCompileMethod=Unknown
CryptoKeysOpenSSL.TimeStamp=2025.01.26-16.47.57
CryptoKeysOpenSSL.LastCompileMethod=Unknown
EditorDebugTools.TimeStamp=2025.01.26-16.47.57
EditorDebugTools.LastCompileMethod=Unknown
EditorScriptingUtilities.TimeStamp=2025.01.26-16.47.57
EditorScriptingUtilities.LastCompileMethod=Unknown
MaterialAnalyzer.TimeStamp=2025.01.26-16.47.59
MaterialAnalyzer.LastCompileMethod=Unknown
MeshLODToolset.TimeStamp=2025.01.26-16.47.59
MeshLODToolset.LastCompileMethod=Unknown
MobileLauncherProfileWizard.TimeStamp=2025.01.26-16.47.59
MobileLauncherProfileWizard.LastCompileMethod=Unknown
ModelingToolsEditorMode.TimeStamp=2025.01.26-16.47.59
ModelingToolsEditorMode.LastCompileMethod=Unknown
PluginBrowser.TimeStamp=2025.01.26-16.47.59
PluginBrowser.LastCompileMethod=Unknown
SequencerAnimTools.TimeStamp=2025.01.26-16.48.00
SequencerAnimTools.LastCompileMethod=Unknown
SpeedTreeImporter.TimeStamp=2025.01.26-16.48.01
SpeedTreeImporter.LastCompileMethod=Unknown
StylusInput.TimeStamp=2025.01.26-16.48.01
StylusInput.LastCompileMethod=Unknown
StylusInputDebugWidget.TimeStamp=2025.01.26-16.48.01
StylusInputDebugWidget.LastCompileMethod=Unknown
WorldPartitionHLODUtilities.TimeStamp=2025.01.26-16.48.11
WorldPartitionHLODUtilities.LastCompileMethod=Unknown
UMGWidgetPreview.TimeStamp=2025.01.26-16.48.01
UMGWidgetPreview.LastCompileMethod=Unknown
UVEditor.TimeStamp=2025.01.26-16.48.01
UVEditor.LastCompileMethod=Unknown
UVEditorTools.TimeStamp=2025.01.26-16.48.01
UVEditorTools.LastCompileMethod=Unknown
UVEditorToolsEditorOnly.TimeStamp=2025.01.26-16.48.01
UVEditorToolsEditorOnly.LastCompileMethod=Unknown
AdvancedRenamer.TimeStamp=2025.01.26-16.48.43
AdvancedRenamer.LastCompileMethod=Unknown
AutomationUtils.TimeStamp=2025.01.26-16.48.57
AutomationUtils.LastCompileMethod=Unknown
AutomationUtilsEditor.TimeStamp=2025.01.26-16.48.57
AutomationUtilsEditor.LastCompileMethod=Unknown
BackChannel.TimeStamp=2025.01.26-16.49.28
BackChannel.LastCompileMethod=Unknown
FractureEditor.TimeStamp=2025.01.26-16.49.28
FractureEditor.LastCompileMethod=Unknown
ChaosNiagara.TimeStamp=2025.01.26-16.50.36
ChaosNiagara.LastCompileMethod=Unknown
ChaosSolverEditor.TimeStamp=2025.01.26-16.50.36
ChaosSolverEditor.LastCompileMethod=Unknown
ChaosUserDataPT.TimeStamp=2025.01.26-16.50.36
ChaosUserDataPT.LastCompileMethod=Unknown
DataflowAssetTools.TimeStamp=2025.01.26-16.50.37
DataflowAssetTools.LastCompileMethod=Unknown
DataflowEnginePlugin.TimeStamp=2025.01.26-16.50.37
DataflowEnginePlugin.LastCompileMethod=Unknown
DataflowSimulation.TimeStamp=2025.01.26-16.39.21
DataflowSimulation.LastCompileMethod=Unknown
DataflowNodes.TimeStamp=2025.01.26-16.50.37
DataflowNodes.LastCompileMethod=Unknown
TedsCore.TimeStamp=2025.01.26-16.50.39
TedsCore.LastCompileMethod=Unknown
TypedElementFramework.TimeStamp=2025.01.26-16.39.40
TypedElementFramework.LastCompileMethod=Unknown
MassEntityEditor.TimeStamp=2025.01.26-16.39.31
MassEntityEditor.LastCompileMethod=Unknown
MassEntityDebugger.TimeStamp=2025.01.26-16.39.31
MassEntityDebugger.LastCompileMethod=Unknown
TedsUI.TimeStamp=2025.01.26-16.50.39
TedsUI.LastCompileMethod=Unknown
GeometryCollectionEditor.TimeStamp=2025.01.26-16.50.40
GeometryCollectionEditor.LastCompileMethod=Unknown
GeometryCollectionTracks.TimeStamp=2025.01.26-16.50.40
GeometryCollectionTracks.LastCompileMethod=Unknown
GeometryCollectionSequencer.TimeStamp=2025.01.26-16.50.40
GeometryCollectionSequencer.LastCompileMethod=Unknown
GeometryCollectionEngine.TimeStamp=2025.01.26-16.39.27
GeometryCollectionEngine.LastCompileMethod=Unknown
GeometryCollectionNodes.TimeStamp=2025.01.26-16.50.40
GeometryCollectionNodes.LastCompileMethod=Unknown
GeometryCollectionDepNodes.TimeStamp=2025.01.26-16.50.40
GeometryCollectionDepNodes.LastCompileMethod=Unknown
GeometryFlowCore.TimeStamp=2025.01.26-16.50.41
GeometryFlowCore.LastCompileMethod=Unknown
GeometryFlowMeshProcessing.TimeStamp=2025.01.26-16.50.41
GeometryFlowMeshProcessing.LastCompileMethod=Unknown
GeometryFlowMeshProcessingEditor.TimeStamp=2025.01.26-16.50.41
GeometryFlowMeshProcessingEditor.LastCompileMethod=Unknown
LocalizableMessage.TimeStamp=2025.01.26-16.50.47
LocalizableMessage.LastCompileMethod=Unknown
LocalizableMessageBlueprint.TimeStamp=2025.01.26-16.50.47
LocalizableMessageBlueprint.LastCompileMethod=Unknown
MeshModelingToolsExp.TimeStamp=2025.01.26-16.50.47
MeshModelingToolsExp.LastCompileMethod=Unknown
MeshModelingToolsEditorOnlyExp.TimeStamp=2025.01.26-16.50.47
MeshModelingToolsEditorOnlyExp.LastCompileMethod=Unknown
GeometryProcessingAdapters.TimeStamp=2025.01.26-16.50.47
GeometryProcessingAdapters.LastCompileMethod=Unknown
ModelingEditorUI.TimeStamp=2025.01.26-16.50.47
ModelingEditorUI.LastCompileMethod=Unknown
ModelingUI.TimeStamp=2025.01.26-16.50.47
ModelingUI.LastCompileMethod=Unknown
SkeletalMeshModifiers.TimeStamp=2025.01.26-16.50.47
SkeletalMeshModifiers.LastCompileMethod=Unknown
ToolPresetAsset.TimeStamp=2025.01.26-16.52.33
ToolPresetAsset.LastCompileMethod=Unknown
ToolPresetEditor.TimeStamp=2025.01.26-16.52.33
ToolPresetEditor.LastCompileMethod=Unknown
TemplateSequence.TimeStamp=2025.01.26-16.54.10
TemplateSequence.LastCompileMethod=Unknown
SequencerScripting.TimeStamp=2025.01.26-16.54.10
SequencerScripting.LastCompileMethod=Unknown
SequencerScriptingEditor.TimeStamp=2025.01.26-16.54.10
SequencerScriptingEditor.LastCompileMethod=Unknown
OnlineBase.TimeStamp=2025.01.26-16.54.17
OnlineBase.LastCompileMethod=Unknown
TakeMovieScene.TimeStamp=2025.01.26-16.57.13
TakeMovieScene.LastCompileMethod=Unknown
TakeSequencer.TimeStamp=2025.01.26-16.57.13
TakeSequencer.LastCompileMethod=Unknown
NNEDenoiser.TimeStamp=2025.01.26-16.54.12
NNEDenoiser.LastCompileMethod=Unknown
GLTFCore.TimeStamp=2025.01.26-16.53.49
GLTFCore.LastCompileMethod=Unknown
InterchangeMessages.TimeStamp=2025.01.26-16.53.49
InterchangeMessages.LastCompileMethod=Unknown
InterchangeExport.TimeStamp=2025.01.26-16.53.49
InterchangeExport.LastCompileMethod=Unknown
InterchangeDispatcher.TimeStamp=2025.01.26-16.53.49
InterchangeDispatcher.LastCompileMethod=Unknown
InterchangeCommon.TimeStamp=2025.01.26-16.53.49
InterchangeCommon.LastCompileMethod=Unknown
InterchangeCommonParser.TimeStamp=2025.01.26-16.53.49
InterchangeCommonParser.LastCompileMethod=Unknown
InterchangeFbxParser.TimeStamp=2025.01.26-16.53.49
InterchangeFbxParser.LastCompileMethod=Unknown
InterchangeEditor.TimeStamp=2025.01.26-16.53.49
InterchangeEditor.LastCompileMethod=Unknown
InterchangeEditorPipelines.TimeStamp=2025.01.26-16.53.49
InterchangeEditorPipelines.LastCompileMethod=Unknown
InterchangeEditorUtilities.TimeStamp=2025.01.26-16.53.49
InterchangeEditorUtilities.LastCompileMethod=Unknown
InterchangeTests.TimeStamp=2025.01.26-16.56.56
InterchangeTests.LastCompileMethod=Unknown
InterchangeTestEditor.TimeStamp=2025.01.26-16.56.56
InterchangeTestEditor.LastCompileMethod=Unknown
ActorLayerUtilities.TimeStamp=2025.01.26-16.54.30
ActorLayerUtilities.LastCompileMethod=Unknown
ActorLayerUtilitiesEditor.TimeStamp=2025.01.26-16.54.30
ActorLayerUtilitiesEditor.LastCompileMethod=Unknown
AndroidPermission.TimeStamp=2025.01.26-16.54.32
AndroidPermission.LastCompileMethod=Unknown
AppleImageUtils.TimeStamp=2025.01.26-16.54.32
AppleImageUtils.LastCompileMethod=Unknown
AppleImageUtilsBlueprintSupport.TimeStamp=2025.01.26-16.54.32
AppleImageUtilsBlueprintSupport.LastCompileMethod=Unknown
ArchVisCharacter.TimeStamp=2025.01.26-16.54.32
ArchVisCharacter.LastCompileMethod=Unknown
AudioCapture.TimeStamp=2025.01.26-16.54.32
AudioCapture.LastCompileMethod=Unknown
AudioCaptureWasapi.TimeStamp=2025.01.26-16.39.17
AudioCaptureWasapi.LastCompileMethod=Unknown
AssetTags.TimeStamp=2025.01.26-16.54.32
AssetTags.LastCompileMethod=Unknown
AudioWidgetsEditor.TimeStamp=2025.01.26-16.54.32
AudioWidgetsEditor.LastCompileMethod=Unknown
ComputeFrameworkEditor.TimeStamp=2025.01.26-16.54.33
ComputeFrameworkEditor.LastCompileMethod=Unknown
GeometryCacheEd.TimeStamp=2025.01.26-16.54.36
GeometryCacheEd.LastCompileMethod=Unknown
GeometryCacheSequencer.TimeStamp=2025.01.26-16.54.36
GeometryCacheSequencer.LastCompileMethod=Unknown
GeometryCacheStreamer.TimeStamp=2025.01.26-16.54.36
GeometryCacheStreamer.LastCompileMethod=Unknown
GeometryCache.TimeStamp=2025.01.26-16.54.36
GeometryCache.LastCompileMethod=Unknown
GeometryCacheTracks.TimeStamp=2025.01.26-16.54.36
GeometryCacheTracks.LastCompileMethod=Unknown
GeometryAlgorithms.TimeStamp=2025.01.26-16.54.37
GeometryAlgorithms.LastCompileMethod=Unknown
DynamicMesh.TimeStamp=2025.01.26-16.54.37
DynamicMesh.LastCompileMethod=Unknown
MeshFileUtils.TimeStamp=2025.01.26-16.54.37
MeshFileUtils.LastCompileMethod=Unknown
GooglePAD.TimeStamp=2025.01.26-16.54.56
GooglePAD.LastCompileMethod=Unknown
HairStrandsDeformer.TimeStamp=2025.01.26-16.55.00
HairStrandsDeformer.LastCompileMethod=Unknown
HairStrandsRuntime.TimeStamp=2025.01.26-16.55.00
HairStrandsRuntime.LastCompileMethod=Unknown
HairStrandsEditor.TimeStamp=2025.01.26-16.55.00
HairStrandsEditor.LastCompileMethod=Unknown
HairCardGeneratorFramework.TimeStamp=2025.01.26-16.55.00
HairCardGeneratorFramework.LastCompileMethod=Unknown
InputDebugging.TimeStamp=2025.01.26-16.55.34
InputDebugging.LastCompileMethod=Unknown
InputDebuggingEditor.TimeStamp=2025.01.26-16.55.34
InputDebuggingEditor.LastCompileMethod=Unknown
MeshModelingTools.TimeStamp=2025.01.26-16.55.35
MeshModelingTools.LastCompileMethod=Unknown
MeshModelingToolsEditorOnly.TimeStamp=2025.01.26-16.55.35
MeshModelingToolsEditorOnly.LastCompileMethod=Unknown
ModelingComponents.TimeStamp=2025.01.26-16.55.35
ModelingComponents.LastCompileMethod=Unknown
GeometryFramework.TimeStamp=2025.01.26-16.39.27
GeometryFramework.LastCompileMethod=Unknown
ModelingComponentsEditorOnly.TimeStamp=2025.01.26-16.55.35
ModelingComponentsEditorOnly.LastCompileMethod=Unknown
ModelingOperators.TimeStamp=2025.01.26-16.55.35
ModelingOperators.LastCompileMethod=Unknown
ModelingOperatorsEditorOnly.TimeStamp=2025.01.26-16.55.35
ModelingOperatorsEditorOnly.LastCompileMethod=Unknown
MobilePatchingUtils.TimeStamp=2025.01.26-16.55.41
MobilePatchingUtils.LastCompileMethod=Unknown
ProceduralMeshComponentEditor.TimeStamp=2025.01.26-16.56.28
ProceduralMeshComponentEditor.LastCompileMethod=Unknown
StateTreeEditorModule.TimeStamp=2025.01.26-16.56.32
StateTreeEditorModule.LastCompileMethod=Unknown
SynthesisEditor.TimeStamp=2025.01.26-16.56.34
SynthesisEditor.LastCompileMethod=Unknown
UnrealUSDWrapper.TimeStamp=2025.01.26-16.56.34
UnrealUSDWrapper.LastCompileMethod=Unknown
USDUtilities.TimeStamp=2025.01.26-16.56.34
USDUtilities.LastCompileMethod=Unknown
USDClasses.TimeStamp=2025.01.26-16.56.34
USDClasses.LastCompileMethod=Unknown
Paper2DEditor.TimeStamp=2025.01.26-16.47.35
Paper2DEditor.LastCompileMethod=Unknown
PaperSpriteSheetImporter.TimeStamp=2025.01.26-16.47.35
PaperSpriteSheetImporter.LastCompileMethod=Unknown
PaperTiledImporter.TimeStamp=2025.01.26-16.47.35
PaperTiledImporter.LastCompileMethod=Unknown
ACLPluginEditor.TimeStamp=2025.01.26-16.47.35
ACLPluginEditor.LastCompileMethod=Unknown
AnimationModifierLibrary.TimeStamp=2025.01.26-16.47.35
AnimationModifierLibrary.LastCompileMethod=Unknown
BlendSpaceMotionAnalysis.TimeStamp=2025.01.26-16.47.36
BlendSpaceMotionAnalysis.LastCompileMethod=Unknown
ControlRigSpline.TimeStamp=2025.01.26-16.47.40
ControlRigSpline.LastCompileMethod=Unknown
LiveLink.TimeStamp=2025.01.26-16.47.42
LiveLink.LastCompileMethod=Unknown
LiveLinkComponents.TimeStamp=2025.01.26-16.47.42
LiveLinkComponents.LastCompileMethod=Unknown
LiveLinkEditor.TimeStamp=2025.01.26-16.47.42
LiveLinkEditor.LastCompileMethod=Unknown
LiveLinkGraphNode.TimeStamp=2025.01.26-16.47.42
LiveLinkGraphNode.LastCompileMethod=Unknown
LiveLinkMovieScene.TimeStamp=2025.01.26-16.47.42
LiveLinkMovieScene.LastCompileMethod=Unknown
LiveLinkSequencer.TimeStamp=2025.01.26-16.47.42
LiveLinkSequencer.LastCompileMethod=Unknown
RigLogicModule.TimeStamp=2025.01.26-16.47.45
RigLogicModule.LastCompileMethod=Unknown
RigLogicEditor.TimeStamp=2025.01.26-16.47.45
RigLogicEditor.LastCompileMethod=Unknown
OodleNetworkHandlerComponent.TimeStamp=2025.01.26-16.47.50
OodleNetworkHandlerComponent.LastCompileMethod=Unknown
GameplayCamerasUncookedOnly.TimeStamp=2025.01.26-16.47.47
GameplayCamerasUncookedOnly.LastCompileMethod=Unknown
DatasmithContentEditor.TimeStamp=2025.01.26-16.48.25
DatasmithContentEditor.LastCompileMethod=Unknown
VariantManager.TimeStamp=2025.01.26-16.48.43
VariantManager.LastCompileMethod=Unknown
VariantManagerContentEditor.TimeStamp=2025.01.26-16.48.43
VariantManagerContentEditor.LastCompileMethod=Unknown
NiagaraBlueprintNodes.TimeStamp=2025.01.26-16.53.30
NiagaraBlueprintNodes.LastCompileMethod=Unknown
NiagaraEditorWidgets.TimeStamp=2025.01.26-16.53.32
NiagaraEditorWidgets.LastCompileMethod=Unknown
AlembicImporter.TimeStamp=2025.01.26-16.53.49
AlembicImporter.LastCompileMethod=Unknown
AlembicLibrary.TimeStamp=2025.01.26-16.53.49
AlembicLibrary.LastCompileMethod=Unknown
ImgMedia.TimeStamp=2025.01.26-16.53.57
ImgMedia.LastCompileMethod=Unknown
MediaCompositing.TimeStamp=2025.01.26-16.53.57
MediaCompositing.LastCompileMethod=Unknown
MediaPlate.TimeStamp=2025.01.26-16.53.57
MediaPlate.LastCompileMethod=Unknown
MediaPlateEditor.TimeStamp=2025.01.26-16.53.57
MediaPlateEditor.LastCompileMethod=Unknown
ContentBrowserAssetDataSource.TimeStamp=2025.01.26-16.47.57
ContentBrowserAssetDataSource.LastCompileMethod=Unknown
CollectionManager.TimeStamp=2025.01.26-16.39.19
CollectionManager.LastCompileMethod=Unknown
ContentBrowserClassDataSource.TimeStamp=2025.01.26-16.47.57
ContentBrowserClassDataSource.LastCompileMethod=Unknown
ContentBrowserFileDataSource.TimeStamp=2025.01.26-16.47.57
ContentBrowserFileDataSource.LastCompileMethod=Unknown
BaseCharacterFXEditor.TimeStamp=2025.01.26-16.50.36
BaseCharacterFXEditor.LastCompileMethod=Unknown
LightMixer.TimeStamp=2025.01.26-16.47.59
LightMixer.LastCompileMethod=Unknown
MetaHumanSDKEditor.TimeStamp=2025.01.26-16.50.49
MetaHumanSDKEditor.LastCompileMethod=Unknown
MetaHumanSDKRuntime.TimeStamp=2025.01.26-16.50.49
MetaHumanSDKRuntime.LastCompileMethod=Unknown
ObjectMixerEditor.TimeStamp=2025.01.26-16.47.59
ObjectMixerEditor.LastCompileMethod=Unknown
SkeletalMeshModelingTools.TimeStamp=2025.01.26-16.48.43
SkeletalMeshModelingTools.LastCompileMethod=Unknown
SkeletalMeshEditor.TimeStamp=2025.01.26-16.39.37
SkeletalMeshEditor.LastCompileMethod=Unknown
XInputDevice.TimeStamp=2025.01.26-16.56.55
XInputDevice.LastCompileMethod=Unknown
PortableObjectFileDataSource.TimeStamp=2025.01.26-16.47.59
PortableObjectFileDataSource.LastCompileMethod=Unknown
ConcertSyncClient.TimeStamp=2025.01.26-16.47.52
ConcertSyncClient.LastCompileMethod=Unknown
Bridge.TimeStamp=2025.01.26-17.11.43
Bridge.LastCompileMethod=Unknown
MegascansPlugin.TimeStamp=2025.01.26-17.11.45
MegascansPlugin.LastCompileMethod=Unknown
CmdLinkServer.TimeStamp=2025.01.26-16.47.49
CmdLinkServer.LastCompileMethod=Unknown
Fab.TimeStamp=2025.01.26-17.11.36
Fab.LastCompileMethod=Unknown
DataflowEditor.TimeStamp=2025.01.26-16.50.37
DataflowEditor.LastCompileMethod=Unknown
TakesCore.TimeStamp=2025.01.26-16.57.13
TakesCore.LastCompileMethod=Unknown
TakeTrackRecorders.TimeStamp=2025.01.26-16.57.13
TakeTrackRecorders.LastCompileMethod=Unknown
TakeRecorderSources.TimeStamp=2025.01.26-16.57.13
TakeRecorderSources.LastCompileMethod=Unknown
CacheTrackRecorder.TimeStamp=2025.01.26-16.57.13
CacheTrackRecorder.LastCompileMethod=Unknown
AudioSynesthesiaEditor.TimeStamp=2025.01.26-16.54.32
AudioSynesthesiaEditor.LastCompileMethod=Unknown
ProfileVisualizer.TimeStamp=2025.01.26-16.39.34
ProfileVisualizer.LastCompileMethod=Unknown
ImageWriteQueue.TimeStamp=2025.01.26-16.39.28
ImageWriteQueue.LastCompileMethod=Unknown
TypedElementRuntime.TimeStamp=2025.01.26-16.39.40
TypedElementRuntime.LastCompileMethod=Unknown
LevelInstanceEditor.TimeStamp=2025.01.26-16.39.30
LevelInstanceEditor.LastCompileMethod=Unknown
AIModule.TimeStamp=2025.01.26-16.39.15
AIModule.LastCompileMethod=Unknown
NavigationSystem.TimeStamp=2025.01.26-16.39.33
NavigationSystem.LastCompileMethod=Unknown
AITestSuite.TimeStamp=2025.01.26-16.39.15
AITestSuite.LastCompileMethod=Unknown
GameplayDebugger.TimeStamp=2025.01.26-16.39.27
GameplayDebugger.LastCompileMethod=Unknown
MessagingRpc.TimeStamp=2025.01.26-16.39.32
MessagingRpc.LastCompileMethod=Unknown
PortalRpc.TimeStamp=2025.01.26-16.39.34
PortalRpc.LastCompileMethod=Unknown
PortalServices.TimeStamp=2025.01.26-16.39.34
PortalServices.LastCompileMethod=Unknown
AnalyticsET.TimeStamp=2025.01.26-16.39.15
AnalyticsET.LastCompileMethod=Unknown
LauncherPlatform.TimeStamp=2025.01.26-16.39.30
LauncherPlatform.LastCompileMethod=Unknown
AudioMixerXAudio2.TimeStamp=2025.01.26-16.39.17
AudioMixerXAudio2.LastCompileMethod=Unknown
AudioMixer.TimeStamp=2025.01.26-16.39.17
AudioMixer.LastCompileMethod=Unknown
AudioMixerCore.TimeStamp=2025.01.26-16.39.17
AudioMixerCore.LastCompileMethod=Unknown
StreamingPauseRendering.TimeStamp=2025.01.26-16.39.39
StreamingPauseRendering.LastCompileMethod=Unknown
MovieScene.TimeStamp=2025.01.26-16.39.32
MovieScene.LastCompileMethod=Unknown
MovieSceneTracks.TimeStamp=2025.01.26-16.39.32
MovieSceneTracks.LastCompileMethod=Unknown
CinematicCamera.TimeStamp=2025.01.26-16.39.18
CinematicCamera.LastCompileMethod=Unknown
SparseVolumeTexture.TimeStamp=2025.01.26-16.39.38
SparseVolumeTexture.LastCompileMethod=Unknown
Documentation.TimeStamp=2025.01.26-16.39.23
Documentation.LastCompileMethod=Unknown
OutputLog.TimeStamp=2025.01.26-16.39.33
OutputLog.LastCompileMethod=Unknown
SourceControlWindows.TimeStamp=2025.01.26-16.39.38
SourceControlWindows.LastCompileMethod=Unknown
SourceControlWindowExtender.TimeStamp=2025.01.26-16.39.38
SourceControlWindowExtender.LastCompileMethod=Unknown
UncontrolledChangelists.TimeStamp=2025.01.26-16.39.41
UncontrolledChangelists.LastCompileMethod=Unknown
ClassViewer.TimeStamp=2025.01.26-16.39.19
ClassViewer.LastCompileMethod=Unknown
StructViewer.TimeStamp=2025.01.26-16.39.39
StructViewer.LastCompileMethod=Unknown
GraphEditor.TimeStamp=2025.01.26-16.39.27
GraphEditor.LastCompileMethod=Unknown
Kismet.TimeStamp=2025.01.26-16.39.29
Kismet.LastCompileMethod=Unknown
KismetWidgets.TimeStamp=2025.01.26-16.39.29
KismetWidgets.LastCompileMethod=Unknown
Persona.TimeStamp=2025.01.26-16.39.33
Persona.LastCompileMethod=Unknown
AdvancedPreviewScene.TimeStamp=2025.01.26-16.39.15
AdvancedPreviewScene.LastCompileMethod=Unknown
AnimationBlueprintEditor.TimeStamp=2025.01.26-16.39.15
AnimationBlueprintEditor.LastCompileMethod=Unknown
PackagesDialog.TimeStamp=2025.01.26-16.39.33
PackagesDialog.LastCompileMethod=Unknown
DetailCustomizations.TimeStamp=2025.01.26-16.39.22
DetailCustomizations.LastCompileMethod=Unknown
ComponentVisualizers.TimeStamp=2025.01.26-16.39.19
ComponentVisualizers.LastCompileMethod=Unknown
Layers.TimeStamp=2025.01.26-16.39.30
Layers.LastCompileMethod=Unknown
AutomationWindow.TimeStamp=2025.01.26-16.39.17
AutomationWindow.LastCompileMethod=Unknown
AutomationController.TimeStamp=2025.01.26-16.39.17
AutomationController.LastCompileMethod=Unknown
DeviceManager.TimeStamp=2025.01.26-16.39.22
DeviceManager.LastCompileMethod=Unknown
ProfilerClient.TimeStamp=
ProfilerClient.LastCompileMethod=Unknown
SessionFrontend.TimeStamp=2025.01.26-16.39.37
SessionFrontend.LastCompileMethod=Unknown
ProjectLauncher.TimeStamp=2025.01.26-16.39.34
ProjectLauncher.LastCompileMethod=Unknown
SettingsEditor.TimeStamp=2025.01.26-16.39.37
SettingsEditor.LastCompileMethod=Unknown
EditorSettingsViewer.TimeStamp=2025.01.26-16.39.23
EditorSettingsViewer.LastCompileMethod=Unknown
InternationalizationSettings.TimeStamp=2025.01.26-16.39.28
InternationalizationSettings.LastCompileMethod=Unknown
ProjectSettingsViewer.TimeStamp=2025.01.26-16.39.34
ProjectSettingsViewer.LastCompileMethod=Unknown
ProjectTargetPlatformEditor.TimeStamp=2025.01.26-16.39.34
ProjectTargetPlatformEditor.LastCompileMethod=Unknown
Blutility.TimeStamp=2025.01.26-16.39.17
Blutility.LastCompileMethod=Unknown
XmlParser.TimeStamp=2025.01.26-16.39.44
XmlParser.LastCompileMethod=Unknown
UndoHistory.TimeStamp=2025.01.26-16.39.41
UndoHistory.LastCompileMethod=Unknown
DeviceProfileEditor.TimeStamp=2025.01.26-16.39.22
DeviceProfileEditor.LastCompileMethod=Unknown
HardwareTargeting.TimeStamp=2025.01.26-16.39.27
HardwareTargeting.LastCompileMethod=Unknown
LocalizationDashboard.TimeStamp=2025.01.26-16.39.30
LocalizationDashboard.LastCompileMethod=Unknown
LocalizationService.TimeStamp=2025.01.26-16.39.30
LocalizationService.LastCompileMethod=Unknown
MergeActors.TimeStamp=2025.01.26-16.39.31
MergeActors.LastCompileMethod=Unknown
InputBindingEditor.TimeStamp=2025.01.26-16.39.28
InputBindingEditor.LastCompileMethod=Unknown
EditorInteractiveToolsFramework.TimeStamp=2025.01.26-16.39.23
EditorInteractiveToolsFramework.LastCompileMethod=Unknown
InteractiveToolsFramework.TimeStamp=2025.01.26-16.39.28
InteractiveToolsFramework.LastCompileMethod=Unknown
TraceInsights.TimeStamp=2025.01.26-16.39.40
TraceInsights.LastCompileMethod=Unknown
TraceInsightsCore.TimeStamp=2025.01.26-16.39.40
TraceInsightsCore.LastCompileMethod=Unknown
StaticMeshEditor.TimeStamp=2025.01.26-16.39.39
StaticMeshEditor.LastCompileMethod=Unknown
EditorFramework.TimeStamp=2025.01.26-16.39.23
EditorFramework.LastCompileMethod=Unknown
EditorConfig.TimeStamp=2025.01.26-16.39.23
EditorConfig.LastCompileMethod=Unknown
DerivedDataEditor.TimeStamp=2025.01.26-16.39.22
DerivedDataEditor.LastCompileMethod=Unknown
CSVtoSVG.TimeStamp=2025.01.26-16.39.21
CSVtoSVG.LastCompileMethod=Unknown
VirtualizationEditor.TimeStamp=2025.01.26-16.39.43
VirtualizationEditor.LastCompileMethod=Unknown
AnimationSettings.TimeStamp=2025.01.26-16.39.16
AnimationSettings.LastCompileMethod=Unknown
GameplayDebuggerEditor.TimeStamp=2025.01.26-16.39.27
GameplayDebuggerEditor.LastCompileMethod=Unknown
RenderResourceViewer.TimeStamp=2025.01.26-16.39.36
RenderResourceViewer.LastCompileMethod=Unknown
UniversalObjectLocatorEditor.TimeStamp=2025.01.26-16.39.41
UniversalObjectLocatorEditor.LastCompileMethod=Unknown
StructUtilsEditor.TimeStamp=2025.01.26-16.39.39
StructUtilsEditor.LastCompileMethod=Unknown
StructUtilsTestSuite.TimeStamp=2025.01.26-16.39.39
StructUtilsTestSuite.LastCompileMethod=Unknown
AndroidRuntimeSettings.TimeStamp=2025.01.26-16.38.39
AndroidRuntimeSettings.LastCompileMethod=Unknown
IOSRuntimeSettings.TimeStamp=2025.01.26-16.38.52
IOSRuntimeSettings.LastCompileMethod=Unknown
MacPlatformEditor.TimeStamp=2025.01.26-16.39.31
MacPlatformEditor.LastCompileMethod=Unknown
WindowsPlatformEditor.TimeStamp=2025.01.26-16.39.43
WindowsPlatformEditor.LastCompileMethod=Unknown
AndroidPlatformEditor.TimeStamp=2025.01.26-16.38.39
AndroidPlatformEditor.LastCompileMethod=Unknown
AndroidDeviceDetection.TimeStamp=2025.01.26-16.38.39
AndroidDeviceDetection.LastCompileMethod=Unknown
PIEPreviewDeviceProfileSelector.TimeStamp=2025.01.26-16.39.34
PIEPreviewDeviceProfileSelector.LastCompileMethod=Unknown
IOSPlatformEditor.TimeStamp=2025.01.26-16.38.52
IOSPlatformEditor.LastCompileMethod=Unknown
LogVisualizer.TimeStamp=2025.01.26-16.39.30
LogVisualizer.LastCompileMethod=Unknown
WidgetRegistration.TimeStamp=2025.01.26-16.39.43
WidgetRegistration.LastCompileMethod=Unknown
ClothPainter.TimeStamp=2025.01.26-16.39.19
ClothPainter.LastCompileMethod=Unknown
ViewportInteraction.TimeStamp=2025.01.26-16.39.43
ViewportInteraction.LastCompileMethod=Unknown
EditorWidgets.TimeStamp=2025.01.26-16.39.23
EditorWidgets.LastCompileMethod=Unknown
ViewportSnapping.TimeStamp=2025.01.26-16.39.43
ViewportSnapping.LastCompileMethod=Unknown
PlacementMode.TimeStamp=2025.01.26-16.39.34
PlacementMode.LastCompileMethod=Unknown
MeshPaint.TimeStamp=2025.01.26-16.39.32
MeshPaint.LastCompileMethod=Unknown
SessionServices.TimeStamp=2025.01.26-16.39.37
SessionServices.LastCompileMethod=Unknown
EngineAssetDefinitions.TimeStamp=2025.01.26-16.47.57
EngineAssetDefinitions.LastCompileMethod=Unknown
GeometryMode.TimeStamp=2025.01.26-16.47.57
GeometryMode.LastCompileMethod=Unknown
BspMode.TimeStamp=2025.01.26-16.47.57
BspMode.LastCompileMethod=Unknown
TextureAlignMode.TimeStamp=2025.01.26-16.47.57
TextureAlignMode.LastCompileMethod=Unknown
CharacterAI.TimeStamp=2025.01.26-16.50.36
CharacterAI.LastCompileMethod=Unknown
FractureEngine.TimeStamp=2025.01.26-16.50.39
FractureEngine.LastCompileMethod=Unknown
PlanarCut.TimeStamp=2025.01.26-16.51.54
PlanarCut.LastCompileMethod=Unknown
ActorSequenceEditor.TimeStamp=2025.01.26-16.54.08
ActorSequenceEditor.LastCompileMethod=Unknown
LevelSequenceEditor.TimeStamp=2025.01.26-16.54.08
LevelSequenceEditor.LastCompileMethod=Unknown
TemplateSequenceEditor.TimeStamp=2025.01.26-16.54.10
TemplateSequenceEditor.LastCompileMethod=Unknown
AndroidFileServerEditor.TimeStamp=2025.01.26-16.54.32
AndroidFileServerEditor.LastCompileMethod=Unknown
AudioCaptureEditor.TimeStamp=2025.01.26-16.54.32
AudioCaptureEditor.LastCompileMethod=Unknown
GooglePADEditor.TimeStamp=2025.01.26-16.54.56
GooglePADEditor.LastCompileMethod=Unknown
RigVMEditor.TimeStamp=2025.01.26-16.56.30
RigVMEditor.LastCompileMethod=Unknown
ResonanceAudioEditor.TimeStamp=2025.01.26-16.56.29
ResonanceAudioEditor.LastCompileMethod=Unknown
WaveTableEditor.TimeStamp=2025.01.26-16.56.55
WaveTableEditor.LastCompileMethod=Unknown
SmartSnapping.TimeStamp=2025.01.26-16.47.35
SmartSnapping.LastCompileMethod=Unknown
IKRigEditor.TimeStamp=2025.01.26-16.47.42
IKRigEditor.LastCompileMethod=Unknown
ControlRigEditor.TimeStamp=2025.01.26-16.47.36
ControlRigEditor.LastCompileMethod=Unknown
OptimusEditor.TimeStamp=2025.01.26-16.47.40
OptimusEditor.LastCompileMethod=Unknown
LiveLinkMultiUser.TimeStamp=2025.01.26-16.47.42
LiveLinkMultiUser.LastCompileMethod=Unknown
CameraShakePreviewer.TimeStamp=2025.01.26-16.47.47
CameraShakePreviewer.LastCompileMethod=Unknown
GameplayCamerasEditor.TimeStamp=2025.01.26-16.47.47
GameplayCamerasEditor.LastCompileMethod=Unknown
AndroidMediaEditor.TimeStamp=2025.01.26-16.53.54
AndroidMediaEditor.LastCompileMethod=Unknown
AndroidMediaFactory.TimeStamp=2025.01.26-16.53.54
AndroidMediaFactory.LastCompileMethod=Unknown
AvfMediaEditor.TimeStamp=2025.01.26-16.53.54
AvfMediaEditor.LastCompileMethod=Unknown
AvfMediaFactory.TimeStamp=2025.01.26-16.53.54
AvfMediaFactory.LastCompileMethod=Unknown
ImgMediaEditor.TimeStamp=2025.01.26-16.53.57
ImgMediaEditor.LastCompileMethod=Unknown
ImgMediaFactory.TimeStamp=2025.01.26-16.53.57
ImgMediaFactory.LastCompileMethod=Unknown
OpenExrWrapper.TimeStamp=2025.01.26-16.53.57
OpenExrWrapper.LastCompileMethod=Unknown
MediaCompositingEditor.TimeStamp=2025.01.26-16.53.57
MediaCompositingEditor.LastCompileMethod=Unknown
SequenceRecorder.TimeStamp=2025.01.26-16.39.36
SequenceRecorder.LastCompileMethod=Unknown
WebMMedia.TimeStamp=2025.01.26-16.54.06
WebMMedia.LastCompileMethod=Unknown
WebMMediaEditor.TimeStamp=2025.01.26-16.54.06
WebMMediaEditor.LastCompileMethod=Unknown
WebMMediaFactory.TimeStamp=2025.01.26-16.54.06
WebMMediaFactory.LastCompileMethod=Unknown
MediaPlayerEditor.TimeStamp=2025.01.26-16.53.57
MediaPlayerEditor.LastCompileMethod=Unknown
WmfMediaEditor.TimeStamp=2025.01.26-16.54.06
WmfMediaEditor.LastCompileMethod=Unknown
WmfMediaFactory.TimeStamp=2025.01.26-16.54.06
WmfMediaFactory.LastCompileMethod=Unknown
ActorPickerMode.TimeStamp=2025.01.26-16.39.15
ActorPickerMode.LastCompileMethod=Unknown
SceneDepthPickerMode.TimeStamp=2025.01.26-16.39.36
SceneDepthPickerMode.LastCompileMethod=Unknown
LandscapeEditor.TimeStamp=2025.01.26-16.39.30
LandscapeEditor.LastCompileMethod=Unknown
FoliageEdit.TimeStamp=2025.01.26-16.39.27
FoliageEdit.LastCompileMethod=Unknown
VirtualTexturingEditor.TimeStamp=2025.01.26-16.39.43
VirtualTexturingEditor.LastCompileMethod=Unknown
AutomationWorker.TimeStamp=2025.01.26-16.39.17
AutomationWorker.LastCompileMethod=Unknown
SequenceRecorderSections.TimeStamp=2025.01.26-16.39.37
SequenceRecorderSections.LastCompileMethod=Unknown
StatsViewer.TimeStamp=2025.01.26-16.39.39
StatsViewer.LastCompileMethod=Unknown
DataLayerEditor.TimeStamp=2025.01.26-16.39.21
DataLayerEditor.LastCompileMethod=Unknown
AndroidDeviceProfileSelector.TimeStamp=2025.01.26-16.54.32
AndroidDeviceProfileSelector.LastCompileMethod=Unknown
GameProjectGeneration.TimeStamp=2025.01.26-16.39.27
GameProjectGeneration.LastCompileMethod=Unknown
UnsavedAssetsTracker.TimeStamp=2025.01.26-16.39.43
UnsavedAssetsTracker.LastCompileMethod=Unknown
StatusBar.TimeStamp=2025.01.26-16.39.39
StatusBar.LastCompileMethod=Unknown
SceneOutliner.TimeStamp=2025.01.26-16.39.36
SceneOutliner.LastCompileMethod=Unknown
SubobjectEditor.TimeStamp=2025.01.26-16.39.39
SubobjectEditor.LastCompileMethod=Unknown
AddContentDialog.TimeStamp=2025.01.26-16.39.15
AddContentDialog.LastCompileMethod=Unknown
WidgetCarousel.TimeStamp=2025.01.26-16.39.43
WidgetCarousel.LastCompileMethod=Unknown
HierarchicalLODOutliner.TimeStamp=2025.01.26-16.39.27
HierarchicalLODOutliner.LastCompileMethod=Unknown
Voice.TimeStamp=2025.01.26-16.39.43
Voice.LastCompileMethod=Unknown
MovieSceneCapture.TimeStamp=2025.01.26-16.39.32
MovieSceneCapture.LastCompileMethod=Unknown
WebBrowser.TimeStamp=2025.01.26-16.39.43
WebBrowser.LastCompileMethod=Unknown
HierarchicalLODUtilities.TimeStamp=2025.01.26-16.39.28
HierarchicalLODUtilities.LastCompileMethod=Unknown

[Python]
LastDirectory=
RecentsFiles=C:/Program Files/Epic Games/UE_5.5/Engine/Plugins/Animation/ControlRig/Content/Python/init_unreal.py
