HAND42/Polydog-Robotic_Project_2022-2023/Code_plateformio/src/Simulation/read_port.py

import serial.tools.list_ports

ports = serial.tools.list_ports.comports()
serialInst = serial.Serial()
portVar = ""

portsList = []

for onePort in ports:
    portsList.append(str(onePort))
    print(str(onePort))

val = input("Select Port: COM")

for x in range(0, len(portsList)):
    if portsList[x].startswith("COM" + str(val)):
        portVar = "COM" + str(val)
        print(portVar)

serialInst.baudrate = 9600
serialInst.port = portVar
serialInst.open()

while True:
    if serialInst.in_waiting:
        packet = serialInst.readline()
        print(packet.decode('utf').rstrip('\n'))
