HAND42/Polydog-Robotic_Project_2022-2023/polydog_ws_ROS/polydog_ws/polydog_ws/src/polydog_controller/scripts/TrotGaitController.py

#!/usr/bin/env python3

import numpy as np
import rospy
from GaitController import GaitController
from PIDController import PID_controller
from PIDControllerZ import PID_controllerZ
from Transformations import rotxyz,rotz


class TrotGaitController(GaitController):
    def __init__(self, default_stance, stance_time, swing_time, time_step, use_imu):
        self.use_imu = True
        #self.use_button = True
        self.autoRest = True
        self.trotNeeded = True
        self.msg = None
                
                                   
        contact_phases = np.array([[1, 0, 1, 1],  # 0: Leg swing
                                   [1, 1, 1, 0],  # 1: Moving stance forward
                                   [1, 1, 1, 0],  
                                   [1, 0, 1, 1]])
        
            
        z_error_constant = 0.02 * 5    # This constant determines how fast we move
                                       # toward the goal in the z direction
        

        z_leg_lift = 0.04

        super().__init__(stance_time, swing_time, time_step, contact_phases, default_stance)

        self.max_x_velocity = 0.024 #[m/s] 
        self.max_y_velocity = 0.015 #[m/s]
        self.max_yaw_rate = 0.2 #[rad/s]


        self.swingController = TrotSwingController(self.stance_ticks, self.swing_ticks, self.time_step,
                                                   self.phase_length, z_leg_lift, self.default_stance)

        self.stanceController = TrotStanceController(self.phase_length, self.stance_ticks, self.swing_ticks,
                                                     self.time_step, z_error_constant)


        # TODO: tune kp, ki and kd
        #                                     kp    ki    kd
        #self.pid_controller = PID_controller(0.04, 0.007, 0.001)
        #self.pid_controllerZ = PID_controllerZ(0.1, 0, 0)
        self.pid_controller = PID_controller(0.01, 0.00, 0.00)
        self.pid_controllerZ = PID_controllerZ(0, 0, 0)

    def updateStateCommand(self, msg, state, command):
        self.msg = msg
        command.velocity[0] = msg.axes[1] * self.max_x_velocity
        #command.velocity[1] = msg.axes[0] * self.max_y_velocity
        command.yaw_rate = msg.axes[3] * self.max_yaw_rate
        #if command.follow_event :
            #print(state.x)
            #compensation = self.pid_controller.run(0, 0, state.x)
            #yaw_compensation = compensation[2]
            #print(compensation[2])
            #command.yaw_rate = compensation[2] * self.max_yaw_rate


            

    def follow(self, msg2, command):
        #print(msg2.data[1])
        pass

    def navigate(self, msg3, command):
        pass

    def stabilize(self, msg4,state,command):
        pass  


    def step(self, state, command):
        new_foot_locations = np.zeros((3,4))
        if self.autoRest:
            if command.velocity[0] == 0 and command.velocity[1] == 0 and command.yaw_rate == 0:
                if state.ticks % (2 * self.phase_length) == 0:
                    self.trotNeeded = False
                
            else:
                self.trotNeeded = True

        if self.trotNeeded:
            contact_modes = self.contacts(state.ticks)

            #new_foot_locations = np.zeros((3,4))
            for leg_index in range(4):
                contact_mode = contact_modes[leg_index]
                if contact_mode == 1:
                    new_location = self.stanceController.next_foot_location(leg_index, state, command)
                else:
                    swing_proportion = float(self.subphase_ticks(state.ticks)) / float(self.swing_ticks)

                    new_location = self.swingController.next_foot_location(swing_proportion,leg_index,state,command)

                new_foot_locations[:, leg_index] = new_location

            # tilt compensation
            if self.use_imu:
                print("IMU IS USED")
                compensation = self.pid_controller.run(state.imu_roll, state.imu_pitch, state.imu_yaw)
                #print(state.imu_roll)
                #print(state.imu_pitch)
                #print(state.imu_yaw)
                roll_compensation = 0 #-compensation[0]
                pitch_compensation = 0 #-compensation[1]
                yaw_compensation = 0#-compensation[2]

                rot = rotxyz(roll_compensation, pitch_compensation,yaw_compensation)
                new_foot_locations = np.matmul(rot, new_foot_locations)

                #print(state.imu_yaw)
                #compensationz = self.pid_controllerZ.run(state.imu_yaw)
                #yaw_compensationz = compensationz[0]
                #if self.msg is not None:
                    #z_value = self.msg.angular.z + state.imu_yaw
                    #print(z_value)
                    #if z_value - 0.087 < state.imu_yaw and z_value + 0.087 > state.imu_yaw :
                        #command.yaw_rate = 0 * self.max_yaw_rate
                    #elif z_value == state.imu_yaw :
                        #command.yaw_rate = 0 * self.max_yaw_rate
                    #else :
                        #command.yaw_rate = yaw_compensationz * self.max_yaw_rate

            state.ticks += 1
            return new_foot_locations
        else:
            
            #if command.follow_event :
                #print(state.x)
               # compensation = self.pid_controller.run(0, 0, state.x)
                #print(state.imu_roll)
                #print(state.imu_pitch)
                #print(state.imu_yaw)
                #roll_compensation = 0 #-compensation[0]
                #pitch_compensation = 0 #-compensation[1]
                #yaw_compensation = compensation[2]

                #rot = rotxyz(roll_compensation, pitch_compensation,yaw_compensation)
                #new_foot_locations = np.matmul(rot, new_foot_locations)
        
            temp = self.default_stance
            temp[2] = [command.robot_height] * 4
            return temp


    def run(self, state, command):
        state.foot_locations = self.step(state, command)
        state.robot_height = command.robot_height

        return state.foot_locations

class TrotSwingController(object):
    def __init__(self, stance_ticks, swing_ticks, time_step, phase_length, z_leg_lift, default_stance):
        self.stance_ticks = stance_ticks
        self.swing_ticks = swing_ticks
        self.time_step = time_step
        self.phase_length = phase_length
        self.z_leg_lift = z_leg_lift
        self.default_stance = default_stance

    def raibert_touchdown_location(self, leg_index, command):
        delta_pos_2d = command.velocity * self.phase_length * self.time_step
        delta_pos = np.array([delta_pos_2d[0], delta_pos_2d[1], 0])

        theta = self.stance_ticks * self.time_step * command.yaw_rate
        rotation = rotz(theta)

        return np.matmul(rotation, self.default_stance[:, leg_index]) + delta_pos

    def swing_height(self, swing_phase):
        if swing_phase < 0.5:
            swing_height_ = swing_phase / 0.5 * self.z_leg_lift
        else:
            swing_height_ = self.z_leg_lift * (1 - (swing_phase - 0.5) / 0.5)
        return swing_height_

    def next_foot_location(self, swing_prop, leg_index, state, command):
        assert swing_prop >= 0 and swing_prop <= 1
        foot_location = state.foot_locations[:, leg_index]
        swing_height_ = self.swing_height(swing_prop)
        touchdown_location = self.raibert_touchdown_location(leg_index, command)

        time_left = self.time_step* self.swing_ticks * (1.0 - swing_prop)
        
        velocity = (touchdown_location - foot_location) / float(time_left) *\
             np.array([1, 1, 0])

        delta_foot_location = velocity * self.time_step
        z_vector = np.array([0, 0, swing_height_ + command.robot_height])
        return foot_location * np.array([1, 1, 0]) + z_vector + delta_foot_location

class TrotStanceController(object):
    def __init__(self,phase_length, stance_ticks, swing_ticks, time_step, z_error_constant):
        self.phase_length = phase_length
        self.stance_ticks = stance_ticks
        self.swing_ticks = swing_ticks
        self.time_step = time_step
        self.z_error_constant = z_error_constant

    def position_delta(self, leg_index, state, command):
        z = state.foot_locations[2, leg_index]

        step_dist_x = command.velocity[0] *\
                      (float(self.phase_length)/self.swing_ticks)

        step_dist_y = command.velocity[1] *\
                      (float(self.phase_length)/self.swing_ticks)

        velocity = np.array([-(step_dist_x/4)/(float(self.time_step)*self.stance_ticks), 
                             -(step_dist_y/4)/(float(self.time_step)*self.stance_ticks), 
                             1.0 / self.z_error_constant * (state.robot_height - z)])

        delta_pos = velocity * self.time_step
        delta_ori = rotz(-command.yaw_rate * self.time_step)
        return (delta_pos, delta_ori)

    def next_foot_location(self, leg_index, state, command):
        foot_location = state.foot_locations[:, leg_index]
        (delta_pos, delta_ori) = self.position_delta(leg_index, state, command)
        next_foot_location = np.matmul(delta_ori, foot_location) + delta_pos
        return next_foot_location
