HAND42/Polydog-Robotic_Project_2022-2023/polydog_ws_ROS/polydog_ws/polydog_ws/src/polydog_controller/scripts/PIDController.py

#!/usr/bin/env python3

import rospy
import numpy as np

class PID_controller(object):
    def __init__(self, kp, ki, kd):
        self.kp = kp
        self.ki = ki
        self.kd = kd

        # desired roll, pitch, and yaw angles
        self.desired_rpy = np.array([80, 0.0, 0])

        self.I_term = np.array([0.0, 0.0, 0.0])
        self.D_term = np.array([0.0, 0.0, 0.0])

        # TODO: Tune max_I
        self.max_I = 1
        self.last_error = np.array([0.0, 0.0, 0.0])
        

    def run(self, roll, pitch, yaw):
        # determine error
        error = self.desired_rpy - np.array([roll, pitch, yaw])
        

        if -40 <= error[0] <= 40 :
            return np.array([0.0, 0.0, 0.0])

        # determine time step
        t_now = rospy.Time.now()
        step = (t_now - self.last_time).to_sec()

        # Check if step is zero or close to zero
        if abs(step) < 1e-6:
            return np.array([0.0, 0.0, 0.0])

        # I term update
        self.I_term = self.I_term + error * step

        # anti-windup
        for i in range(3):
            if self.I_term[i] < -self.max_I:
                self.I_term[i] = -self.max_I
            elif self.I_term[i] > self.max_I:
                self.I_term[i] = self.max_I

        # approximate first derivative
        self.D_term = (error - self.last_error) / step

        # update last values
        self.last_time = t_now
        self.last_error = error

        # compute return values
        P_ret = self.kp * error
        I_ret = self.I_term * self.ki
        D_ret = self.D_term * self.kd

        return P_ret + I_ret + D_ret

    def reset(self):
        self.last_time = rospy.Time.now()
        self.I_term = np.array([0.0, 0.0, 0.0])
        self.D_term = np.array([0.0, 0.0, 0.0])
        self.last_error = np.array([0.0, 0.0, 0.0])

    def desired_RPY_angles(self, des_roll, des_pitch, des_yaw):
        # set desired roll, pitch, and yaw angles
        self.desired_rpy = np.array([des_roll, des_pitch, des_yaw])
