HAND42/Polydog-Robotic_Project_2022-2023/polydog_ws_ROS/polydog_ws/polydog_ws/src/polydog_controller/scripts/StandController.py

#!/usr/bin/env python3

import rospy
import numpy as np

class StandController(object):
    def __init__(self, default_stance):
        self.def_stance = default_stance
        self.max_reach = 0.065

        self.FR_X = 0.
        self.FR_Y = 0.
        self.FL_X = 0.
        self.FL_Y = 0.

    def updateStateCommand(self,msg,state,command):
        state.body_local_position[0] = msg.axes[7] * 0.14;
        self.FR_X = msg.axes[1]
        self.FR_Y = msg.axes[0]

        self.FL_X = msg.axes[4]
        self.FL_Y = msg.axes[3]

    @property
    def default_stance(self):
        a = np.copy(self.def_stance)
        return a
    
    def follow(self, msg2,command):
        pass
       
    def navigate(self, msg3, command):
        pass
 
    def stabilize(self, msg4,state,command):
        pass                  

    def run(self,state,command):
        temp = self.default_stance
        temp[2] = [command.robot_height] * 4
        
        temp[1][0] += self.FR_Y * self.max_reach
        temp[0][0] += self.FR_X * self.max_reach

        temp[1][1] += self.FL_Y * self.max_reach
        temp[0][1] += self.FL_X * self.max_reach
            
        state.foot_locations = temp
        return state.foot_locations
