HAND42/Polydog-Robotic_Project_2022-2023/polydog_ws_ROS/polydog_ws/polydog_ws/src/polydog_controller/scripts/StateCommand.py

#!/usr/bin/env python3


import numpy as np
from enum import Enum

class BehaviorState(Enum):
    REST = 0
    TROT = 1
    CRAWL = 2
    STAND = 3
    FOLLOW = 4
    NAVIGATE = 5

class State(object):
    def __init__(self,default_height):
        self.velocity = np.array([0., 0.])
        self.yaw_rate = 0.
        self.robot_height = -default_height

        self.foot_locations = np.zeros((3,4))

        self.body_local_position = np.array([0., 0., 0.])
        self.body_local_orientation = np.array([0., 0., 0.])
        
        self.imu_roll = 0.
        self.imu_pitch = 0.
        self.imu_yaw = 0.
        
        self.distance = 0.
        self.x = 0.
        self.y = 0.
        
        self.ticks = 0
        self.behavior_state = BehaviorState.REST

class Command(object):
    def __init__(self,default_height):
        self.velocity = np.array([0., 0.])
        self.yaw_rate = 0.
        self.robot_height = -default_height

        self.trot_event = False
        self.crawl_event = False
        self.rest_event = False
        self.stand_event = False
        self.follow_event = False
        self.navigate_event = False
