HAND42/Polydog-Robotic_Project_2022-2023/(commit log)

2022-10-22 Add plateformIO ecosystem and the C++ class tree structure
2022-11-15 Projet Boitier Arduino
    [Boitier Arduino v1.f3d]
2023-01-20 Arduino UNO Housing printing parts
    [ArduinoUNO-Housing.f3d, Boitier Arduino v1.f3d, Plastic_component.3mf, Plastic_link_component.3mf]
2023-01-20 Update code plateformIO
2023-02-01 Change code-plateformio repository
2023-05-14 Update math - writing article and project report
    [material and engineer cost.xlsx]
