HAND42/Polydog-Robotic_Project_2022-2023/session-reports/reports_younes-bazi/session5/Session05/20221125_114418.jpg

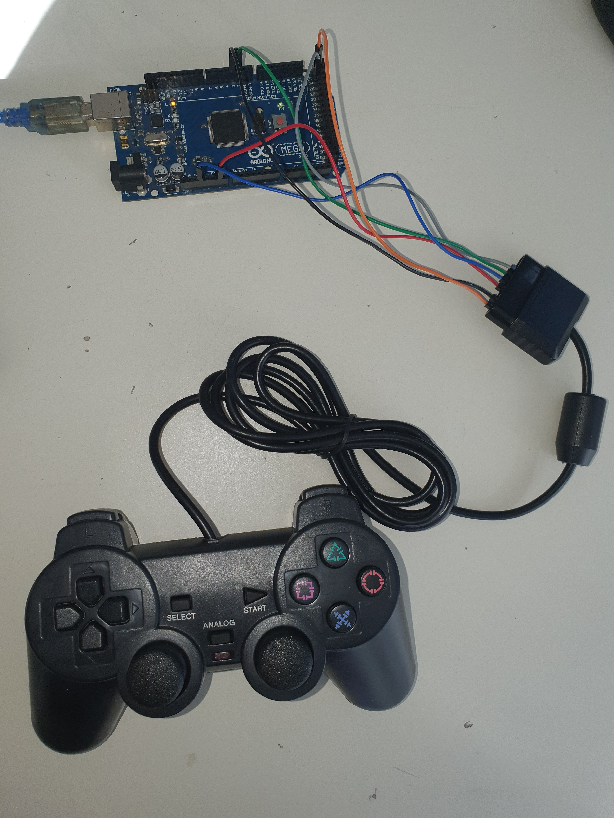
[picture p68: session-reports/reports_younes-bazi/session5/Session05/20221125_114418.jpg]
session-reports/reports_younes-bazi/session5/Session05/20221125_114418.jpg
